ProjectKitchen/RoboFriend/datasheets/uc/pinout-b.png

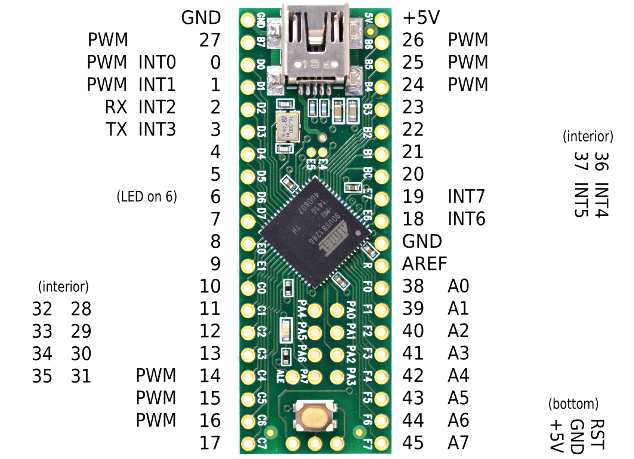
datasheets/uc/pinout-b.png
