ProjectKitchen/RoboFriend/src/TabletGUI/data/happyM.PNG

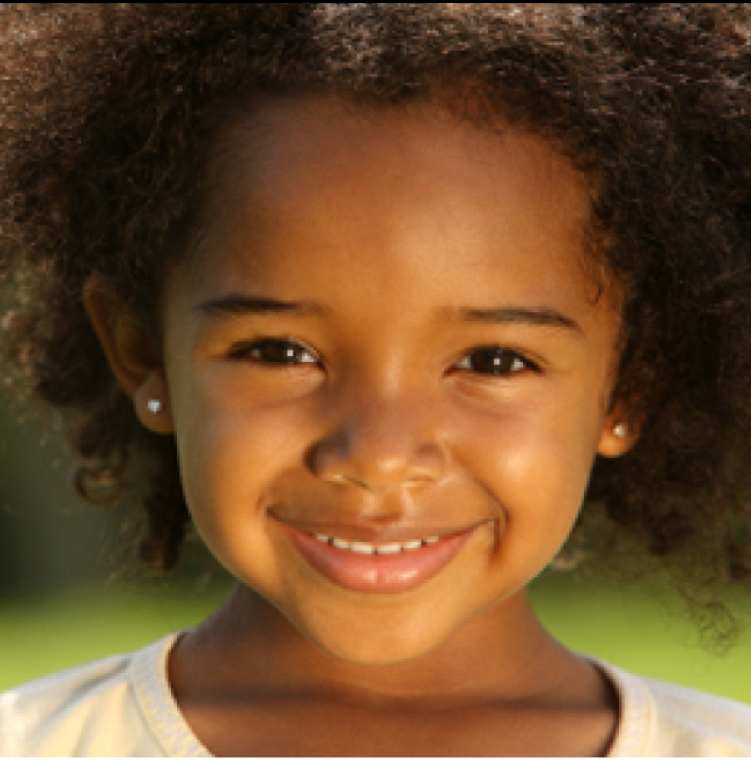
src/TabletGUI/data/happyM.PNG
