ProjectKitchen/RoboFriend/src/Teensy/README.md

# Source for arduino based µC: Teensy 2.0 ++

This folder need to be copied completely (foldername HAS to be same name as *.ino file)

It is advised to use Arduino IDE to open the files, because Arduino IDE automatically identifies the project with all its files. In Arduino IDE you also can easily upload your source code / project onto your µC.

Download ArduinoSerialCommand from https://github.com/scogswell/ArduinoSerialCommand as a zip file. Open Adruino IDE, select 'Sketch' from the file menu, 'Include Library' and add the .zip library to your hard drive. 

Download and information: https://www.arduino.cc/en/main/software
