ProjectKitchen/RoboFriend/datasheets/uc/info.txt

Teensy++ 2.0

Processor: 			AT90USB1286 - 8 bit AVR - 16 MHz
Flash Memory: 		128 kB, 130048 B (?)
RAM Memory:			8 kB, 8192 B
EEPROM:				4 kB, 4096 B
I/O:				46, 5 Volt
Analog in:			8
PWM:				9
UART, I2C, SPI:		1, 1, 1

Source: https://www.pjrc.com/teensy/
