ProjectKitchen/RoboFriend/documentation/Robofriend_Control_Text.odt

Robofriend Steuerung

# Einschalten

1. Kippschalter vorne unten umschalten (nach rechts)
2. Taster vorne unten drücken (danach hört man ein Klicken)
3. Warten bis Roboter „I am Robofriend“ sagt

# Ausschalten

1. Am Keyboard ESC + „exit“ + ENTER eingeben
2. Warten bis Bildschirm schwarz ist
3. Kippschalter vorne unten umschalten (nach links)

Mit „quit“ wird nur das Robofriend-Programm beendet, der Raspberry Pi aber nicht heruntergefahren.

# Bewegen

Drücken der 4 Pfeiltasten auf der beiliegenden Tastatur.

# Sprechen und Geräusche

Drücken von entsprechenden Tasten auf der Tastatur:

- 1 = „Hallo, wie gehts?“
- 2 = „Danke, mir geht es gut.“
- 3 = „Willst du etwas zum knabbern?“
- 4 = „Bitte, gerne.“
- 5 = „Wie heißt du?“
- 6 = „Ich heiße Robofreund.“
- 7 = „Mir ist langweilig“
- 8 = „Heute ist ein schöner Tag.“
- 9 = Zufällige Sätze / Sprüche (z.B. „Hallo“, „Darf ich dir etwas bringen?“, …)
- 0 = Zufällige, lustige/dumme Sätze und Sprüche
- Tippen eines oder mehrerer Wörter auf Tastatur + ENTER = beliebige Wörter oder Sätze
- ESC = Löschen von eingegebenem Text (z.B. bei Tippfehler)
- BACKSPACE = letzten gesprochenen Satz/Wort (über Tastatur eingegeben) wiederholen
- „<“ = mehr Lächeln
- „>“ = weniger Lächeln
- ? = zufälliger Sound
- | = letzter Sound nochmal spielen
