ProjectKitchen/RoboFriend/datasheets/uc/pinout.xlsx

Sheet: Teensy++ 2.0
Ports |  | Port Pin | Used as | # | Standard Function | Alternate Functions |  |  |  |  | Alternate Functions |  |  | Standard Function | # | Used as | Port Pin
 |  |  |  |  |  | 1 | 2 | 3 |  |  | 3 | 2 | 1
A | D | GND | GND |  |  |  |  |  | GND | 5V |  |  |  |  |  | 5V | 5V
 |  | PB7 | MLeDec | 27 | PWM | OC0A | OC1C |  | PB7 | PB6 |  |  | OC1B | PWM | 26 | MLeInc | PB6
B | E | PD0 | SCL | 0 | PWM | INT0 | SCL | 0C.0B | PD0 | PB5 |  |  | OC1A | PWM | 25 | MRiDec | PB5
 |  | PD1 | SDA | 1 | PWM | INT1 | SDA | OC.2B | PD1 | PB4 |  |  | OC2A | PWM | 24 | MRiInc | PB4
C | F | PD2 | RX | 2 | RX | INT2 | RXD1 |  | PD2 | PB3 |  |  | MISO | SPI | 23 | MISO | PB3
 |  | PD3 | TX | 3 | TX | INT3 | TXD1 |  | PD3 | PB2 |  |  | MOSI | SPI | 22 | MOSI | PB2
 |  | PD4 | US1Echo | 4 |  | ICP1 |  |  | PD4 | PB1 |  |  | SCK | SPI | 21 | SCK | PB1
 |  | PD5 | US1Trig | 5 |  | XCK1 |  |  | PD5 | PB0 |  |  | SS | SPI | 20 | SS | PB0
 |  | PD6 | US2Echo | 6 |  | T1 |  |  | PD6 | PE7 |  | AIN.1 | INT7 |  | 19 | OC | PE7
 |  | PD7 | US2Trig | 7 |  | T0 |  |  | PD7 | PE6 |  | AIN.0 | INT6 |  | 18 | OCINT | PE6
 |  | PE0 | US3Echo | 8 |  | - |  |  | PE0 | GND |  |  |  |  |  | GND | GND
 |  | PE1 | US3Trig | 9 |  | - |  |  | PE1 | AREF |  |  |  |  |  | AREF | AREF
 |  | PC0 | MRiFwd | 10 |  | - |  |  | PC0 | PF0 |  |  | ADC0 | Analog | 38 | VBAT | PF0
 |  | PC1 | MRiBck | 11 |  | - |  |  | PC1 | PF1 |  |  | ADC1 | Analog | 39 | ADC1 | PF1
 |  | PC2 | MLeFwd | 12 |  | - |  |  | PC2 | PF2 |  |  | ADC2 | Analog | 40 | ADC2 | PF2
 |  | PC3 | MLeBck | 13 |  | T3 |  |  | PC3 | PF3 |  |  | ADC3 | Analog | 41 | ADC3 | PF3
 |  | PC4 | MRiPwm | 14 | PWM | OC.3C |  |  | PC4 | PF4 |  |  | ADC4 | Analog | 42 | ADC4 | PF4
 |  | PC5 | MLePwm | 15 | PWM | OC.3B |  |  | PC5 | PF5 |  |  | ADC5 | Analog | 43 | ADC5 | PF5
 |  | PC6 | US4Trig | 16 | PWM | OC.3A |  |  | PC6 | PF6 |  |  | ADC6 | Analog | 44 | INA193 | PF6
 |  | PC7 | US4Echo | 17 |  | ICP3 |  |  | PC7 | PF7 |  |  | ADC7 | Analog | 45 |  | PF7
 |  | AINN: Analog Comparator Positive Input, Analog Comparator Negative input
 |  | ICPN: Timer/CounterN Input Capture Trigger, can act as an input capture pin
 |  | INTN: External Interrupt N, External Interrupt source
 |  | MISO: SPI Bus Master Input/Slave Output
 |  | MOSI: SPI Bus Master Output/Slave Input
 |  | OC.NX: Output Compare and PWM Output X for Timer/CounterN
 |  | SCK: SPI Bus Serial Clock
 |  | SCL: TWI Serial Clock
 |  | SDA: TWI Serial Data
 |  | SS: SPI Slave Select input
 |  | RXDN: USARTN Receive Pin
 |  | TN: Timer/CounterN Clock Input, Timer/CounterN counter source
 |  | TXDN: USARTN Transmit Pin
 |  | XCKN: USARTN External Clock Input/Output

Sheet: Teensy++ 2.0_Paper
Ports |  | Port Pin | # | Standard Function | Alternate Functions |  |  |  |  | Alternate Functions |  |  | Standard Function | # | Port Pin
 |  |  |  |  | 1 | 2 | 3 |  |  | 3 | 2 | 1
A | D | GND |  |  |  |  |  | GND | 5V |  |  |  |  |  | 5V
 |  | PB7 | 27 | PWM | OC0A | OC1C |  | PB7 | PB6 |  |  | OC1B | PWM | 26 | PB6
B | E | PD0 | 0 | PWM | INT0 | SCL | 0C.0B | PD0 | PB5 |  |  | OC1A | PWM | 25 | PB5
 |  | PD1 | 1 | PWM | INT1 | SDA | OC.2B | PD1 | PB4 |  |  | OC2A | PWM | 24 | PB4
C | F | PD2 | 2 | RX | INT2 | RXD1 |  | PD2 | PB3 |  |  | MISO | SPI | 23 | PB3
 |  | PD3 | 3 | TX | INT3 | TXD1 |  | PD3 | PB2 |  |  | MOSI | SPI | 22 | PB2
 |  | PD4 | 4 |  | ICP1 |  |  | PD4 | PB1 |  |  | SCK | SPI | 21 | PB1
 |  | PD5 | 5 |  | XCK1 |  |  | PD5 | PB0 |  |  | SS | SPI | 20 | PB0
 |  | PD6 | 6 |  | T1 |  |  | PD6 | PE7 |  | AIN.1 | INT7 |  | 19 | PE7
 |  | PD7 | 7 |  | T0 |  |  | PD7 | PE6 |  | AIN.0 | INT6 |  | 18 | PE6
 |  | PE0 | 8 |  | - |  |  | PE0 | GND |  |  |  |  |  | GND
 |  | PE1 | 9 |  | - |  |  | PE1 | AREF |  |  |  |  |  | AREF
 |  | PC0 | 10 |  | - |  |  | PC0 | PF0 |  |  | ADC0 | Analog | 38 | PF0
 |  | PC1 | 11 |  | - |  |  | PC1 | PF1 |  |  | ADC1 | Analog | 39 | PF1
 |  | PC2 | 12 |  | - |  |  | PC2 | PF2 |  |  | ADC2 | Analog | 40 | PF2
 |  | PC3 | 13 |  | T3 |  |  | PC3 | PF3 |  |  | ADC3 | Analog | 41 | PF3
 |  | PC4 | 14 | PWM | OC.3C |  |  | PC4 | PF4 |  |  | ADC4 | Analog | 42 | PF4
 |  | PC5 | 15 | PWM | OC.3B |  |  | PC5 | PF5 |  |  | ADC5 | Analog | 43 | PF5
 |  | PC6 | 16 | PWM | OC.3A |  |  | PC6 | PF6 |  |  | ADC6 | Analog | 44 | PF6
 |  | PC7 | 17 |  | ICP3 |  |  | PC7 | PF7 |  |  | ADC7 | Analog | 45 | PF7
 |  | AINN: Analog Comparator Positive Input, Analog Comparator Negative input
 |  | ICPN: Timer/CounterN Input Capture Trigger, can act as an input capture pin
 |  | INTN: External Interrupt N, External Interrupt source
 |  | MISO: SPI Bus Master Input/Slave Output
 |  | MOSI: SPI Bus Master Output/Slave Input
 |  | OC.NX: Output Compare and PWM Output X for Timer/CounterN
 |  | SCK: SPI Bus Serial Clock
 |  | SCL: TWI Serial Clock
 |  | SDA: TWI Serial Data
 |  | SS: SPI Slave Select input
 |  | RXDN: USARTN Receive Pin
 |  | TN: Timer/CounterN Clock Input, Timer/CounterN counter source
 |  | TXDN: USARTN Transmit Pin
 |  | XCKN: USARTN External Clock Input/Output
