ProjectKitchen/RoboFriend/documentation/Robofriend Mappe/5_Power Supply/PCB overview.pdf

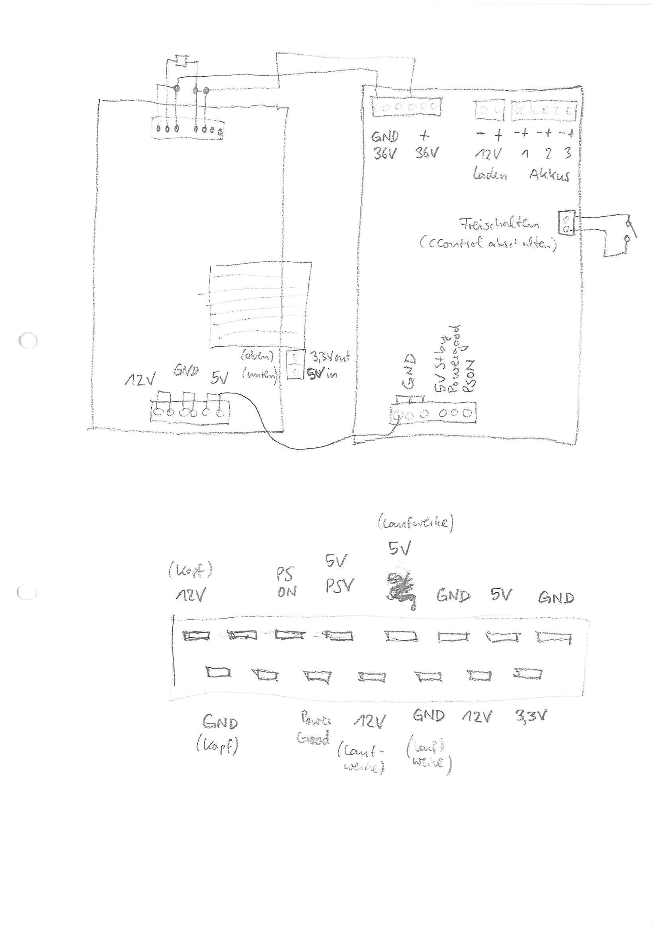
[picture p3: page 1]
