ProjectKitchen/RoboFriend/documentation/Robofriend_Control_Image.pdf

# Robofriend Steuerung

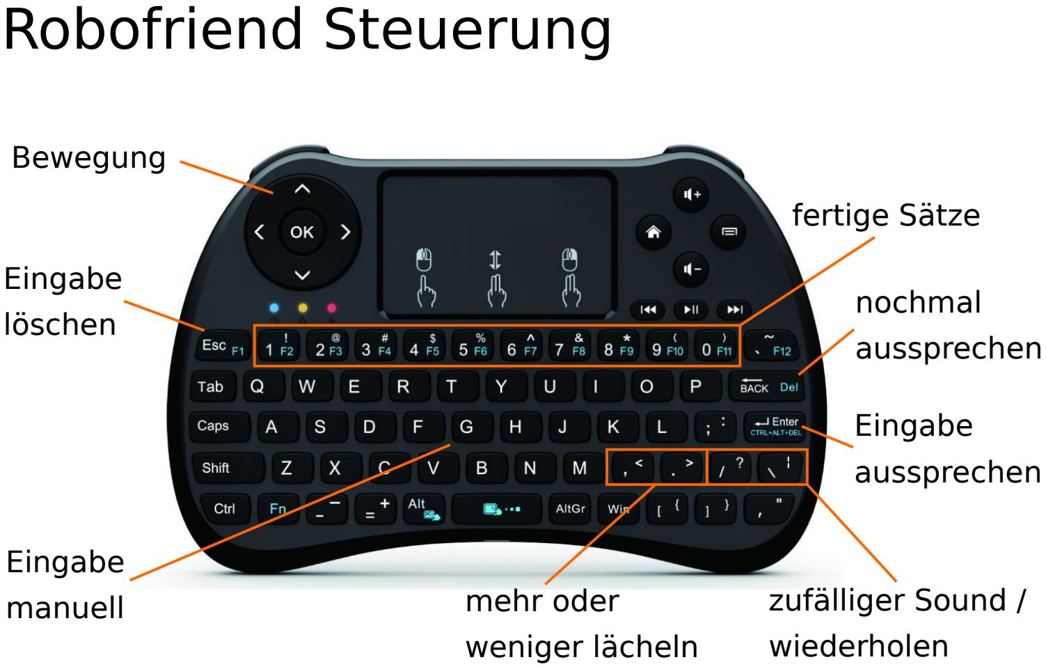
[picture p4: page 1]

fertige Sätze

Eingabe
löschen

Bewegung

Eingabe
aussprechen

mehr oder
weniger lächeln

Eingabe
manuell | zufälliger Sound /
| wiederholen

nochmal
aussprechen
