ProjectKitchen/RoboFriend/documentation/Robofriend Mappe/1_Front/CAD.pdf

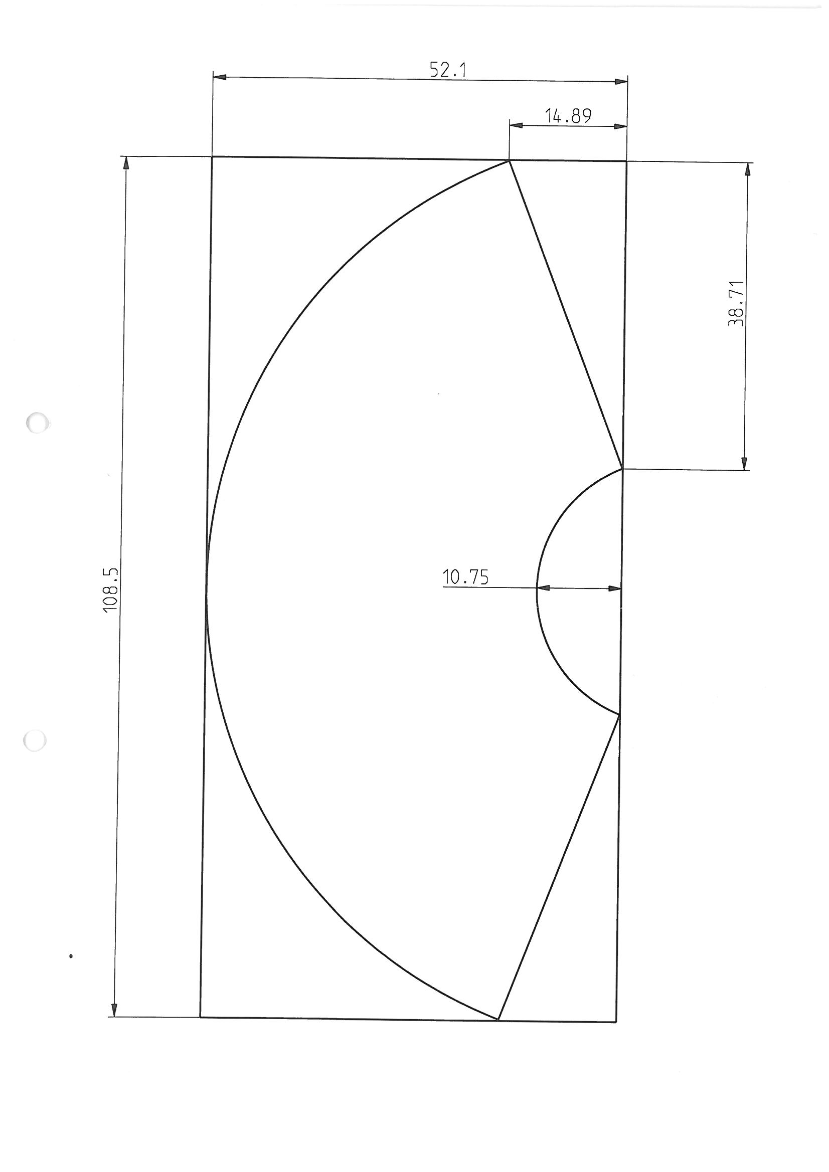
[picture p44: page 1]
