ProjectKitchen/RoboFriend/documentation/Robofriend Mappe/1_Front/Conrad RF leser antenne.pdf

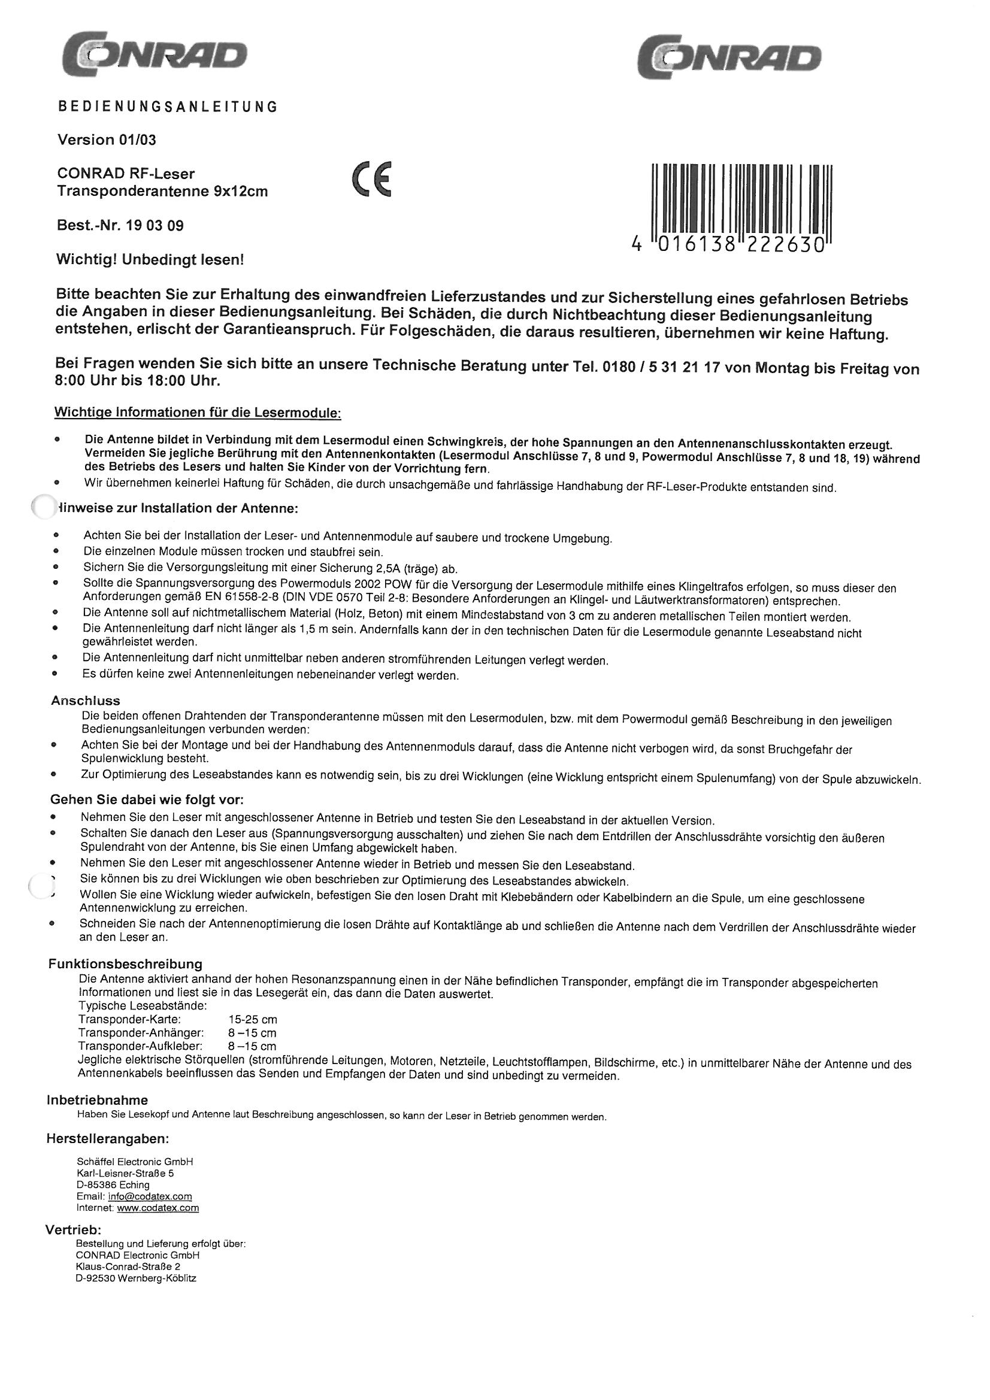
[picture p45: page 1]
