ProjectKitchen/RoboFriend/documentation/Robofriend Mappe/1_Front/Ladeelektronik Schaltung.pdf

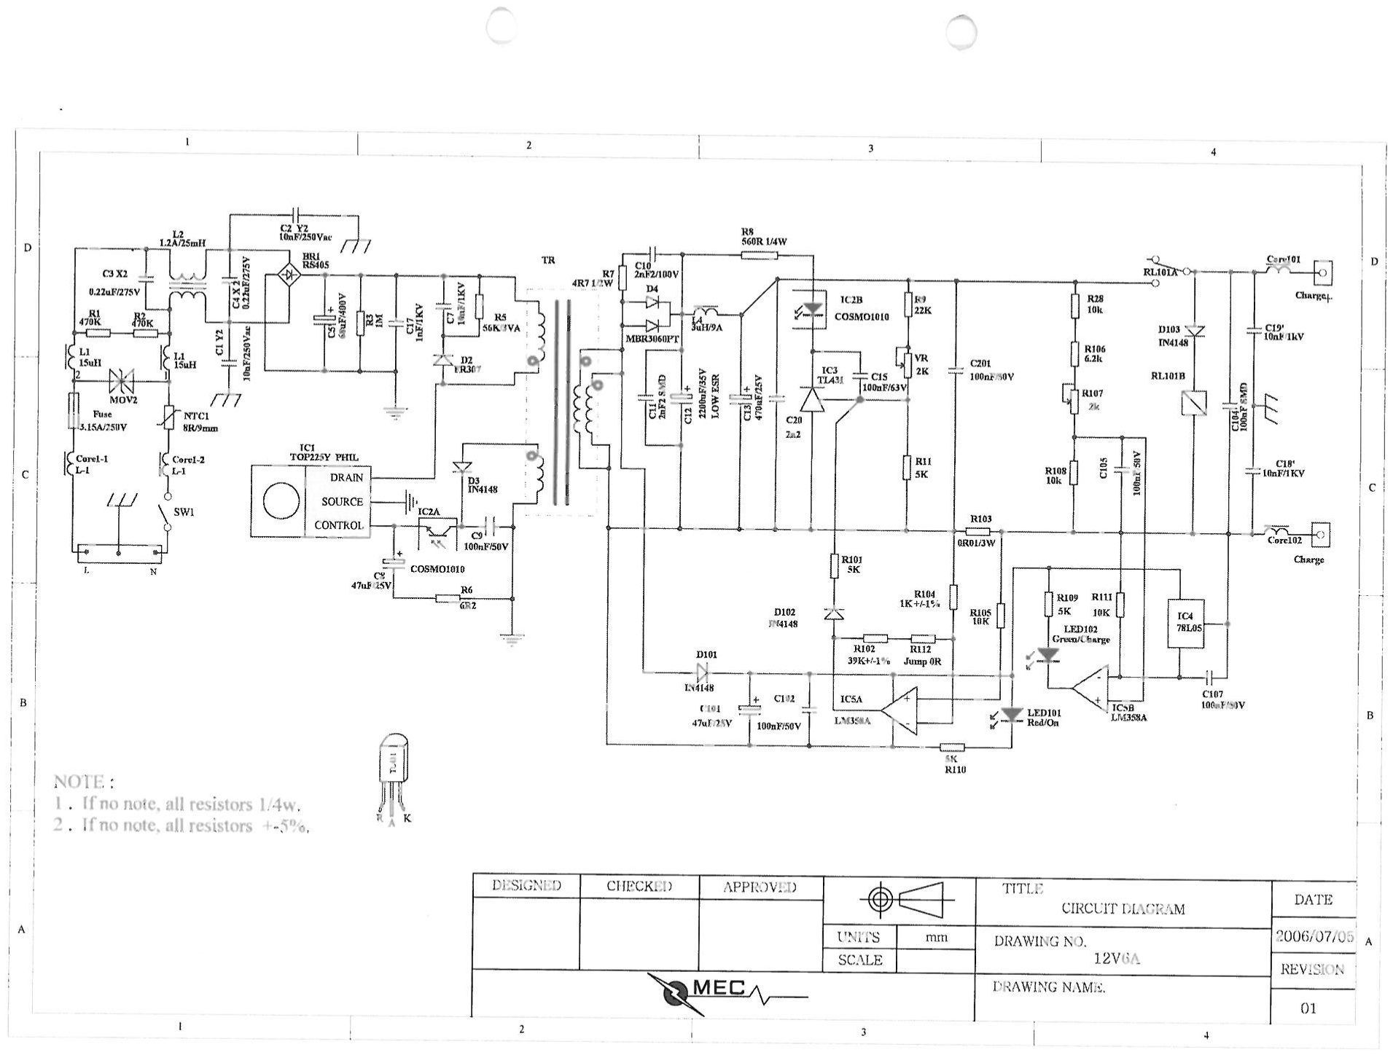
[picture p46: page 1]
