ProjectKitchen/RoboFriend/documentation/Robofriend Mappe/1_Front/Logo und Liste.pdf

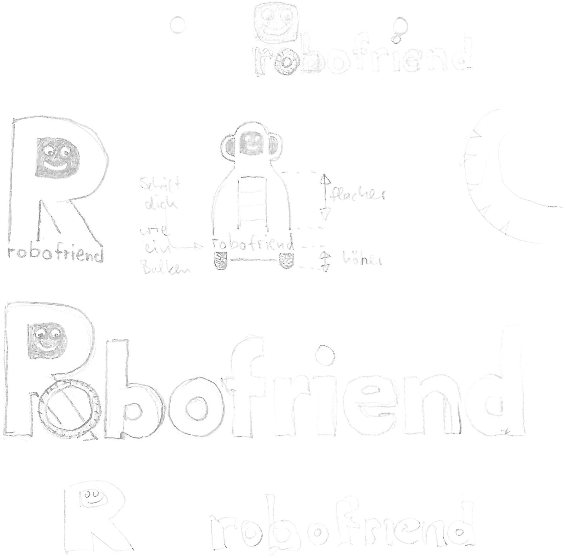
[picture p47: page 1]
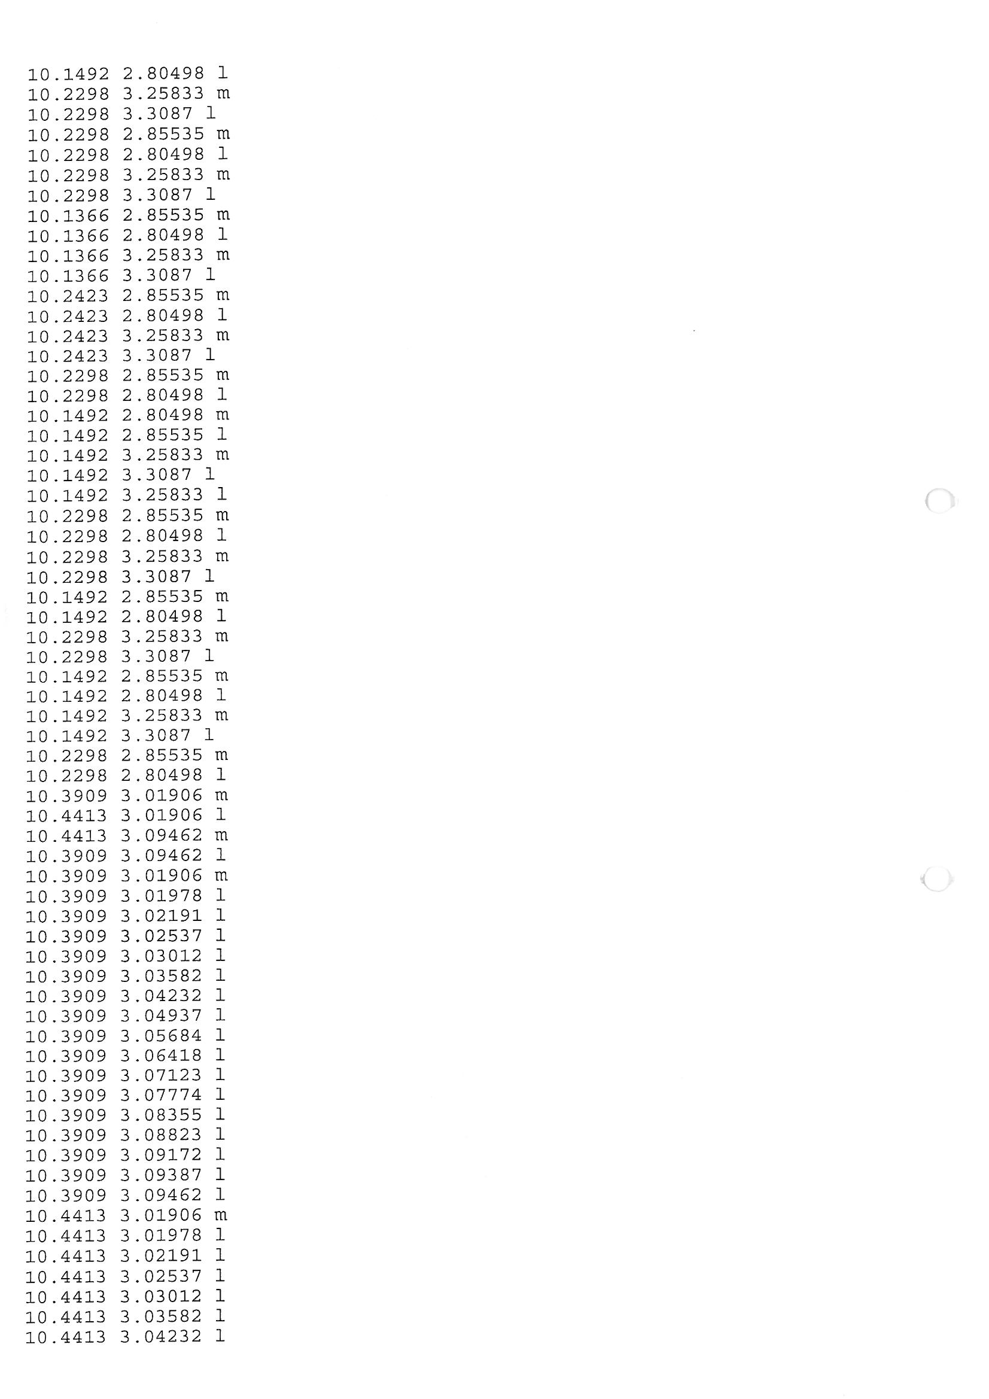
[picture p48: page 2]
