ProjectKitchen/RoboFriend/documentation/Robofriend Mappe/1_Front/Notizen des Ladetests.pdf

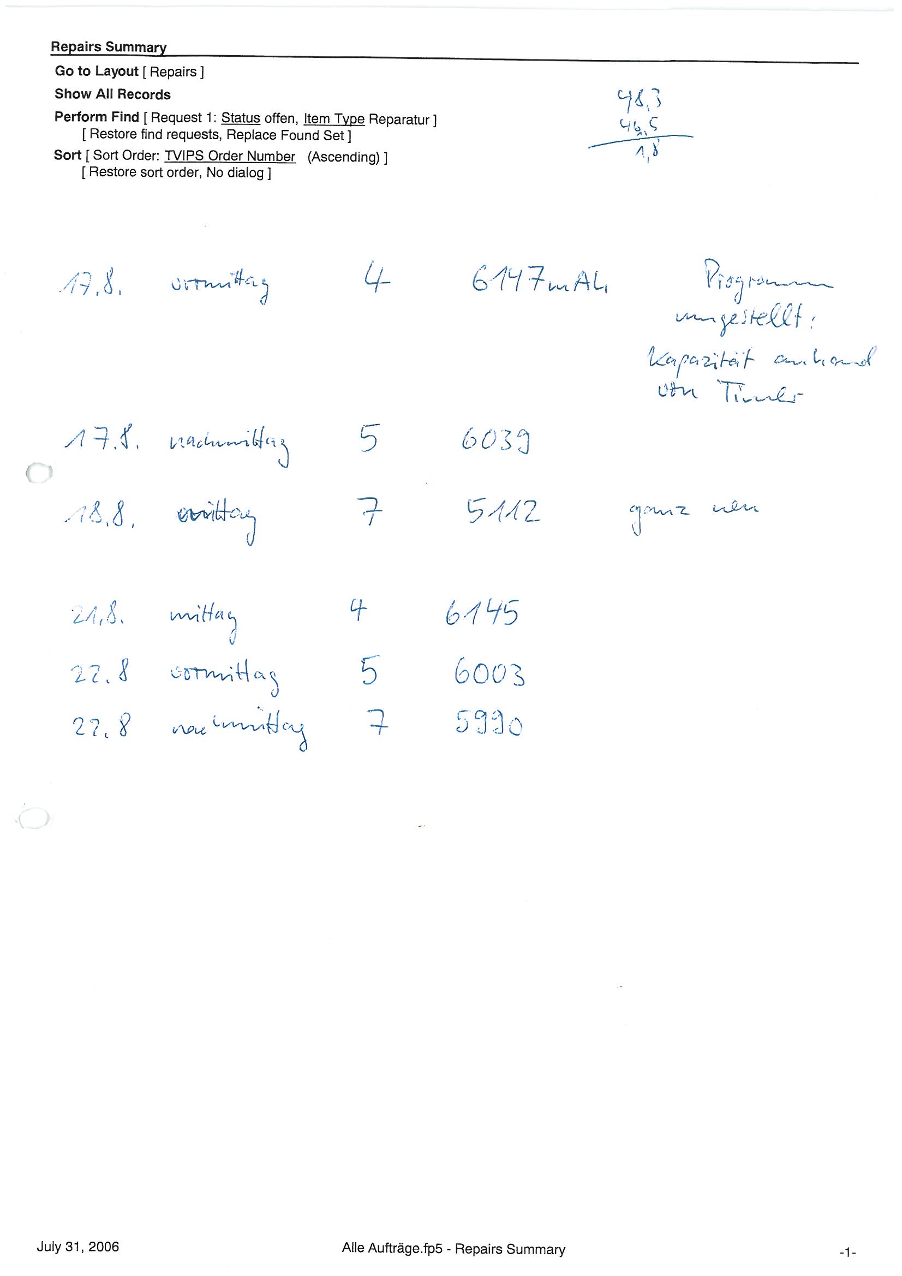
[picture p49: page 1]
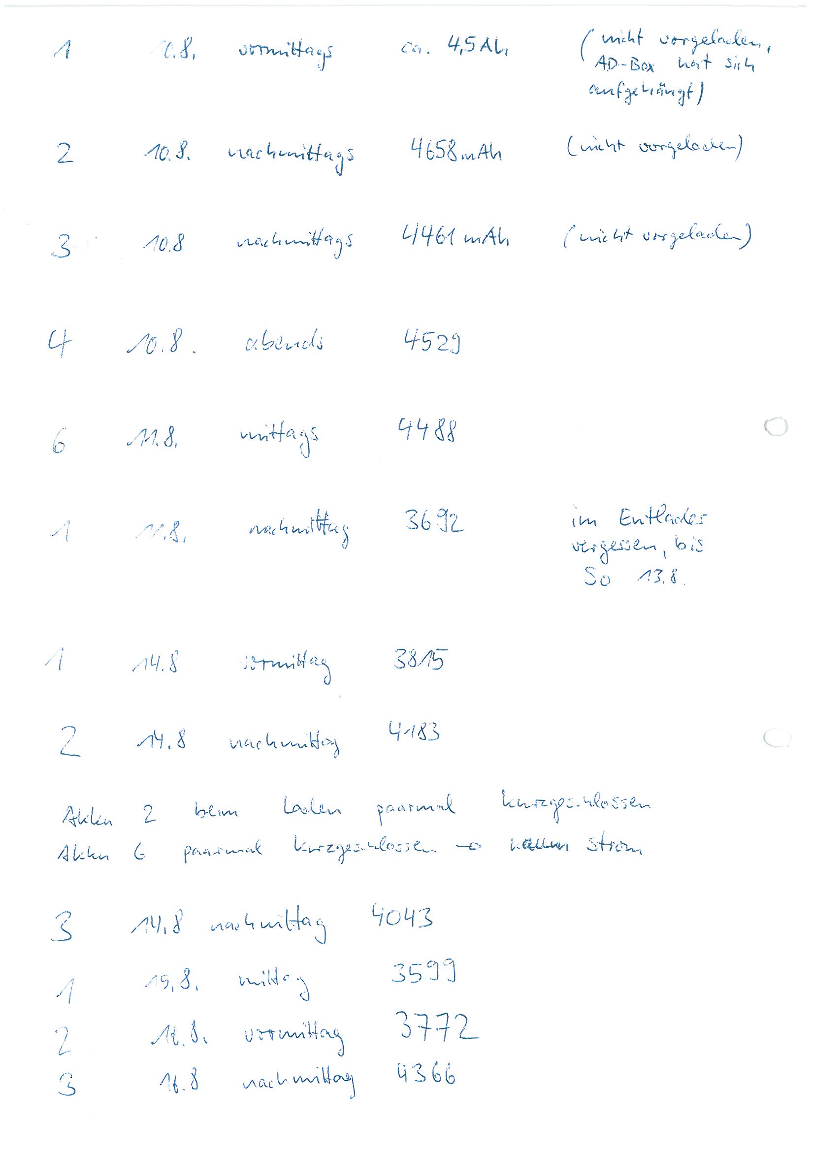
[picture p50: page 2]
