ProjectKitchen/RoboFriend/documentation/Robofriend Mappe/1_Front/Notizen Motorstrg.pdf

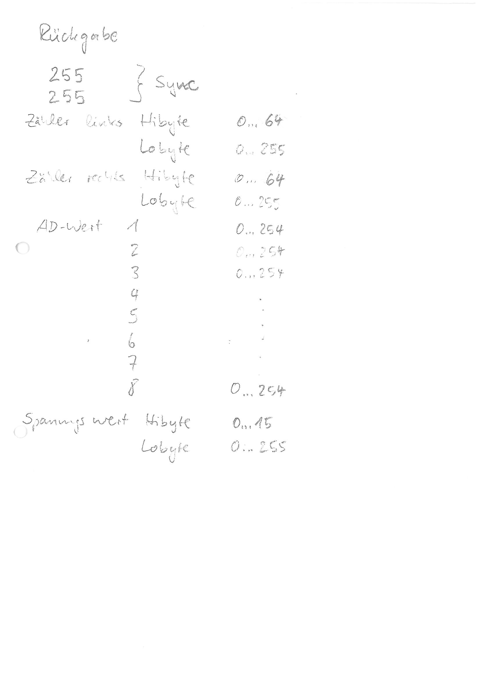
[picture p51: page 1]
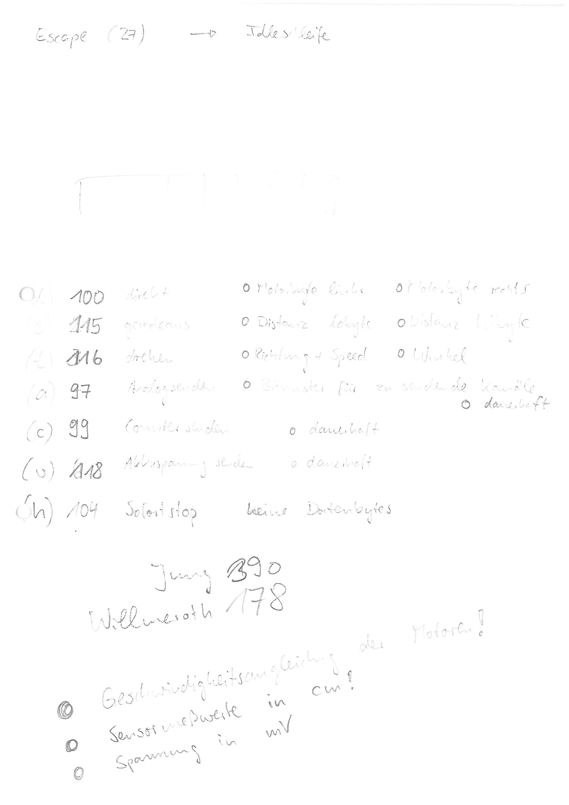
[picture p52: page 2]
