ProjectKitchen/RoboFriend/documentation/Robofriend Mappe/1_Front/PCB layout.pdf

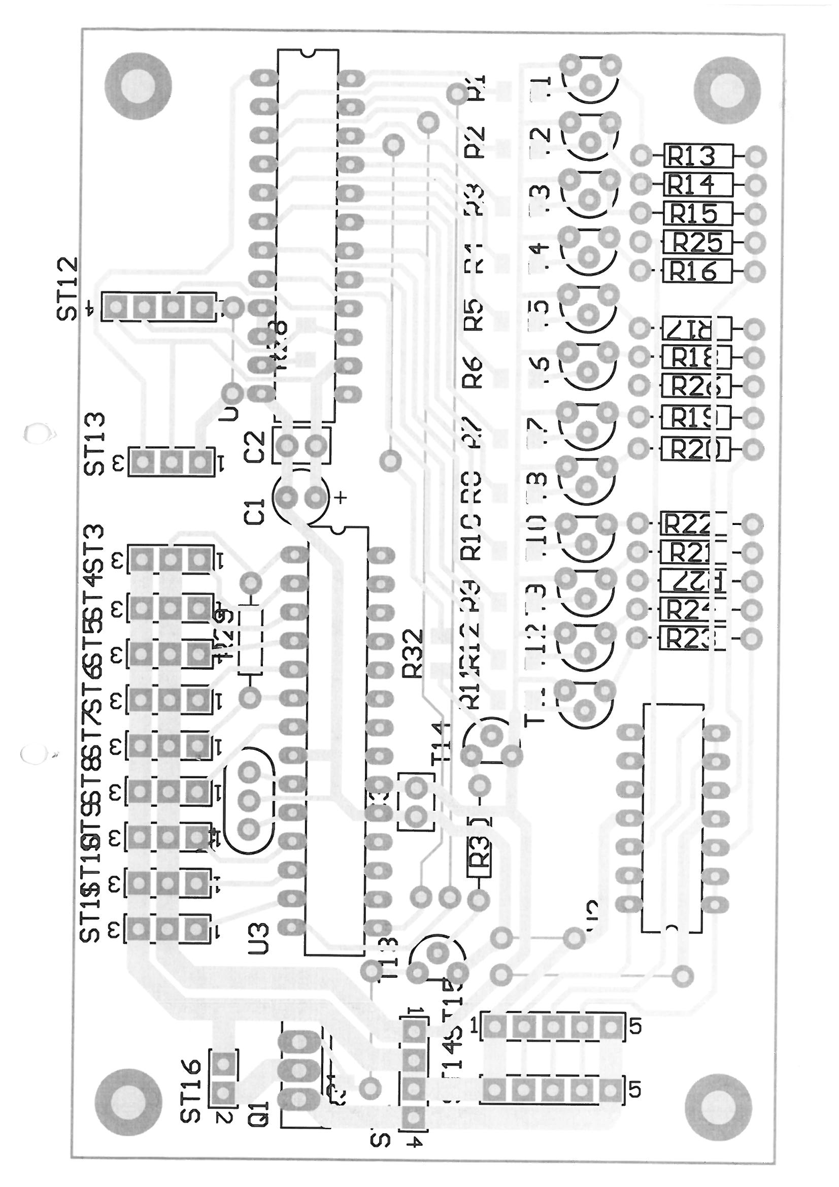
[picture p53: page 1]
