ProjectKitchen/RoboFriend/documentation/Robofriend Mappe/1_Front/RF Adapter sch.pdf

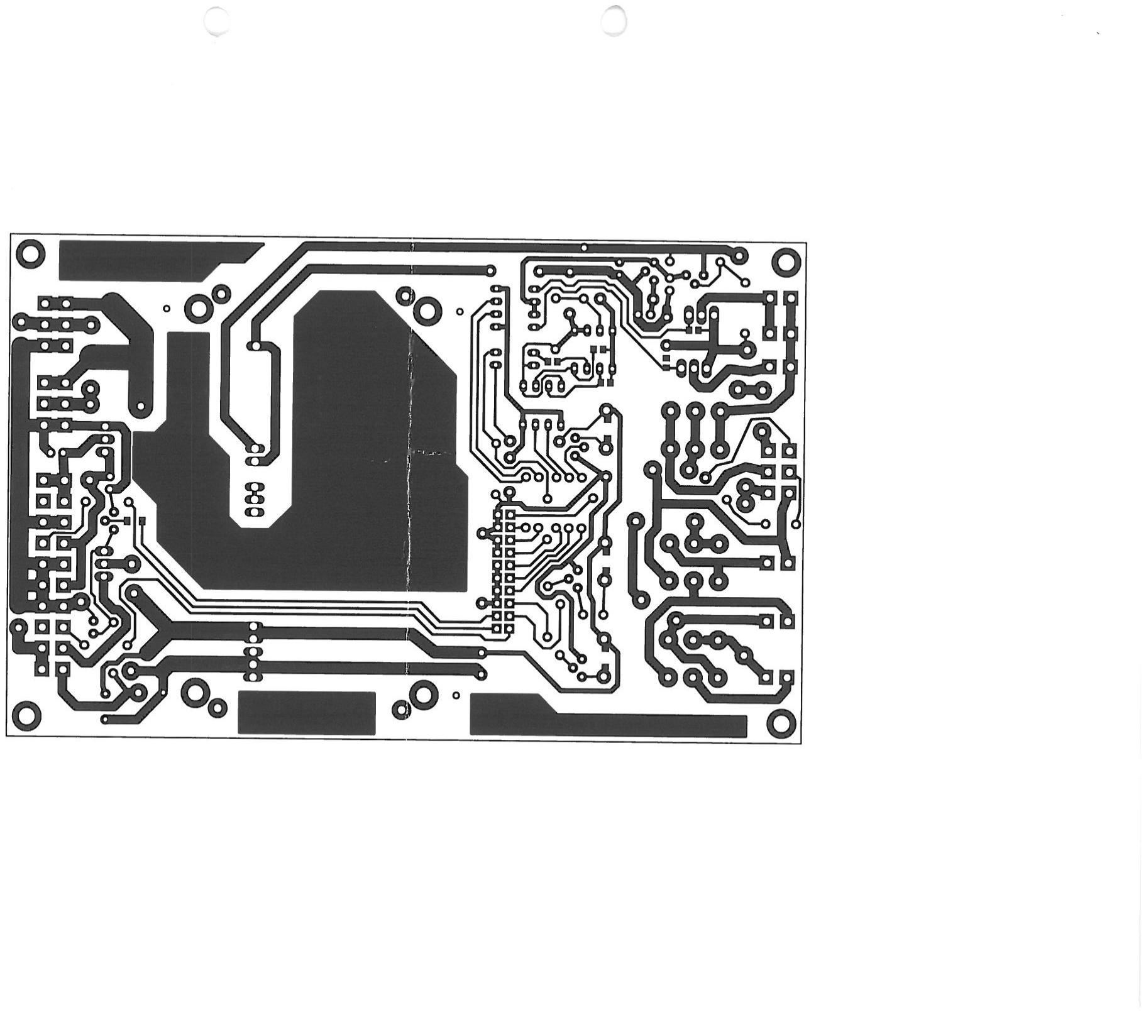
[picture p54: page 1]
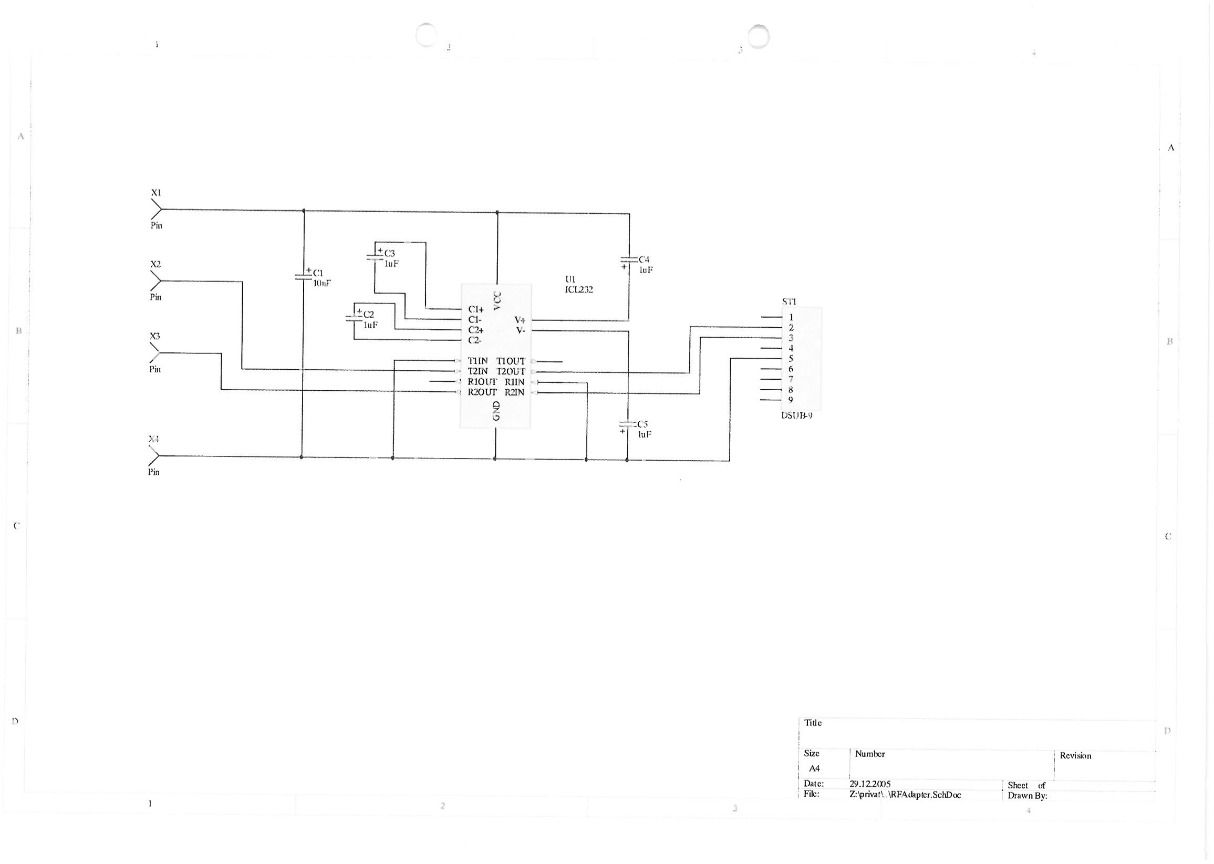
[picture p55: page 2]
