ProjectKitchen/RoboFriend/documentation/Robofriend Mappe/1_Front/SFH610A optokoppler ds.pdf

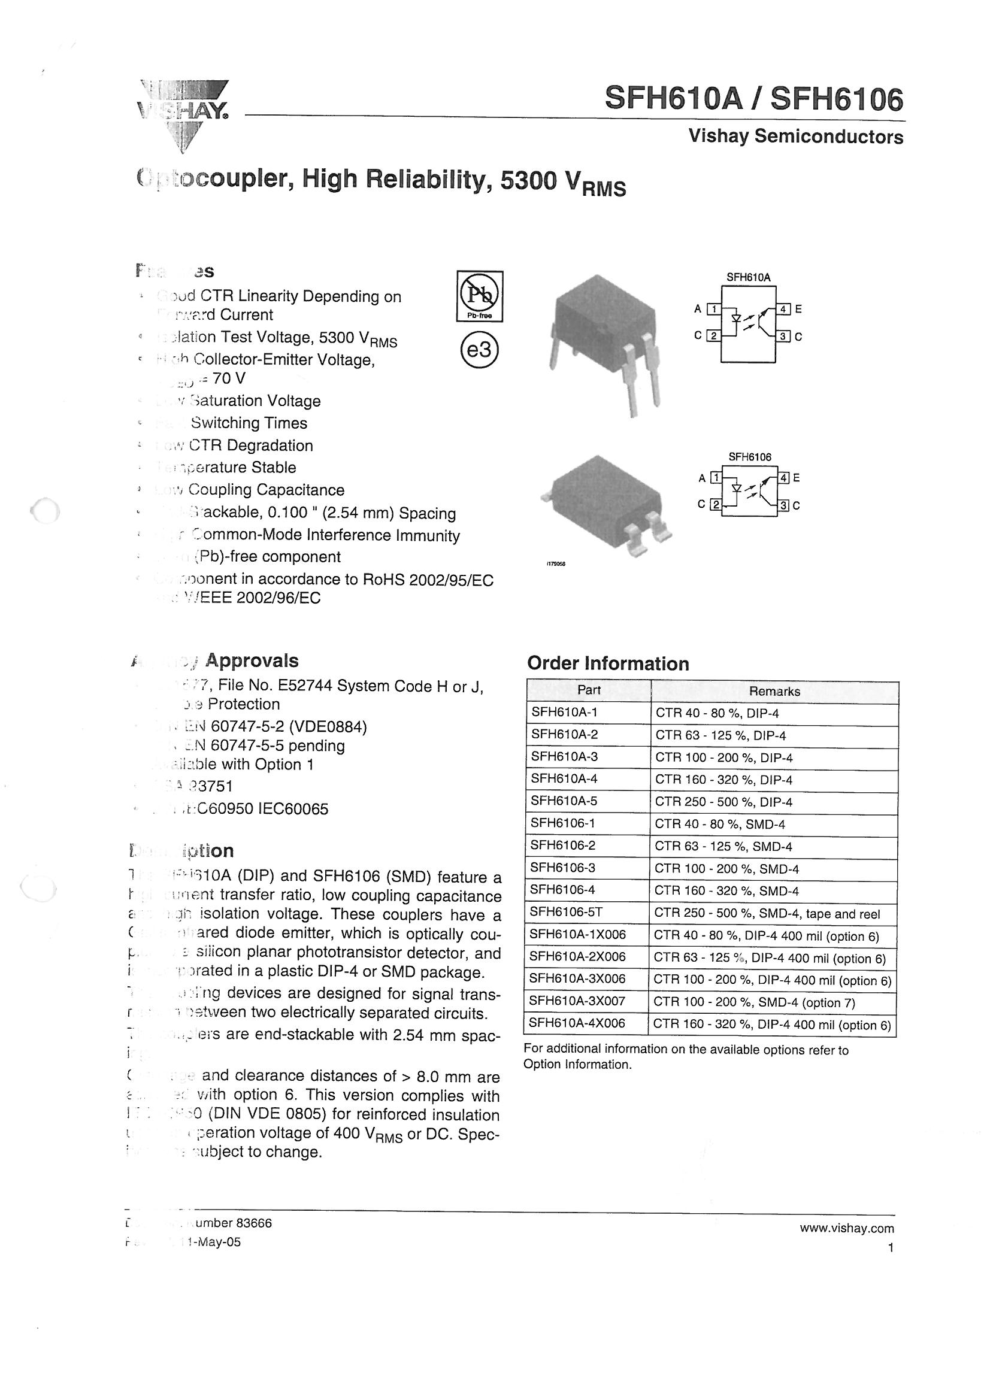
[picture p56: page 1]
