ProjectKitchen/RoboFriend/documentation/Robofriend Mappe/1_Front/USB cont2 sch + notes.pdf

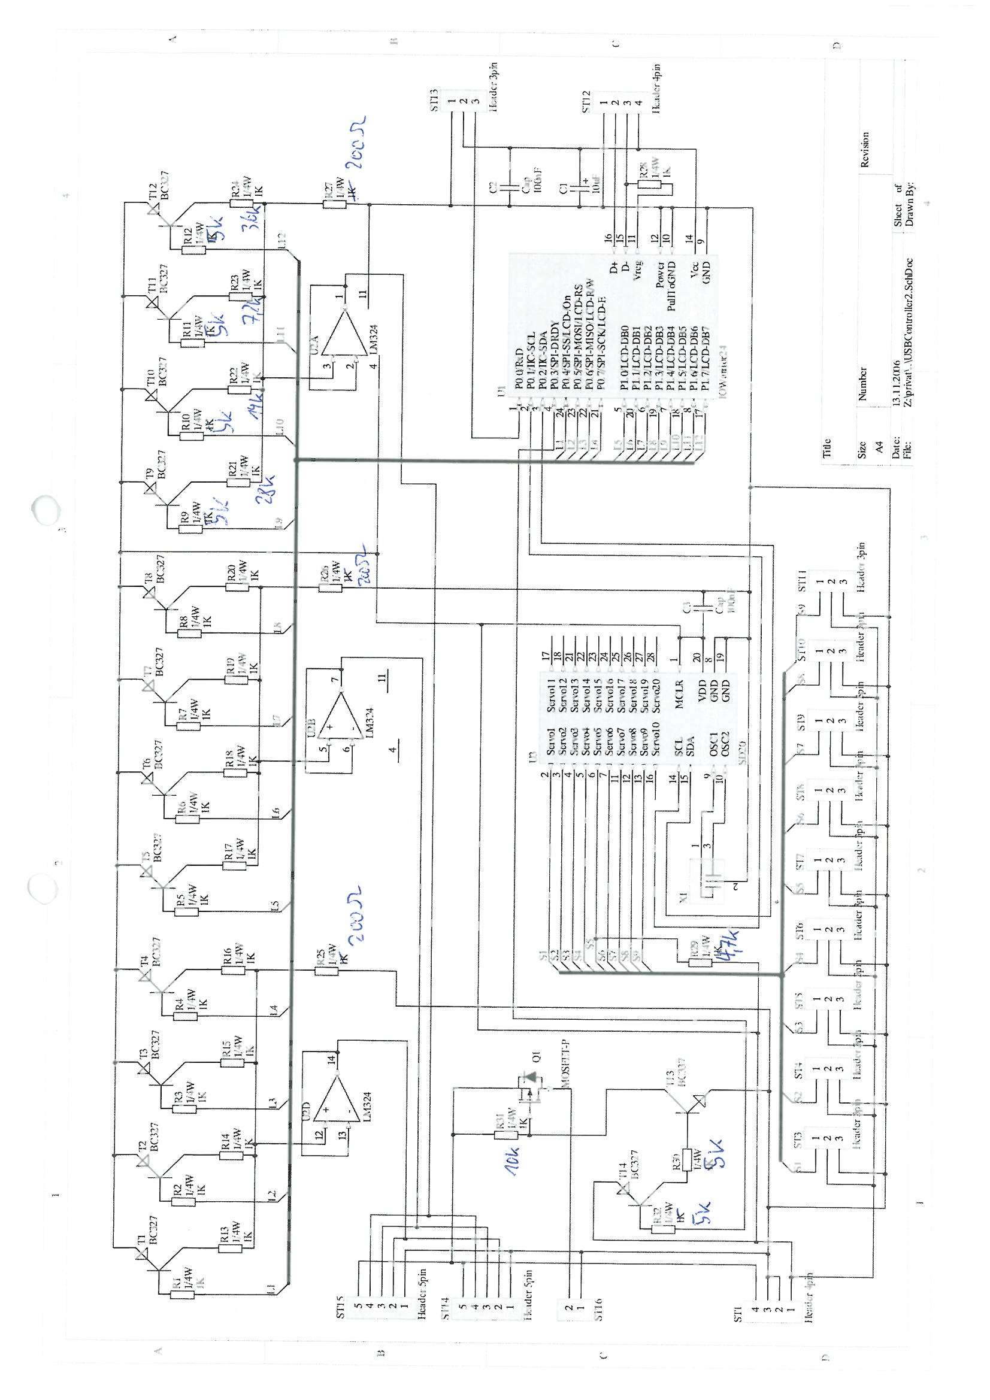
[picture p57: page 1]
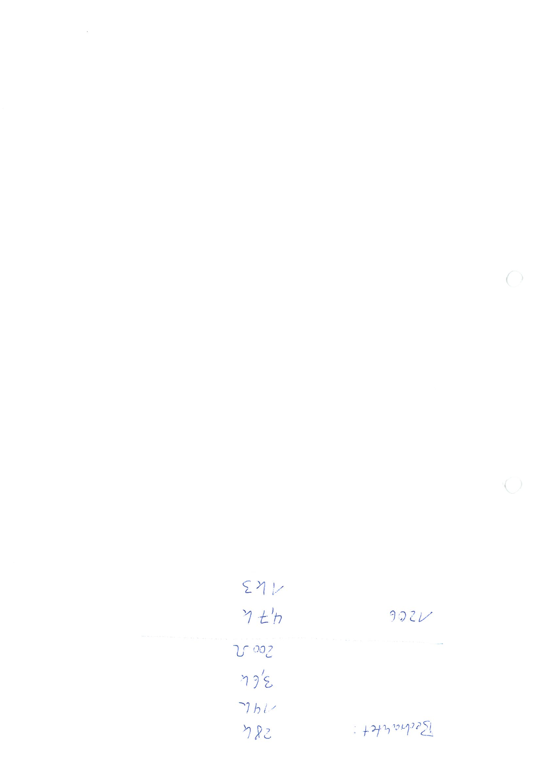
[picture p58: page 2]
