ProjectKitchen/RoboFriend/documentation/Robofriend Mappe/2_Kopf/webcam pinbelegung.pdf

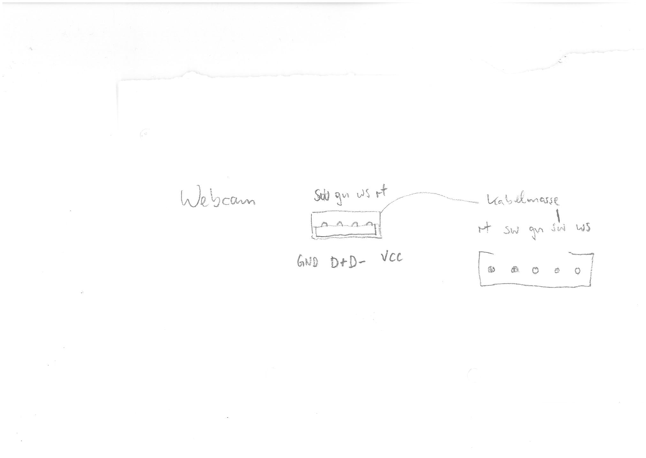
[picture p59: page 1]
