ProjectKitchen/RoboFriend/documentation/Robofriend Mappe/3_Sensors/AV board.pdf

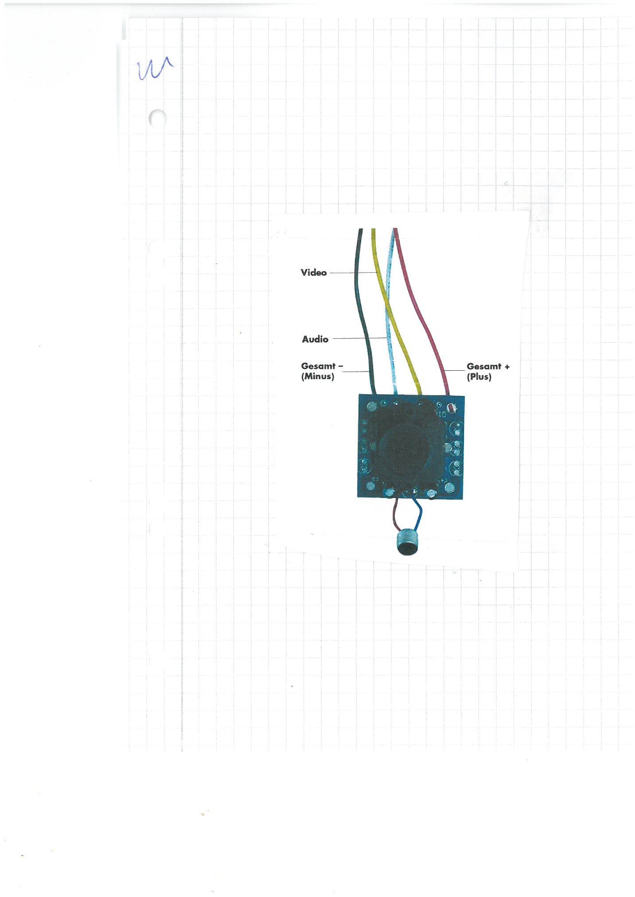
[picture p60: page 1]
