ProjectKitchen/RoboFriend/documentation/Robofriend Mappe/3_Sensors/CAT5112 prog poti ds.pdf

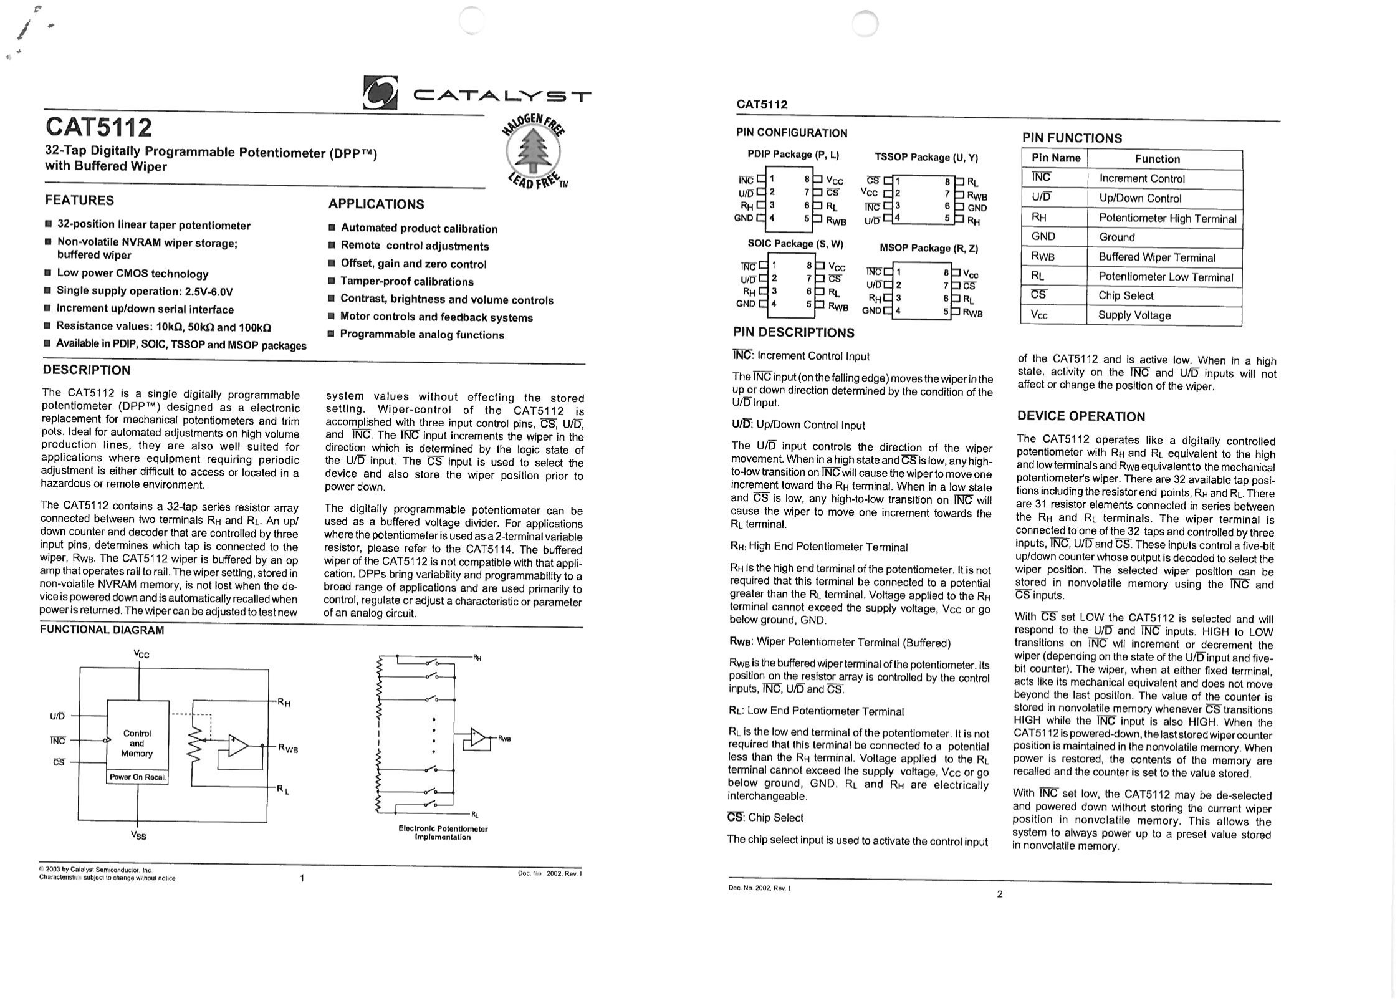
[picture p61: page 1]
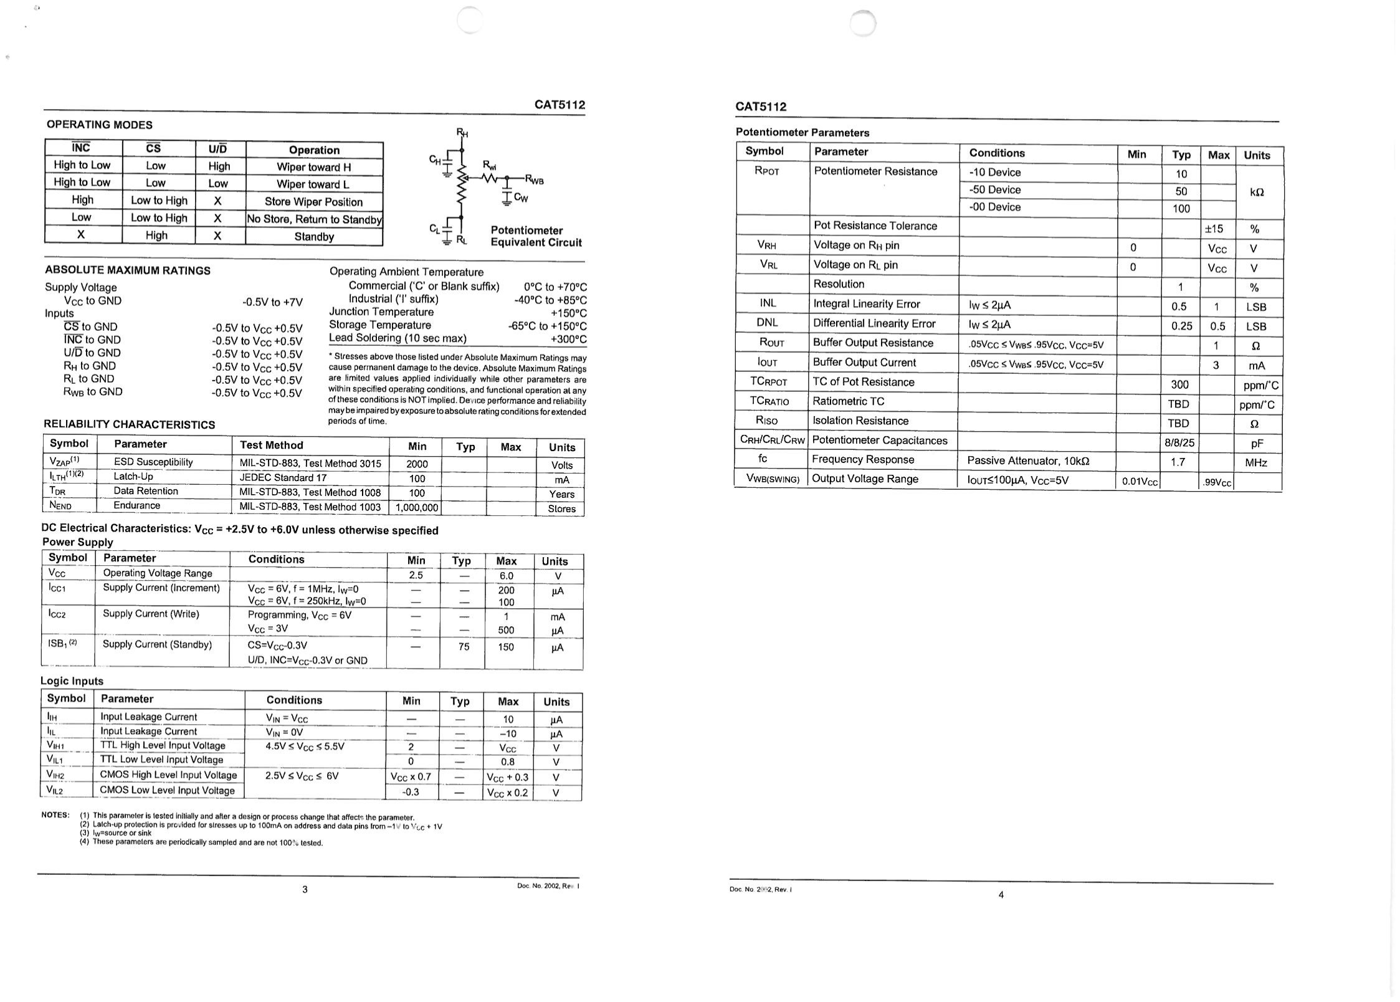
[picture p62: page 2]
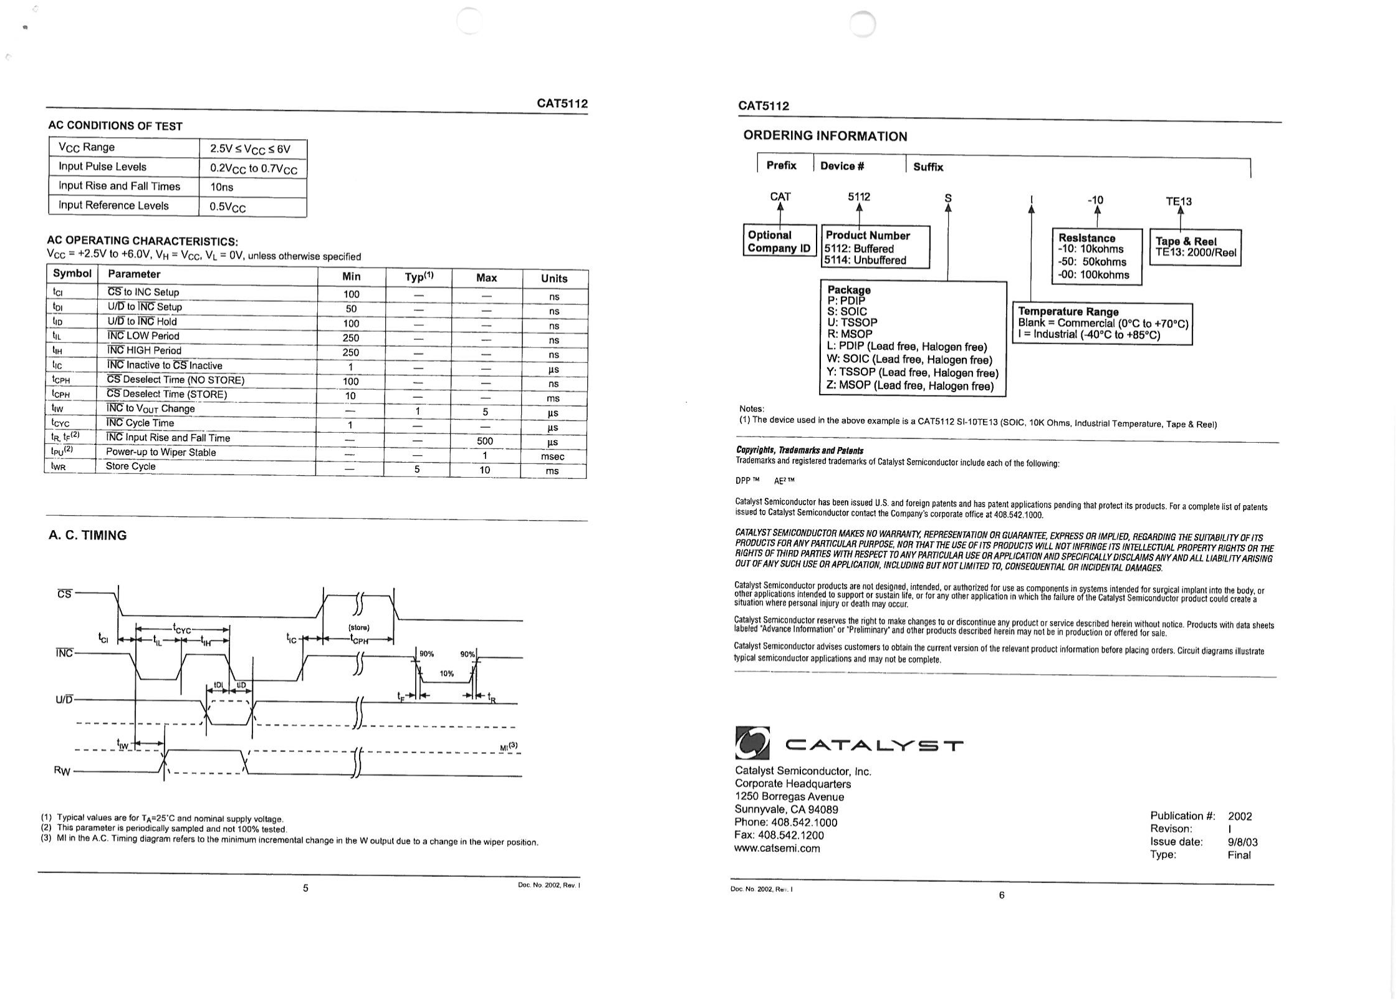
[picture p63: page 3]
