ProjectKitchen/RoboFriend/documentation/Robofriend Mappe/3_Sensors/ICL232 RS-232 TxRx ds.pdf

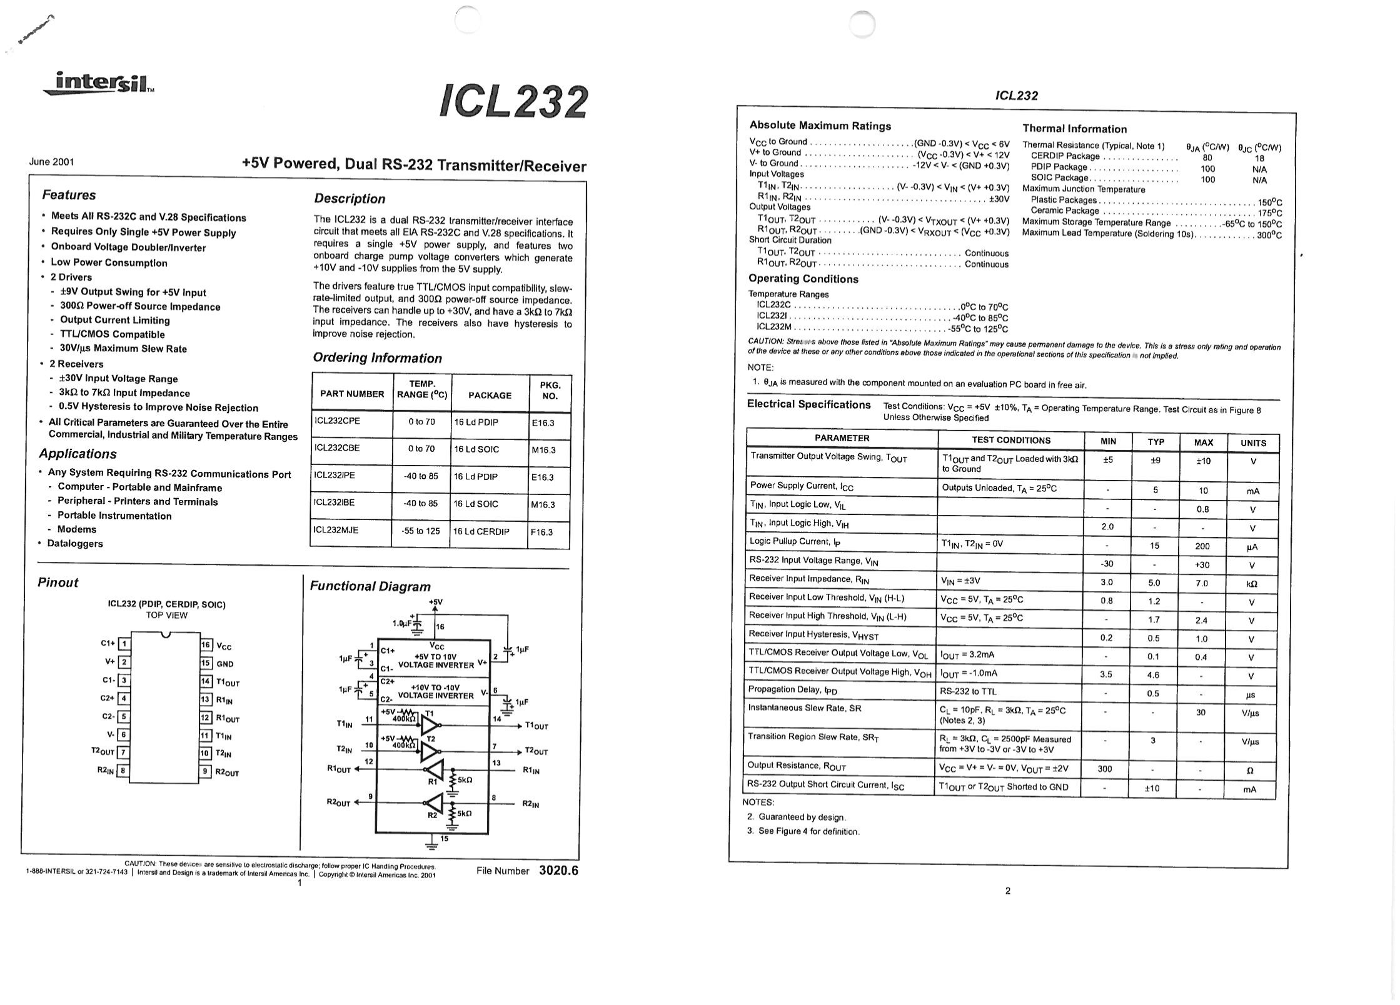
[picture p64: page 1]
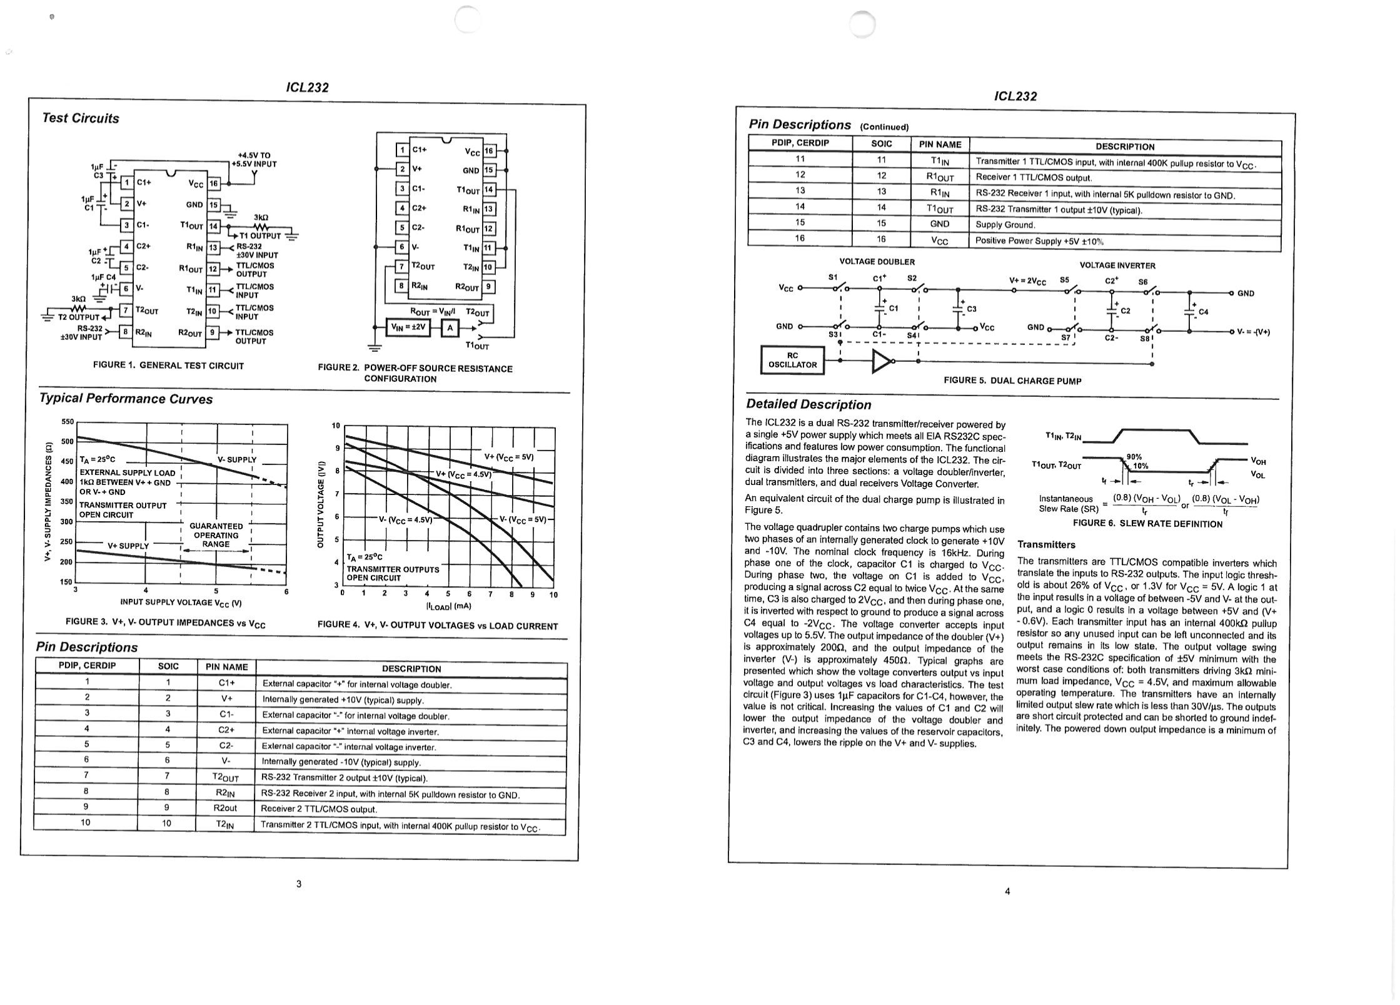
[picture p65: page 2]
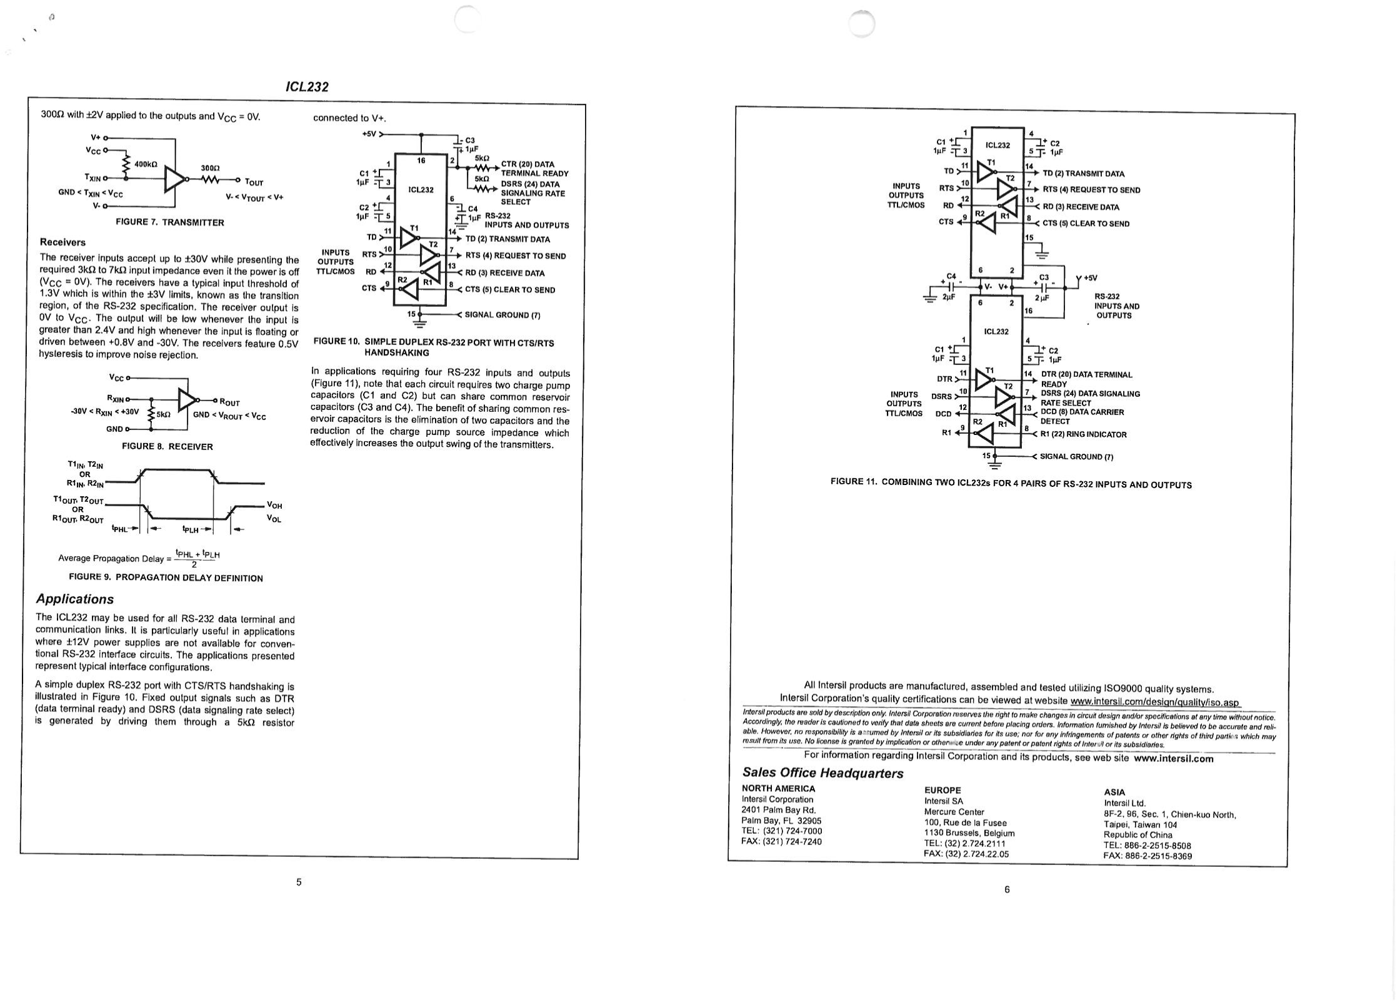
[picture p66: page 3]
