ProjectKitchen/RoboFriend/documentation/Robofriend Mappe/3_Sensors/pic18f442 uC code 4xTimer.pdf

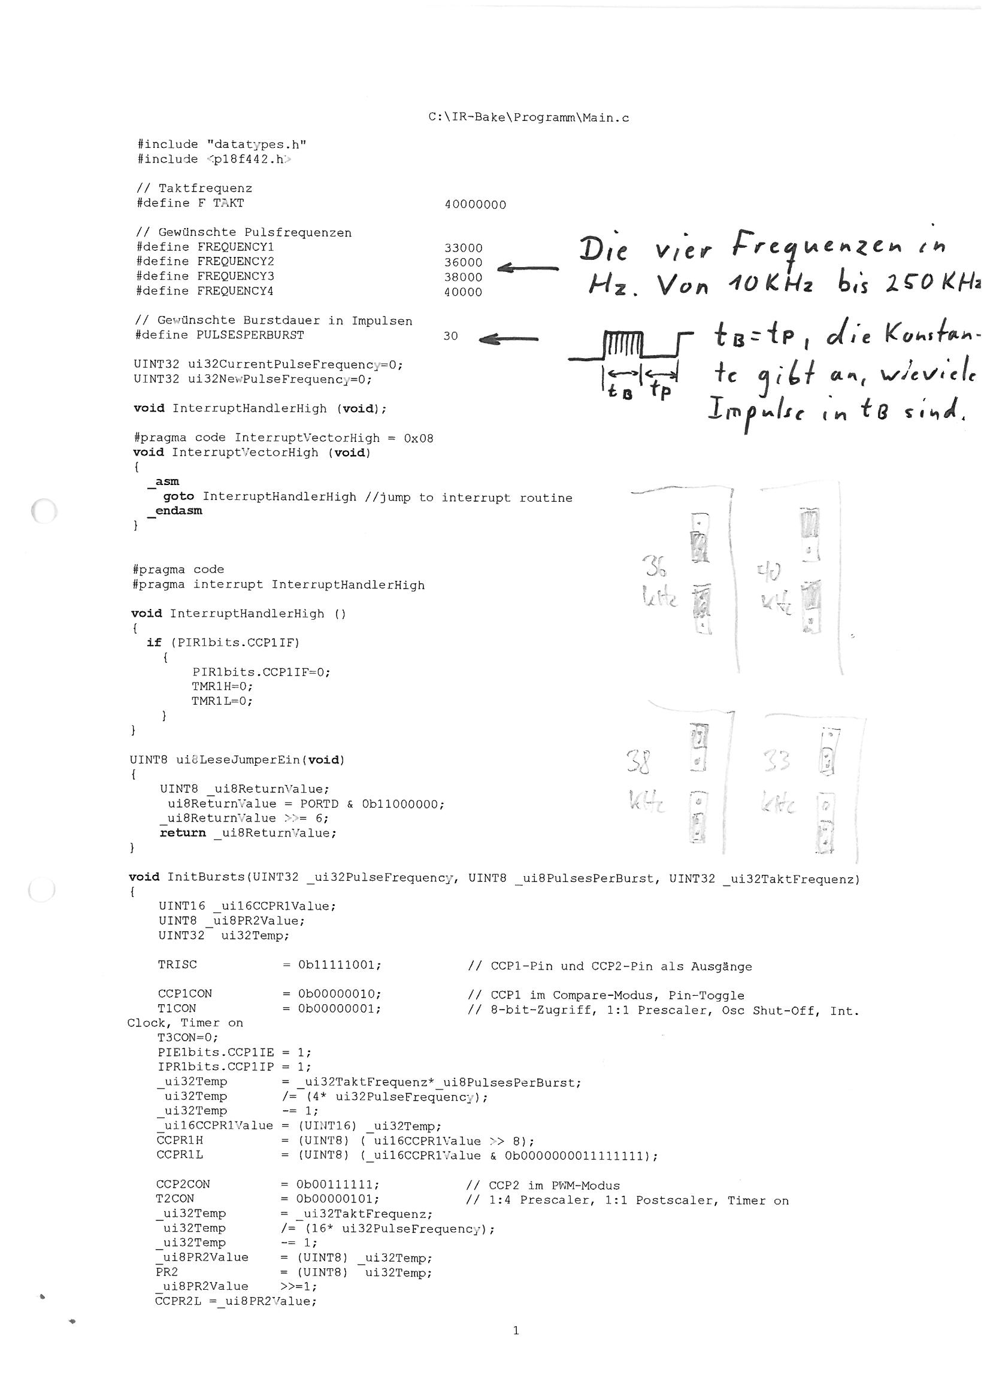
[picture p67: page 1]
