ProjectKitchen/RoboFriend/documentation/Robofriend Mappe/3_Sensors/pic18f4x2 sch.pdf

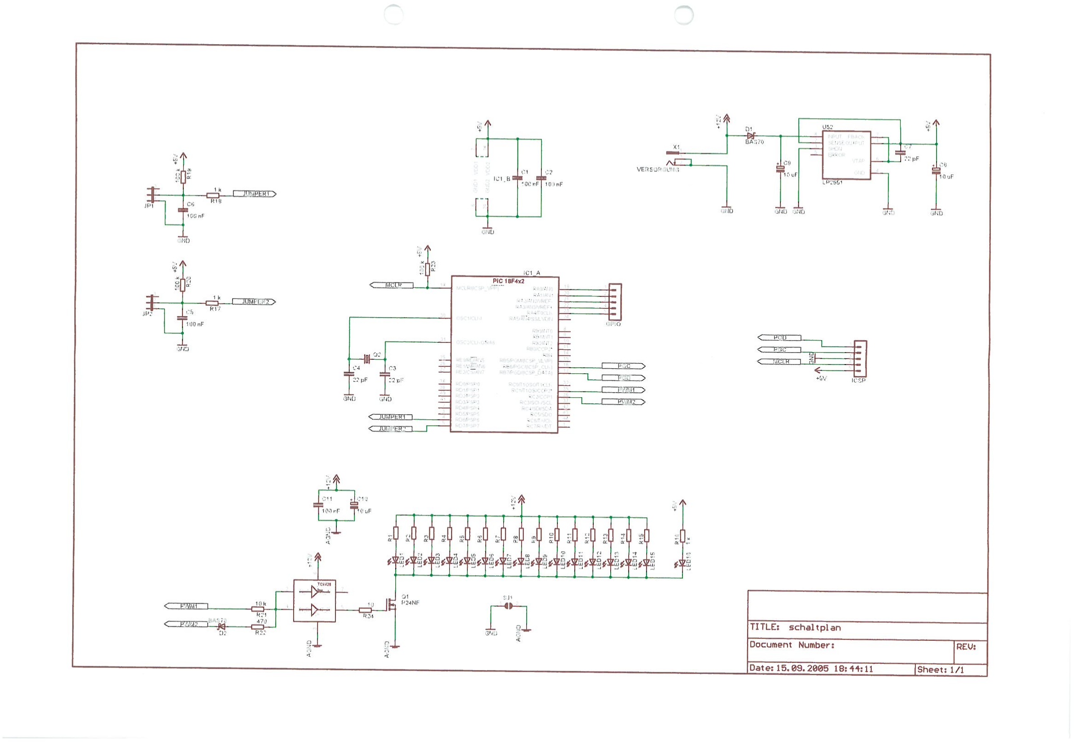
[picture p68: page 1]
