ProjectKitchen/RoboFriend/documentation/Robofriend Mappe/4_EPIA PC Komponenten/25 auf 35 zoll hd-adapter.pdf

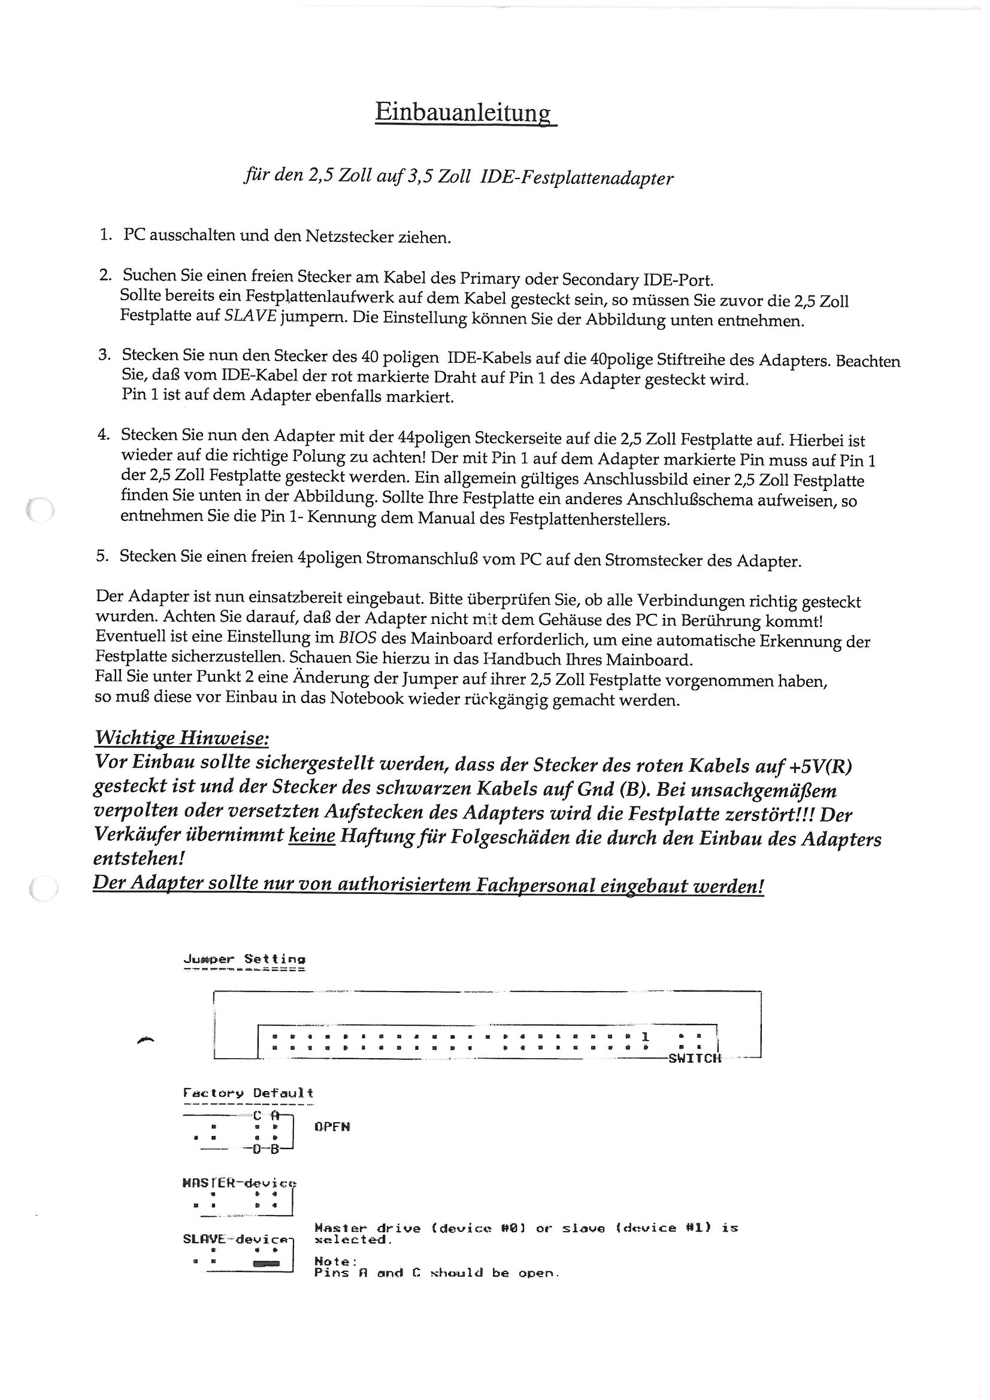
[picture p69: page 1]
