ProjectKitchen/RoboFriend/documentation/Robofriend Mappe/5_Power Supply/AD abhängigkeit.pdf

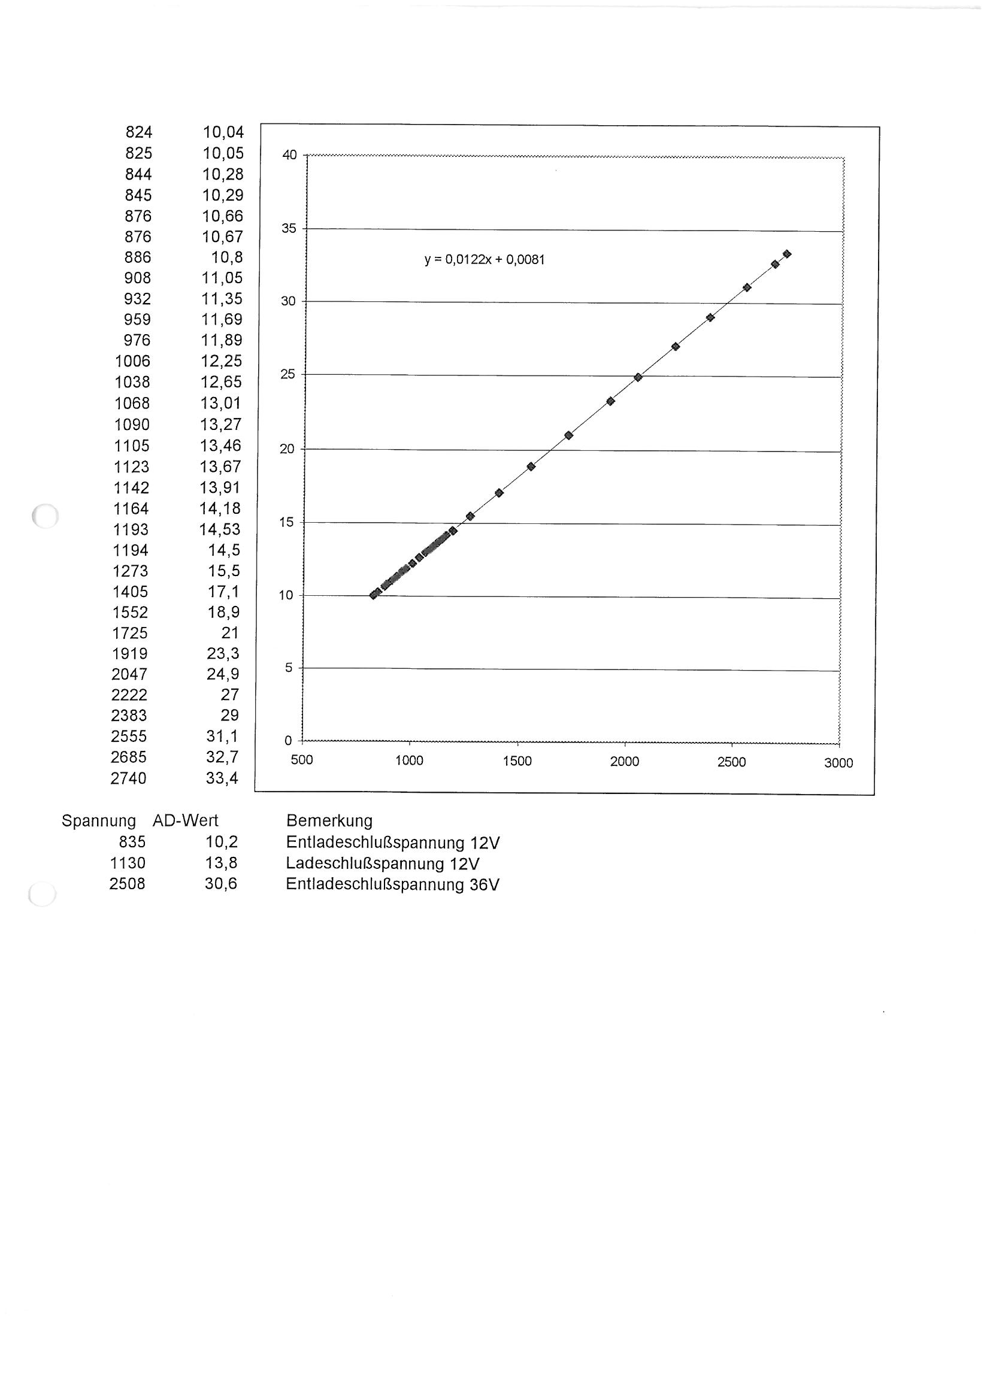
[picture p70: page 1]
