ProjectKitchen/RoboFriend/documentation/Robofriend Mappe/5_Power Supply/AD notes.pdf

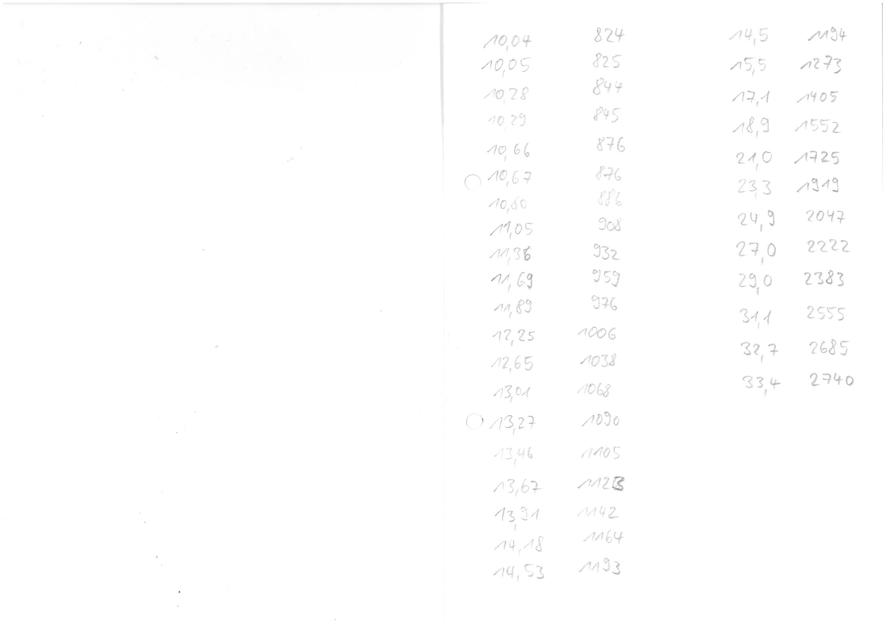
[picture p71: page 1]
