ProjectKitchen/RoboFriend/documentation/Robofriend Mappe/5_Power Supply/DC-DC converter ds.pdf

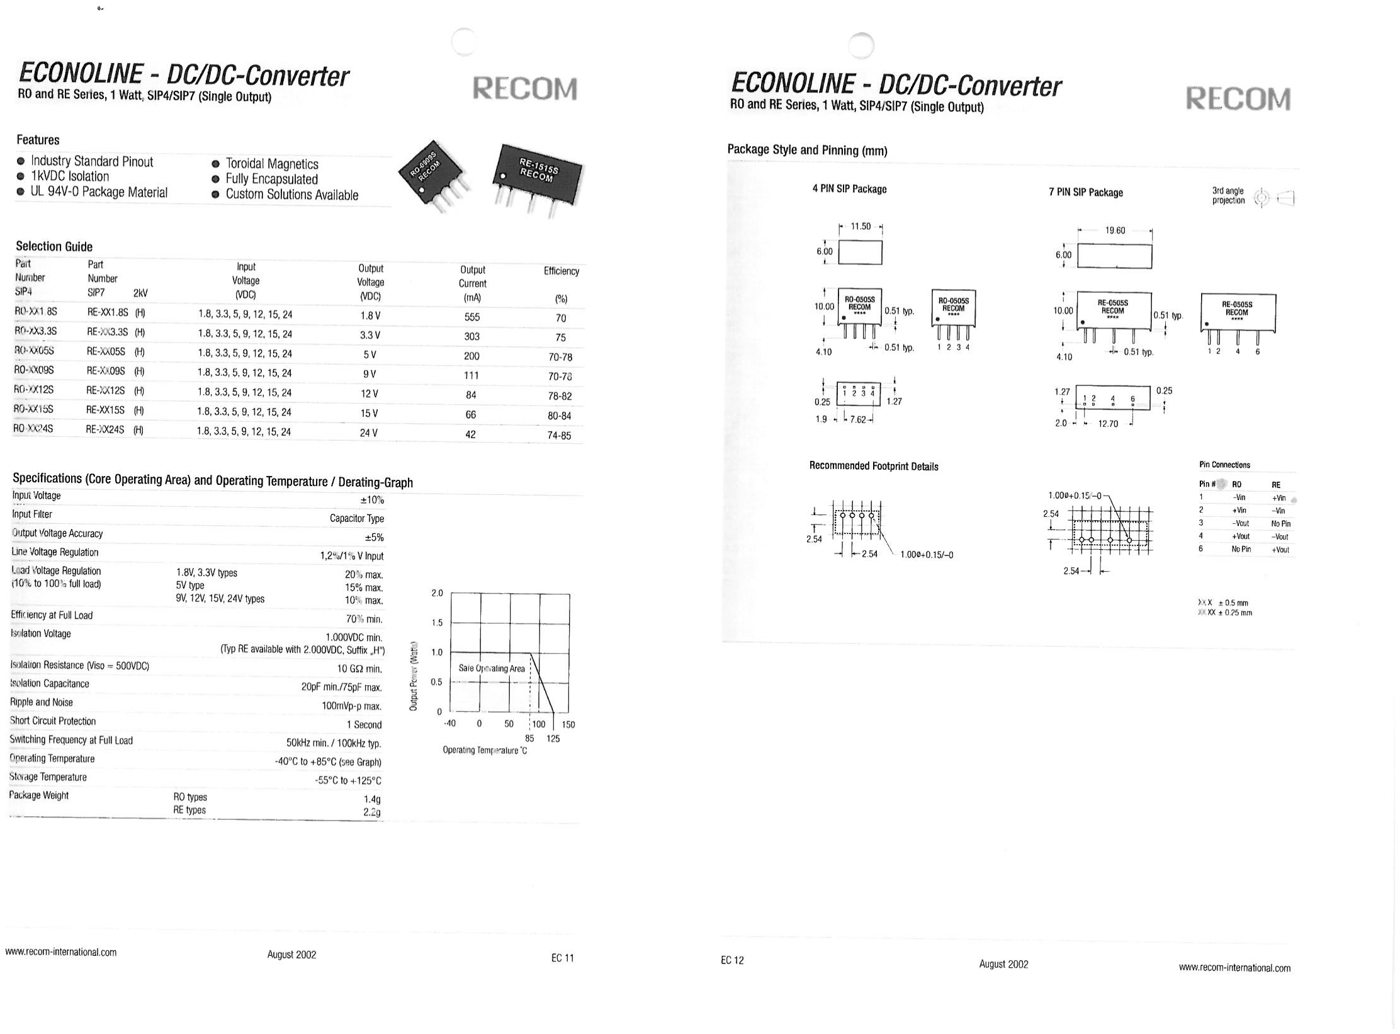
[picture p72: page 1]
