ProjectKitchen/RoboFriend/documentation/Robofriend Mappe/5_Power Supply/IRF540N mosFET ds.pdf

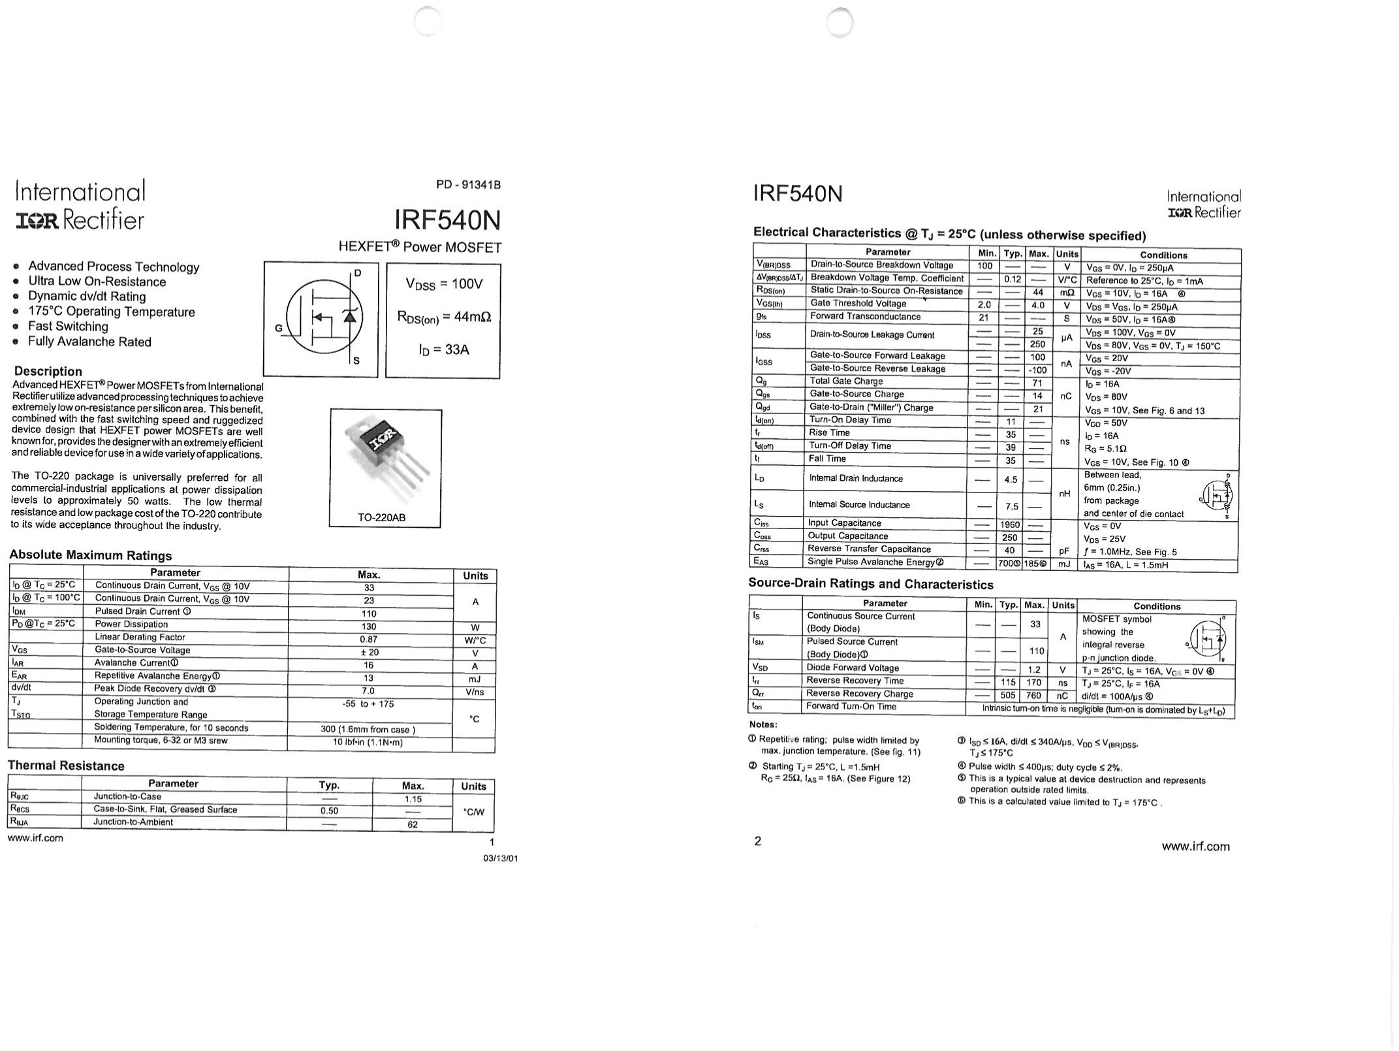
[picture p73: page 1]
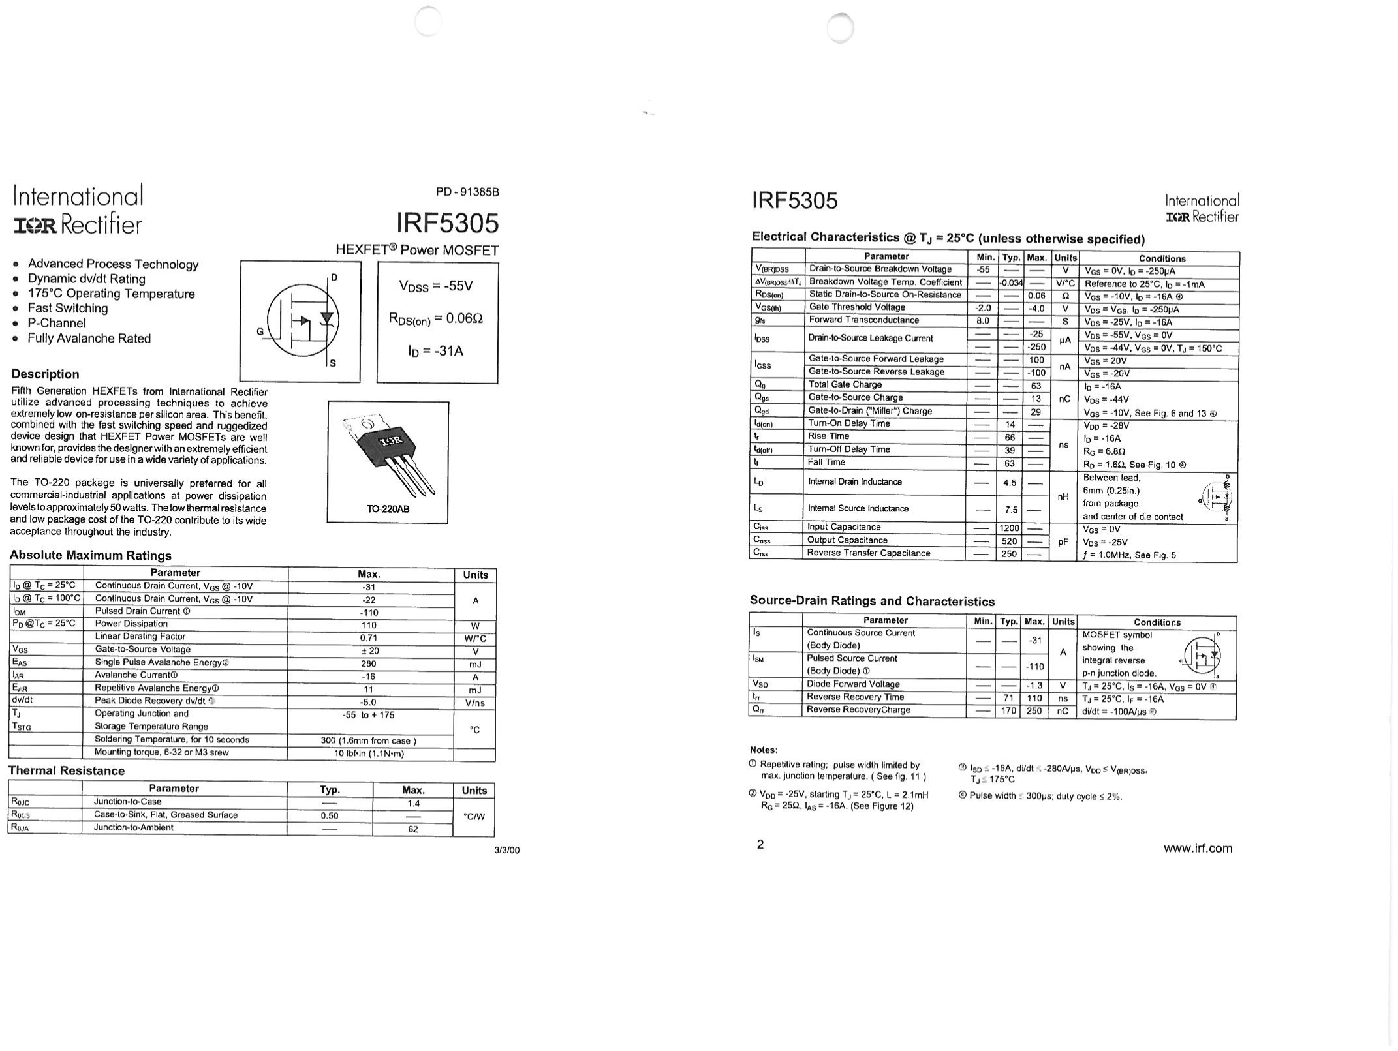
[picture p74: page 2]
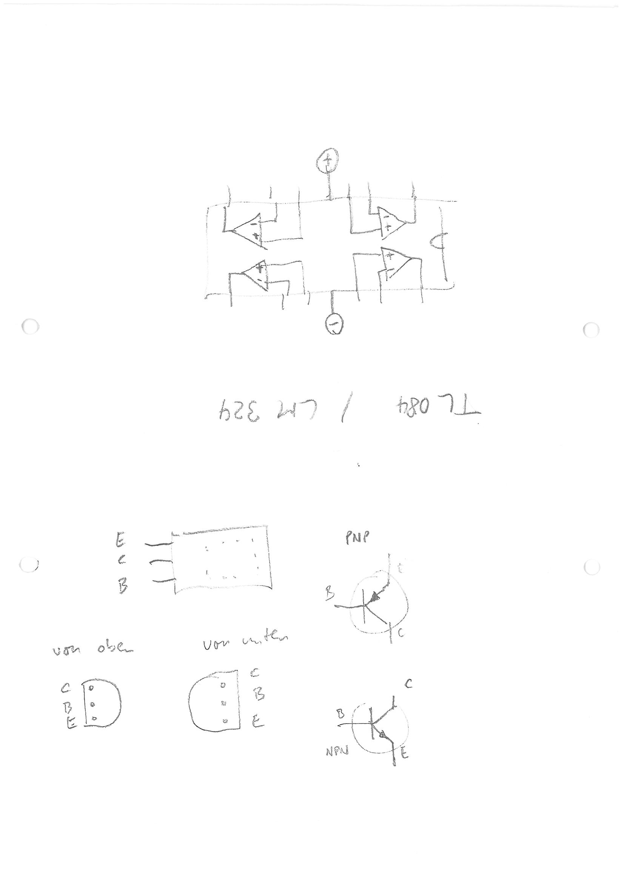
[picture p75: page 3]
