ProjectKitchen/RoboFriend/documentation/Robofriend Mappe/5_Power Supply/L4941 1A regler.pdf

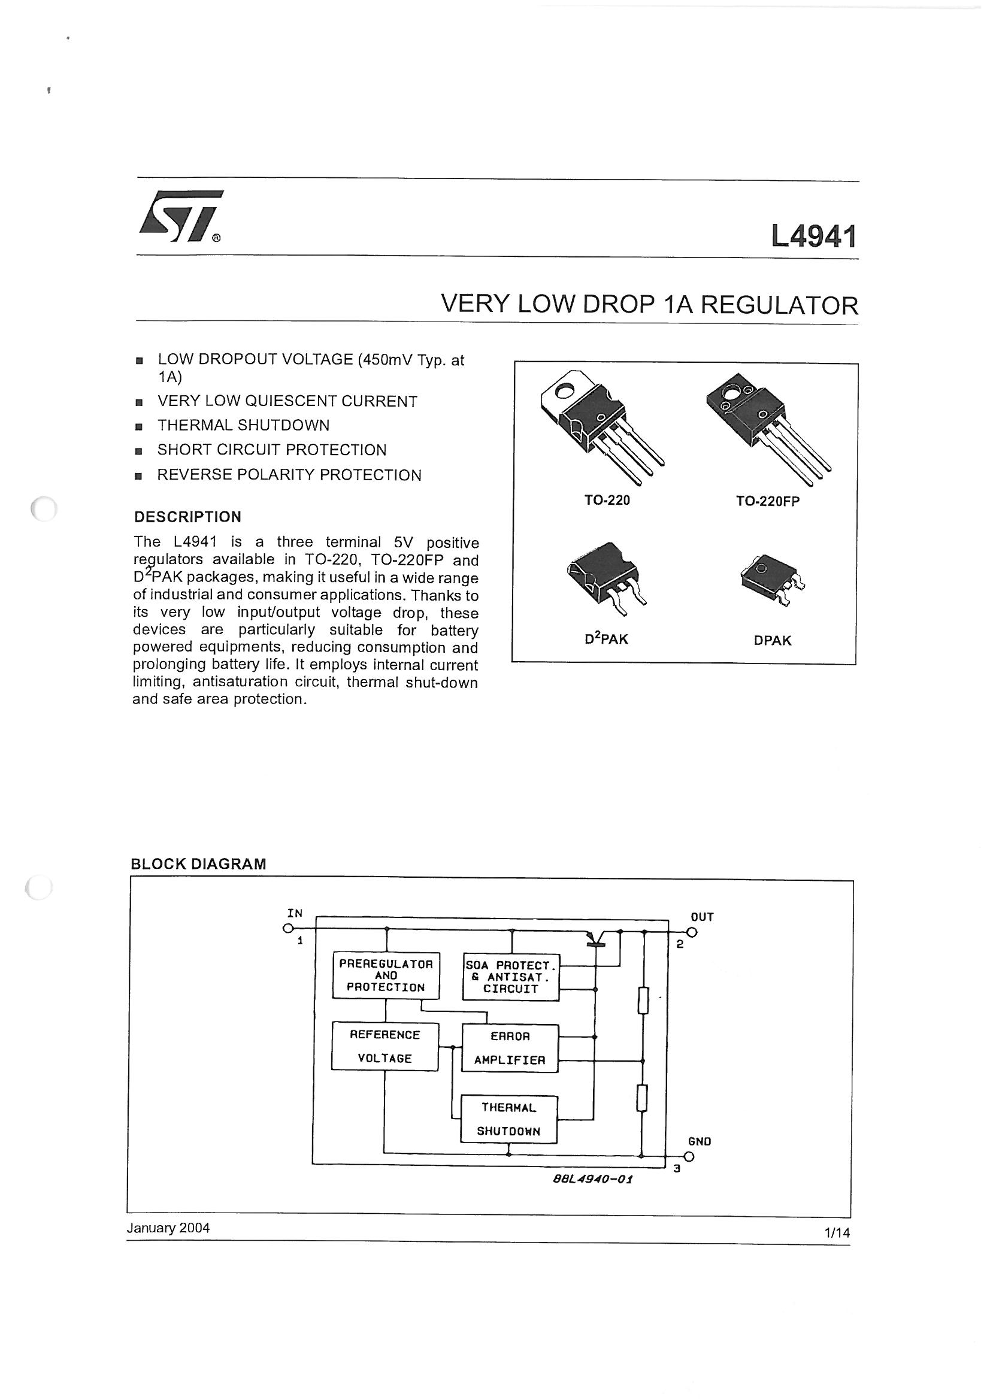
[picture p76: page 1]
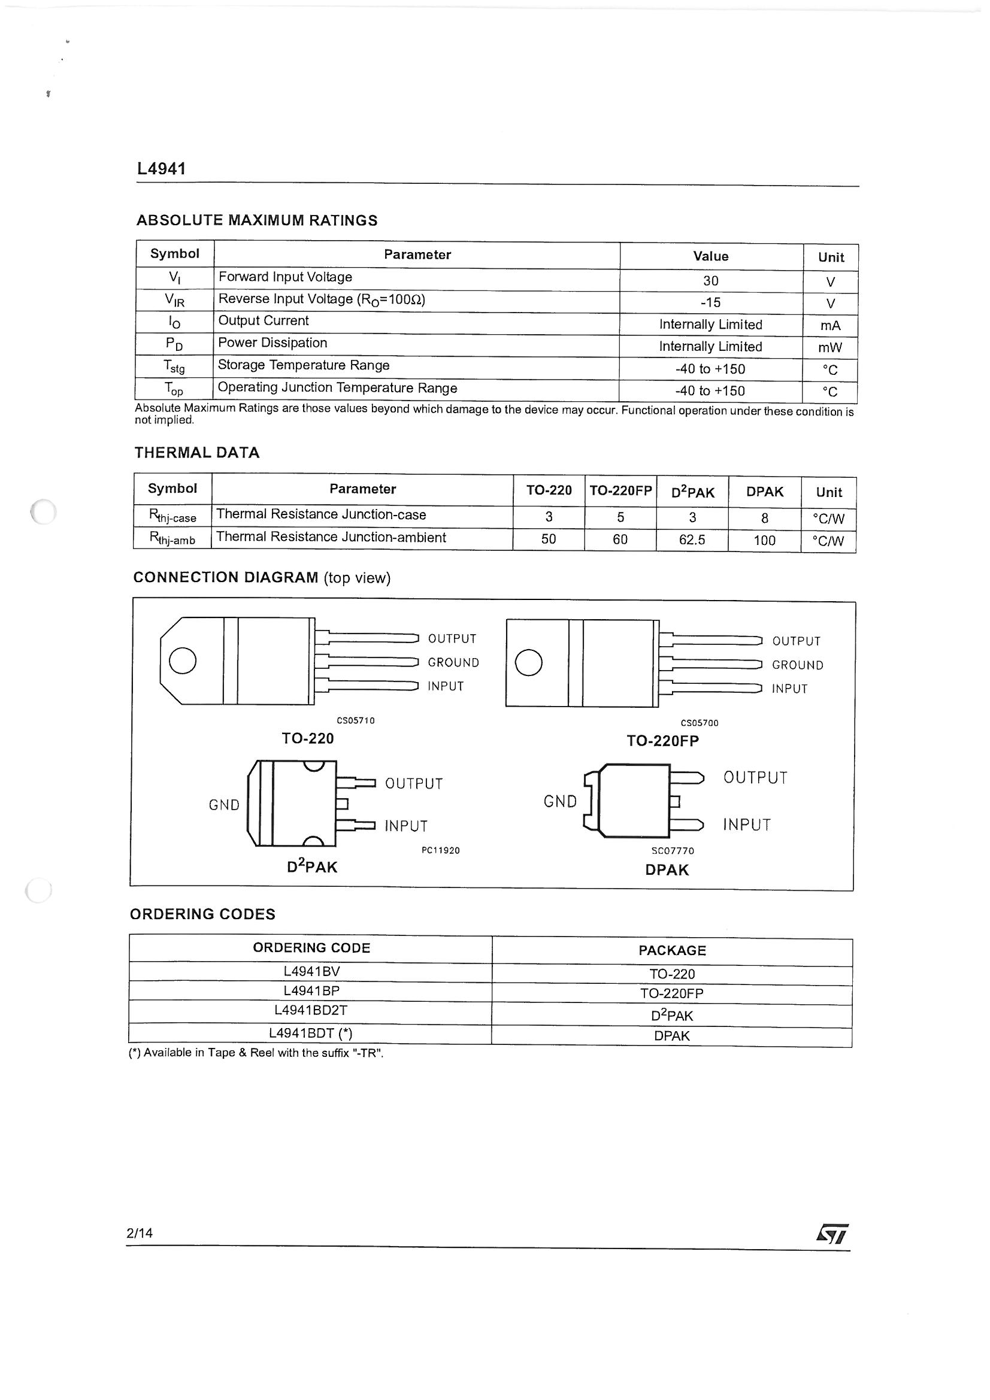
[picture p77: page 2]
