ProjectKitchen/RoboFriend/documentation/Robofriend Mappe/5_Power Supply/Lade_umschaltung sh.pdf

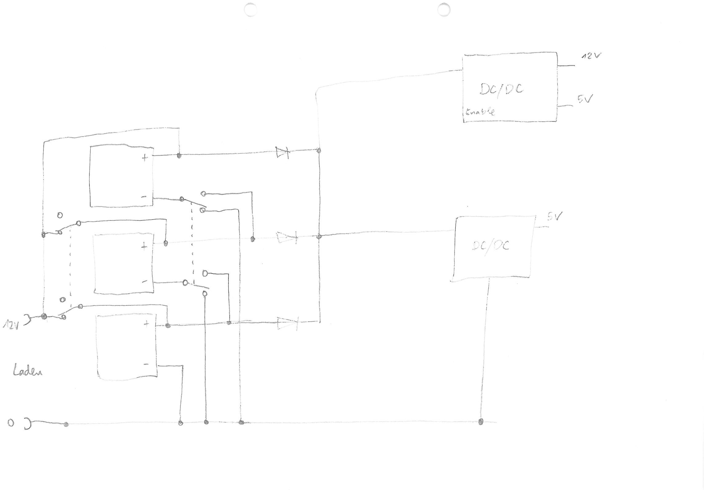
[picture p78: page 1]
