ProjectKitchen/RoboFriend/documentation/Robofriend Mappe/5_Power Supply/ladeelek ccontr sch.pdf

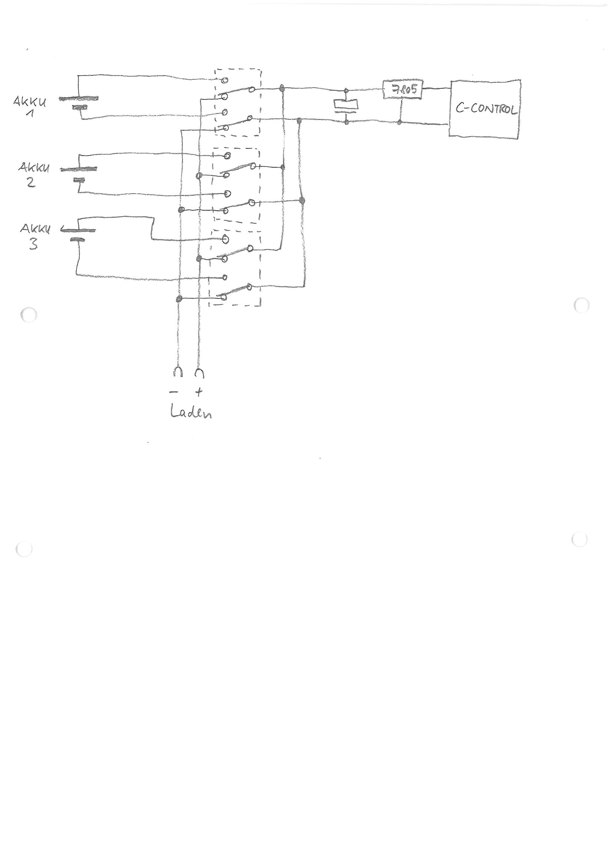
[picture p79: page 1]
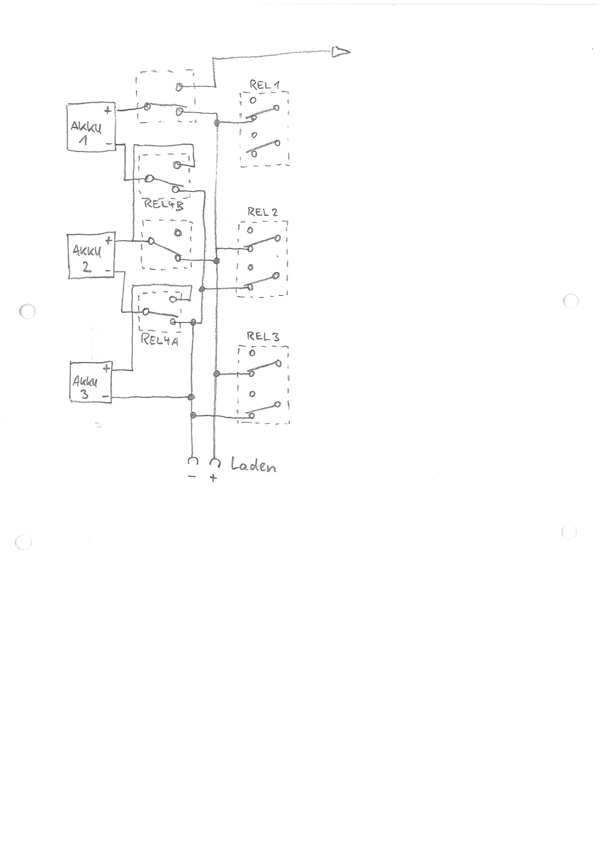
[picture p80: page 2]
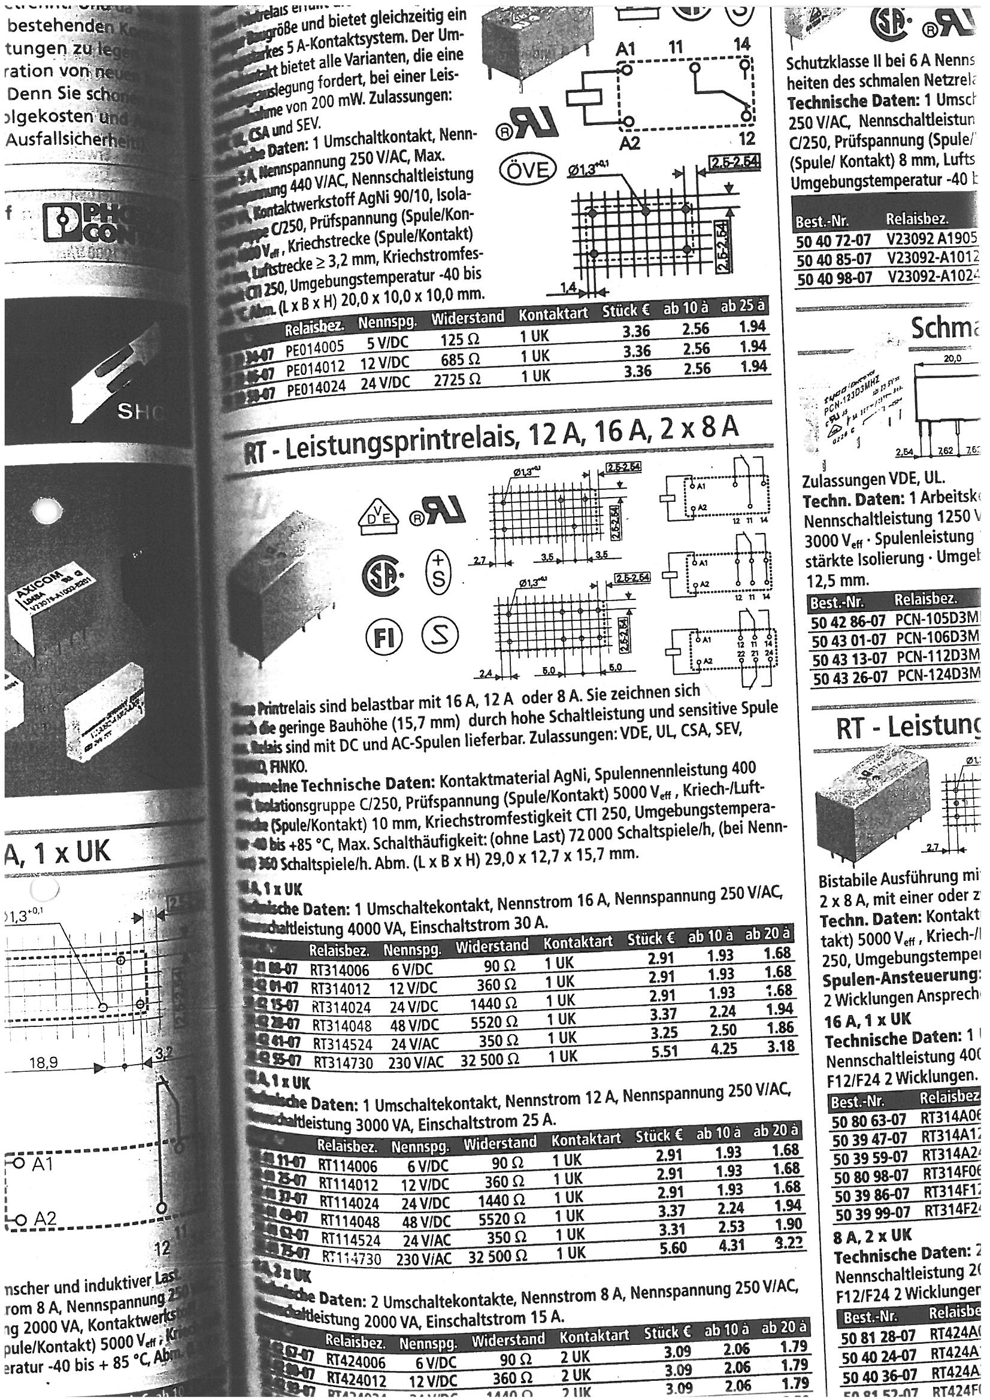
[picture p81: page 3]
