ProjectKitchen/RoboFriend/documentation/Robofriend Mappe/5_Power Supply/ladeelektronik sch.pdf

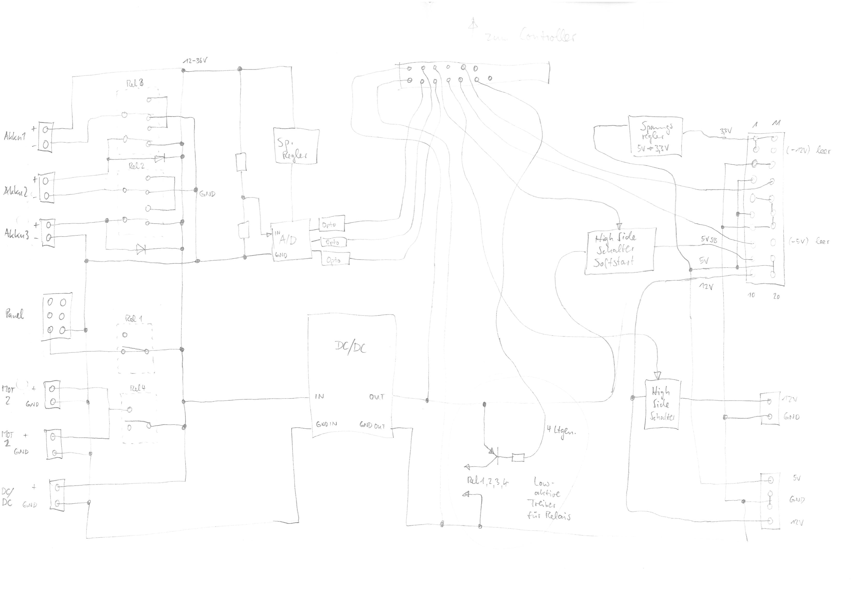
[picture p82: page 1]
