ProjectKitchen/RoboFriend/documentation/Robofriend Mappe/5_Power Supply/LD1085 3A regler.pdf

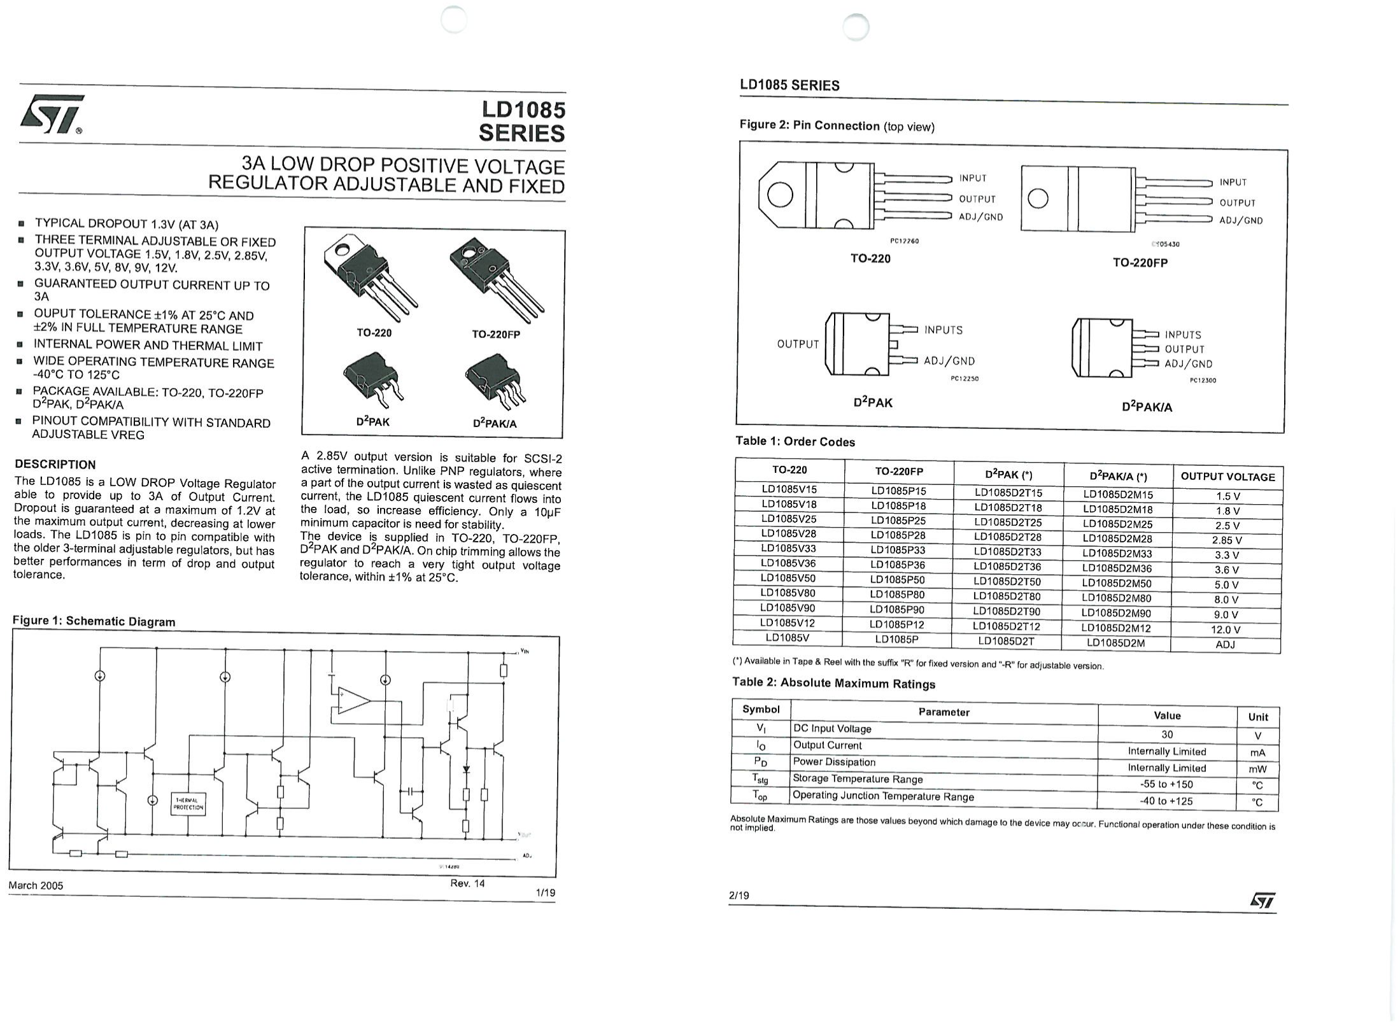
[picture p83: page 1]
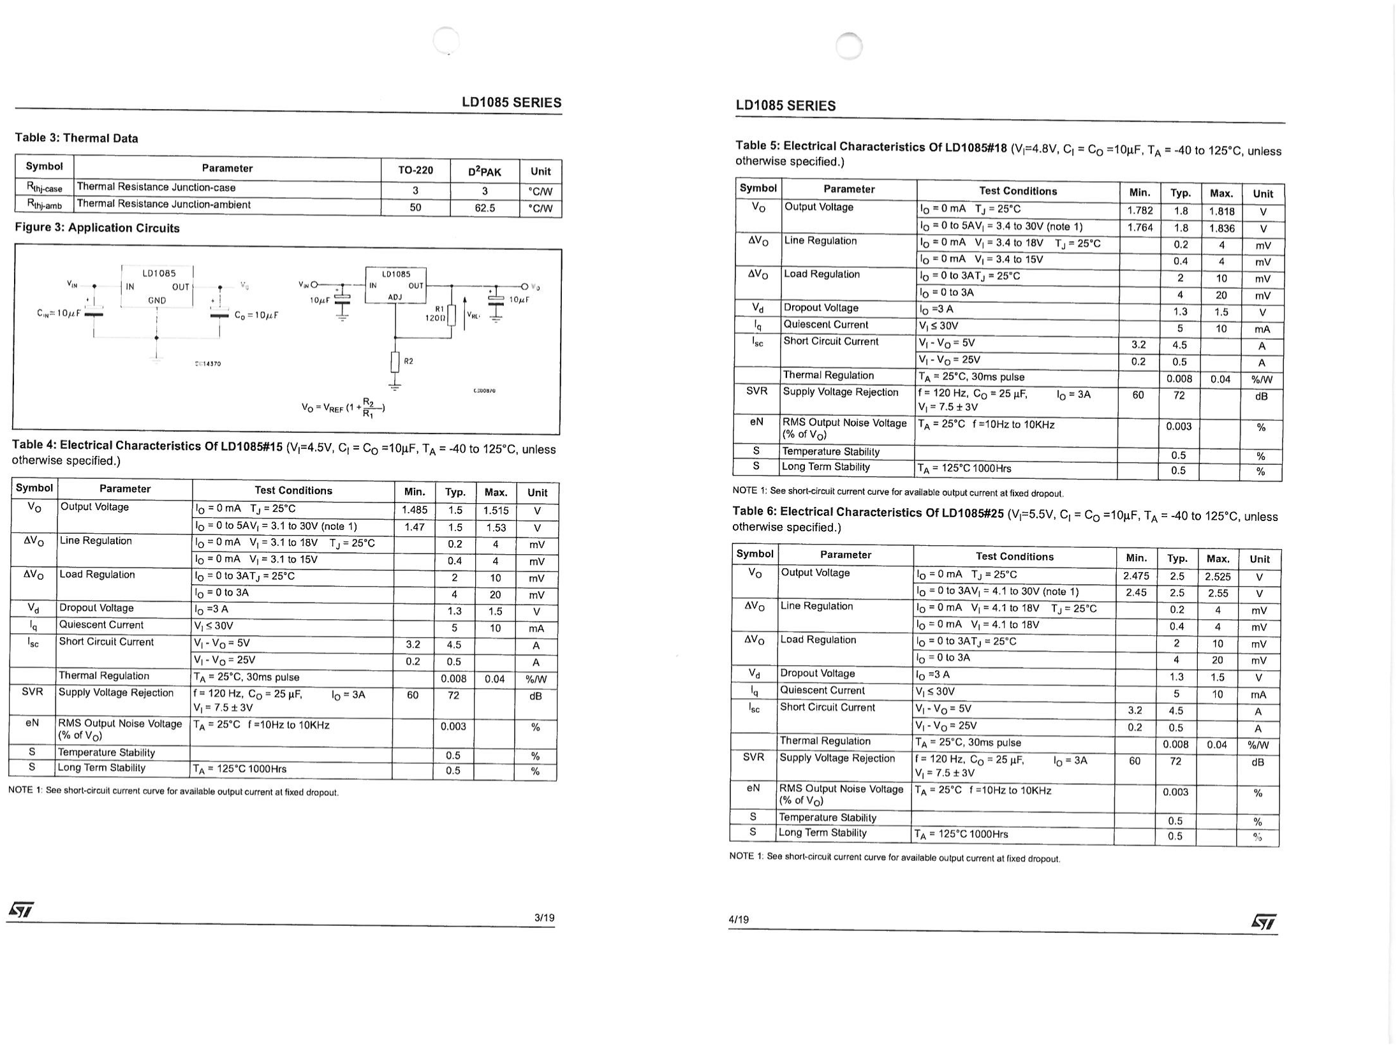
[picture p84: page 2]
