ProjectKitchen/RoboFriend/documentation/Robofriend Mappe/5_Power Supply/LM78LXX 5V regler.pdf

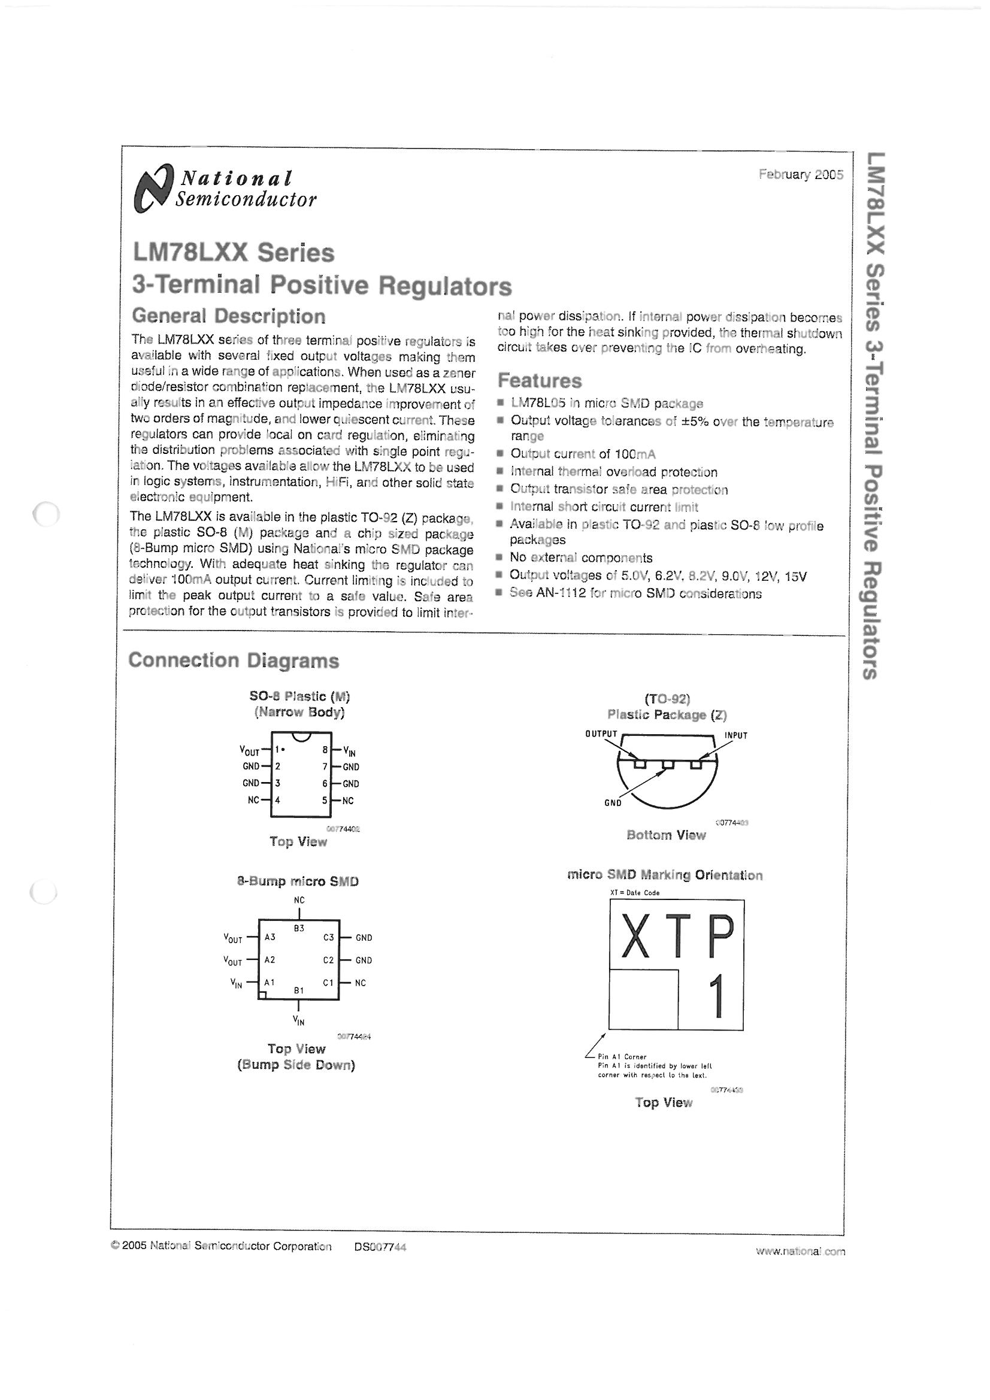
[picture p85: page 1]
