ProjectKitchen/RoboFriend/documentation/Robofriend Mappe/5_Power Supply/LT1584 3,3V linear regler ds.pdf

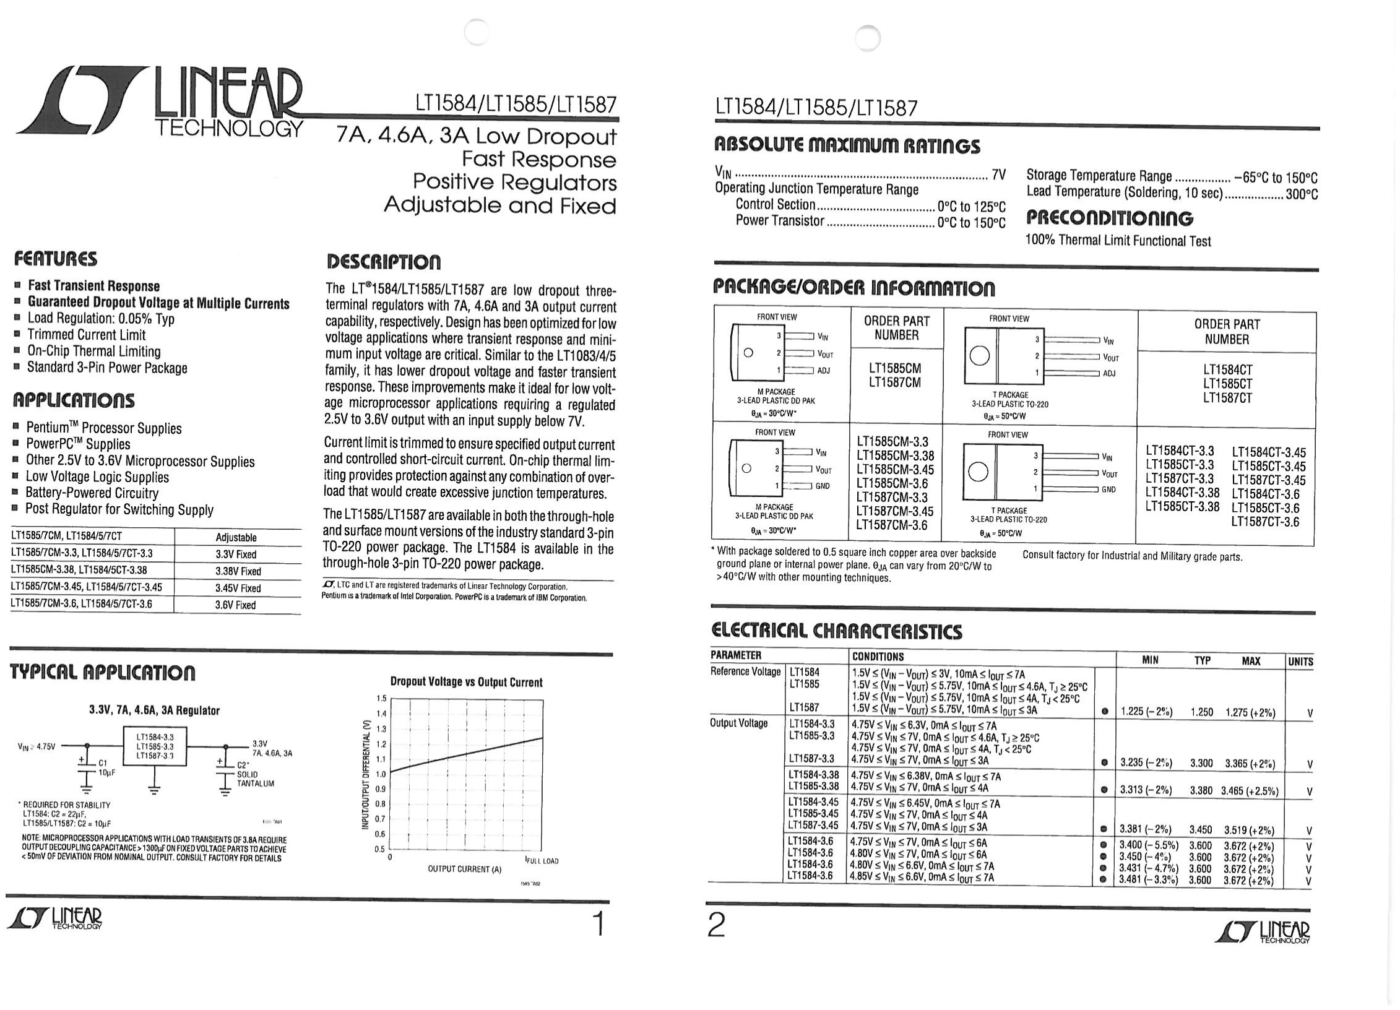
[picture p86: page 1]
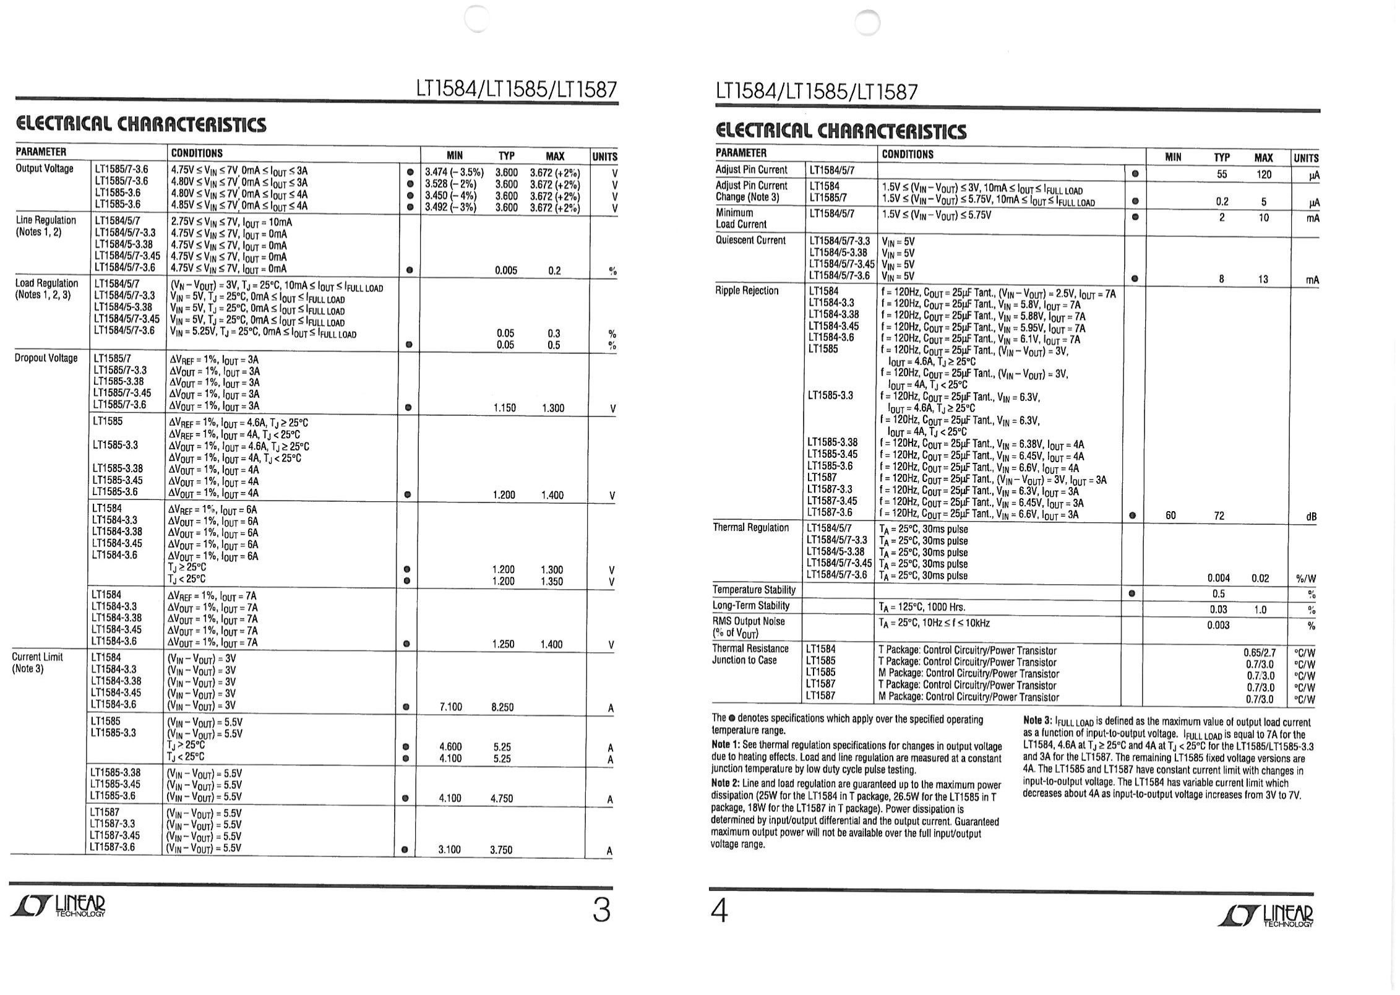
[picture p87: page 2]
