ProjectKitchen/RoboFriend/documentation/Robofriend Mappe/5_Power Supply/power supply sch.pdf

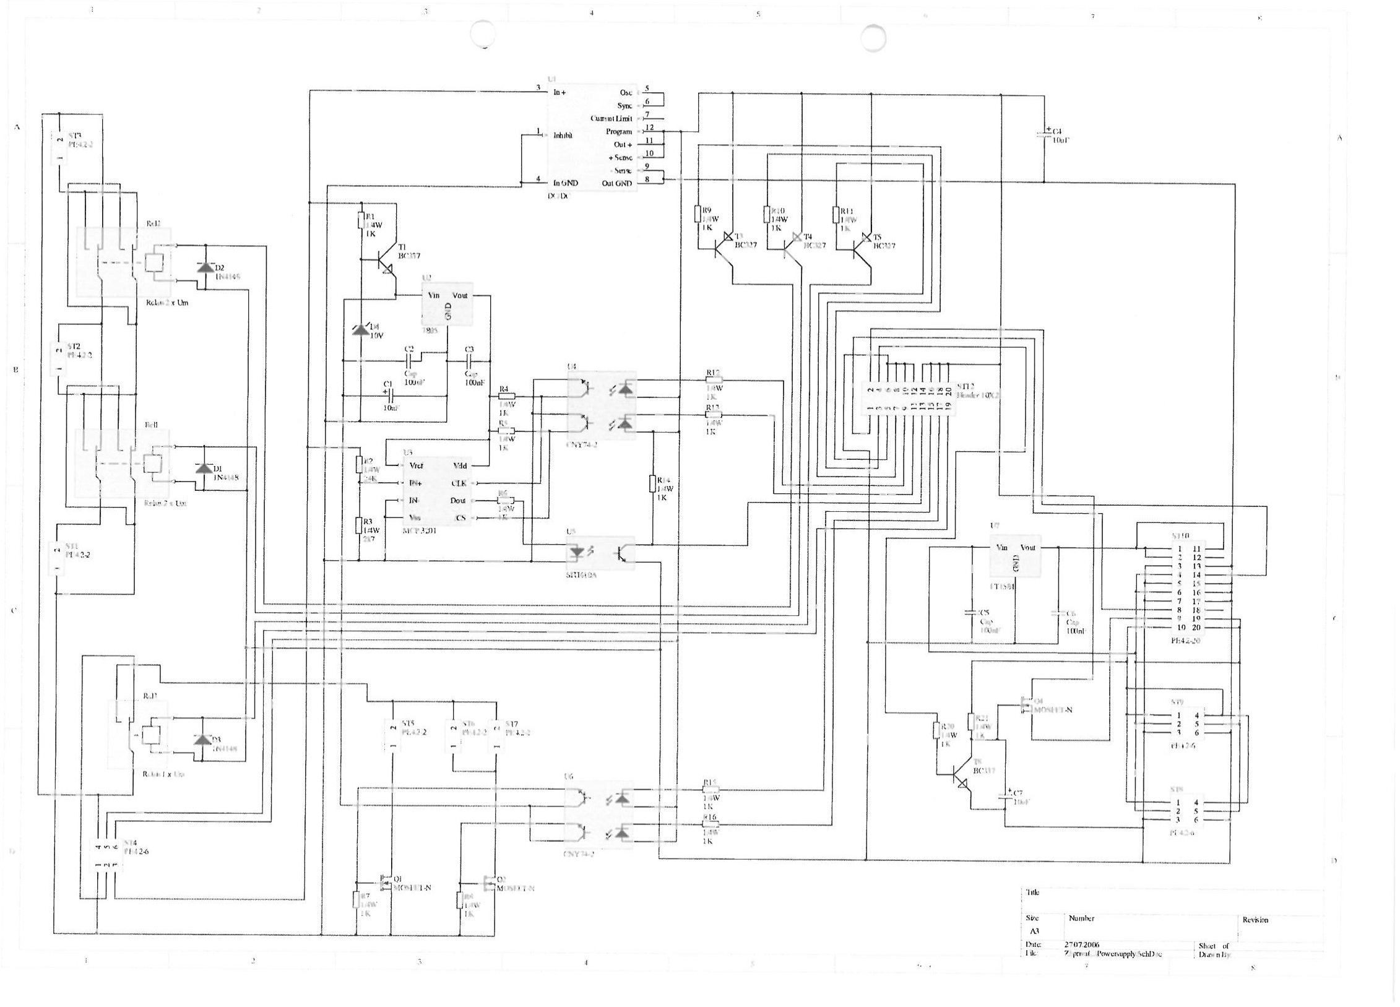
[picture p88: page 1]
