ProjectKitchen/RoboFriend/documentation/Robofriend Mappe/5_Power Supply/RS232 TxRx sch.pdf

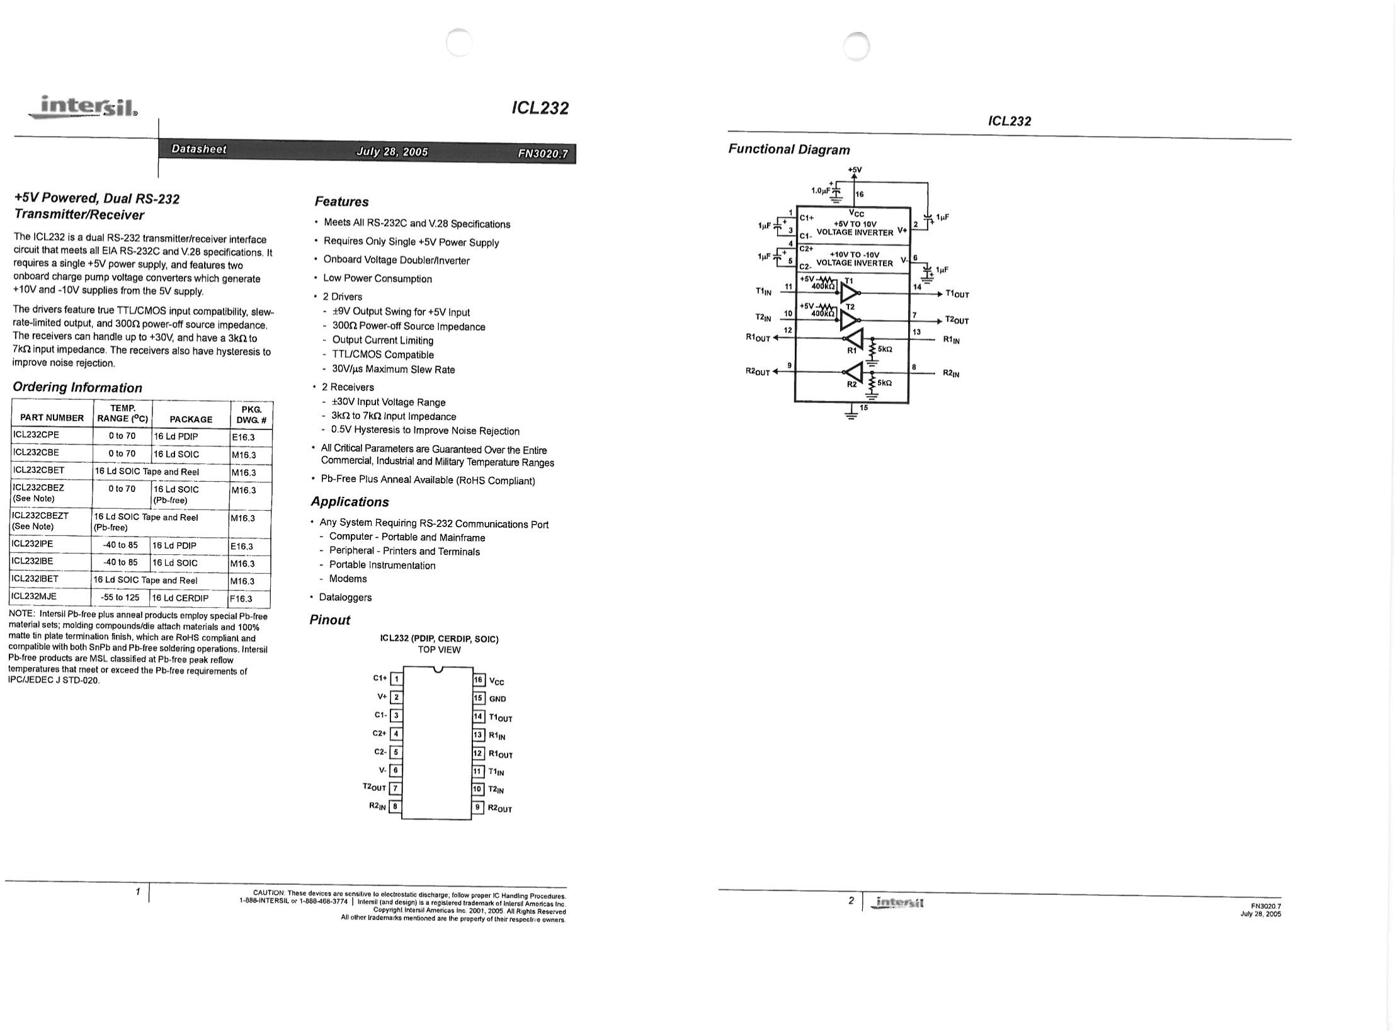
[picture p89: page 1]
