ProjectKitchen/RoboFriend/documentation/Robofriend Mappe/5_Power Supply/SMD resistor ds.pdf

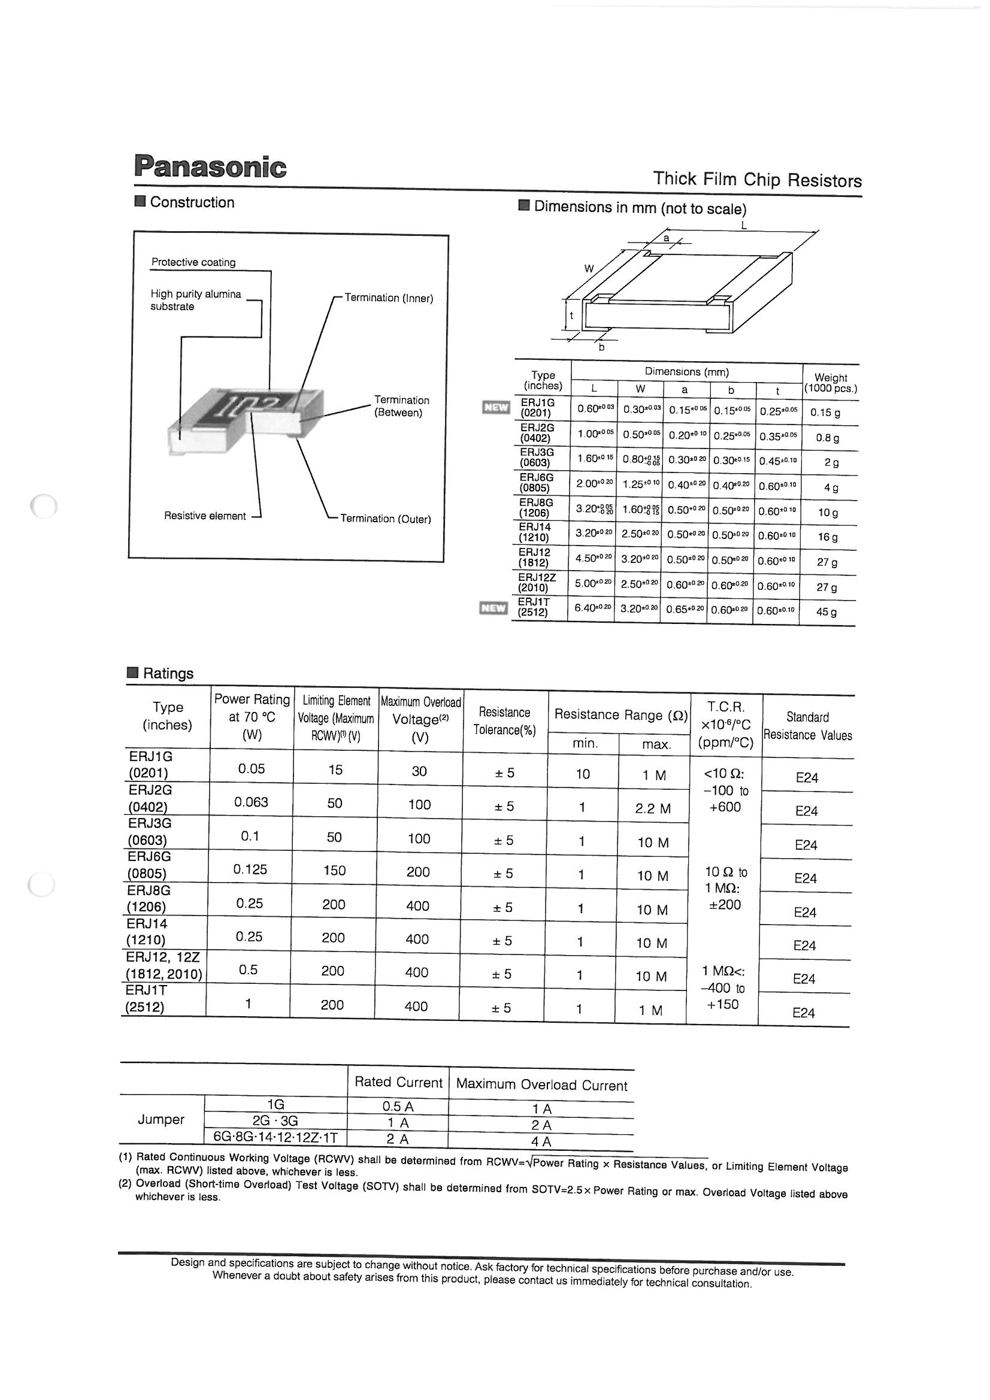
[picture p90: page 1]
