ProjectKitchen/RoboFriend/documentation/Robofriend Mappe/6_Motor Controller/CNY74-2H multich optocoupl ds.pdf

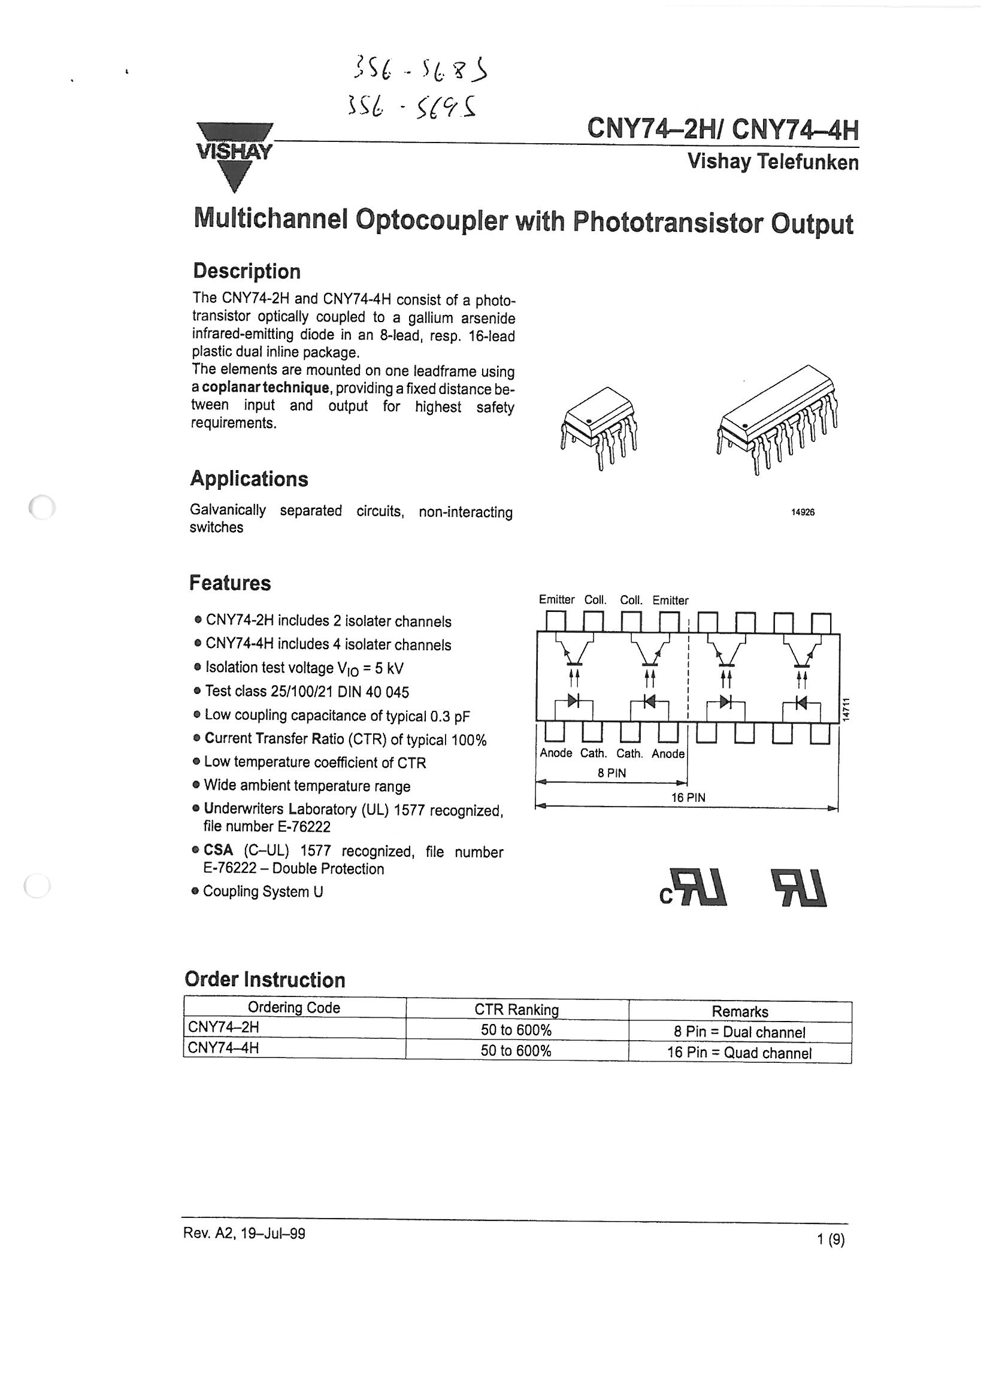
[picture p91: page 1]
