ProjectKitchen/RoboFriend/documentation/Robofriend Mappe/6_Motor Controller/H-bridge sch2.pdf

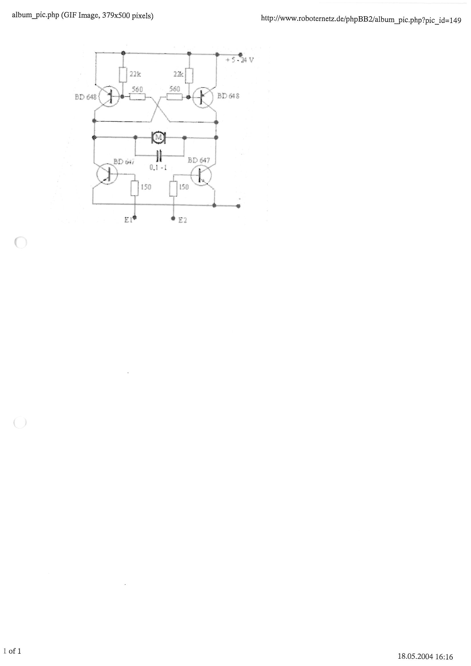
[picture p92: page 1]
