ProjectKitchen/RoboFriend/documentation/Robofriend Mappe/6_Motor Controller/motortreiber sch.pdf

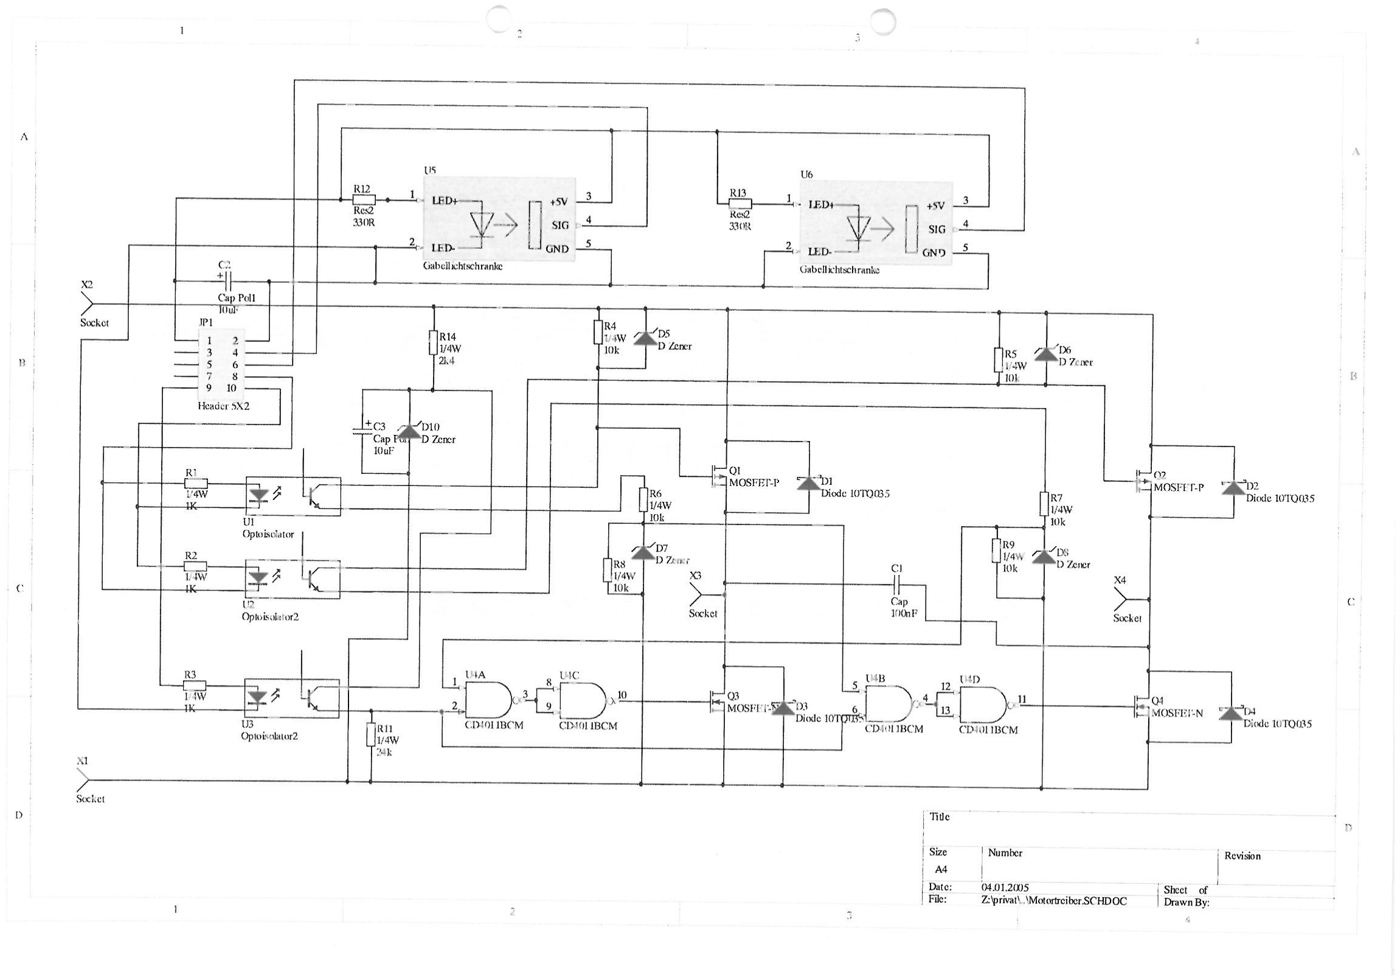
[picture p93: page 1]
