ProjectKitchen/RoboFriend/documentation/Robofriend Mappe/6_Motor Controller/motortreiber2 sch.pdf

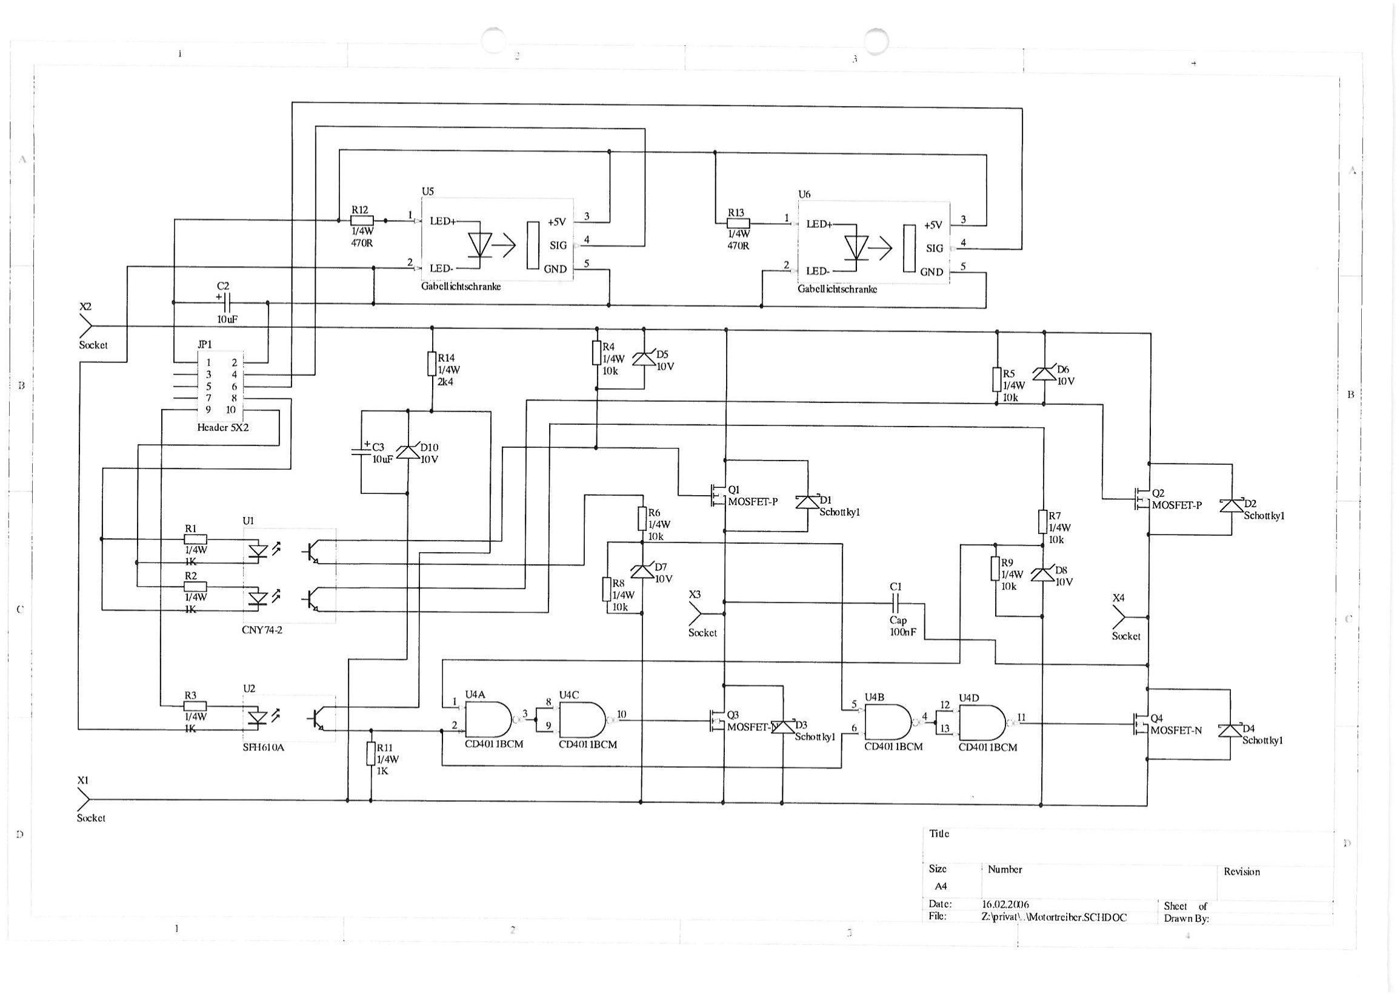
[picture p94: page 1]
