ProjectKitchen/RoboFriend/documentation/Robofriend Mappe/6_Motor Controller/RFP12N skizze.pdf

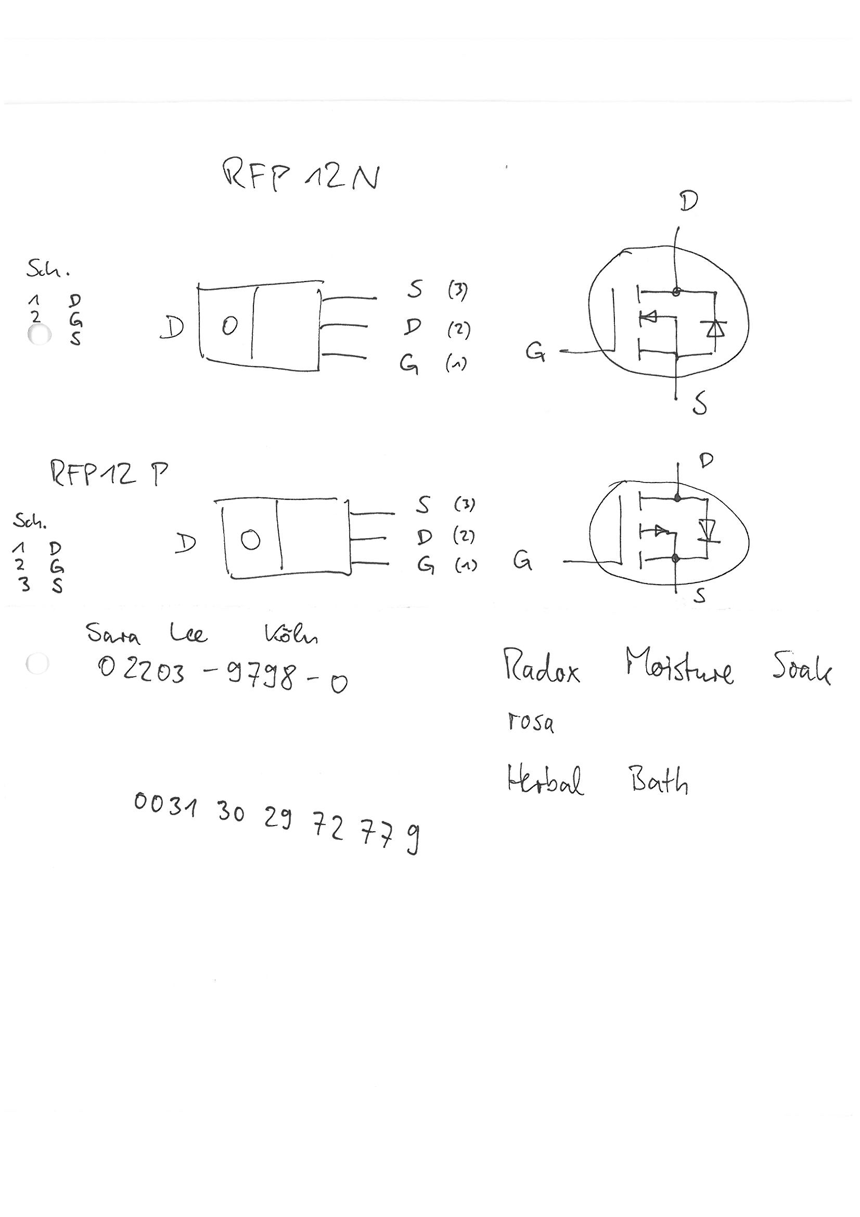
[picture p95: page 1]
