ProjectKitchen/RoboFriend/documentation/Robofriend Mappe/6_Motor Controller/RFP12P08 MosFET ds.pdf

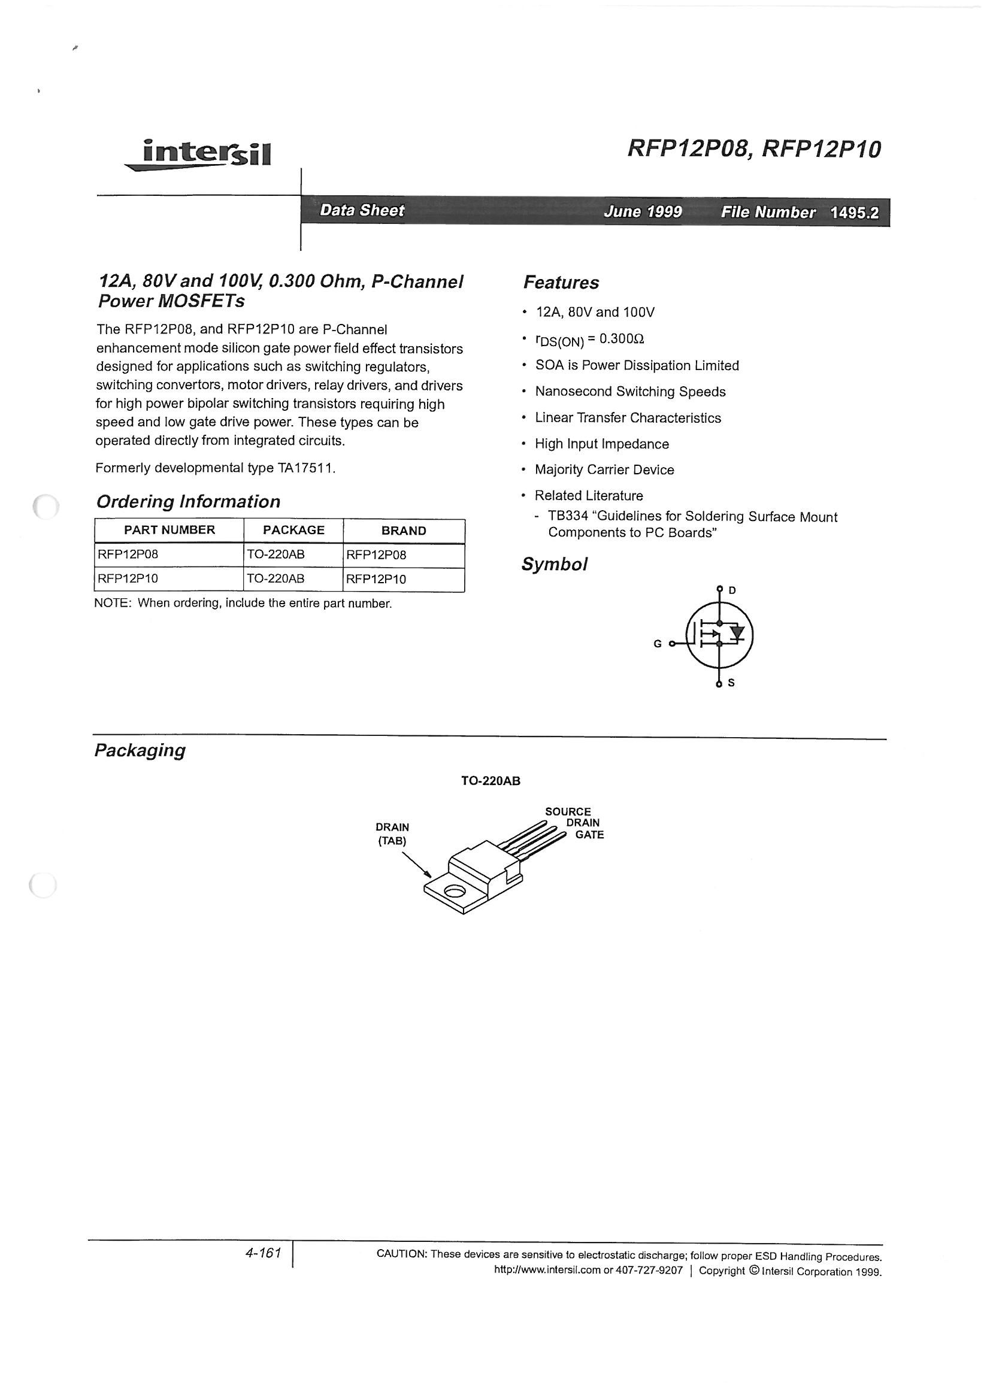
[picture p96: page 1]
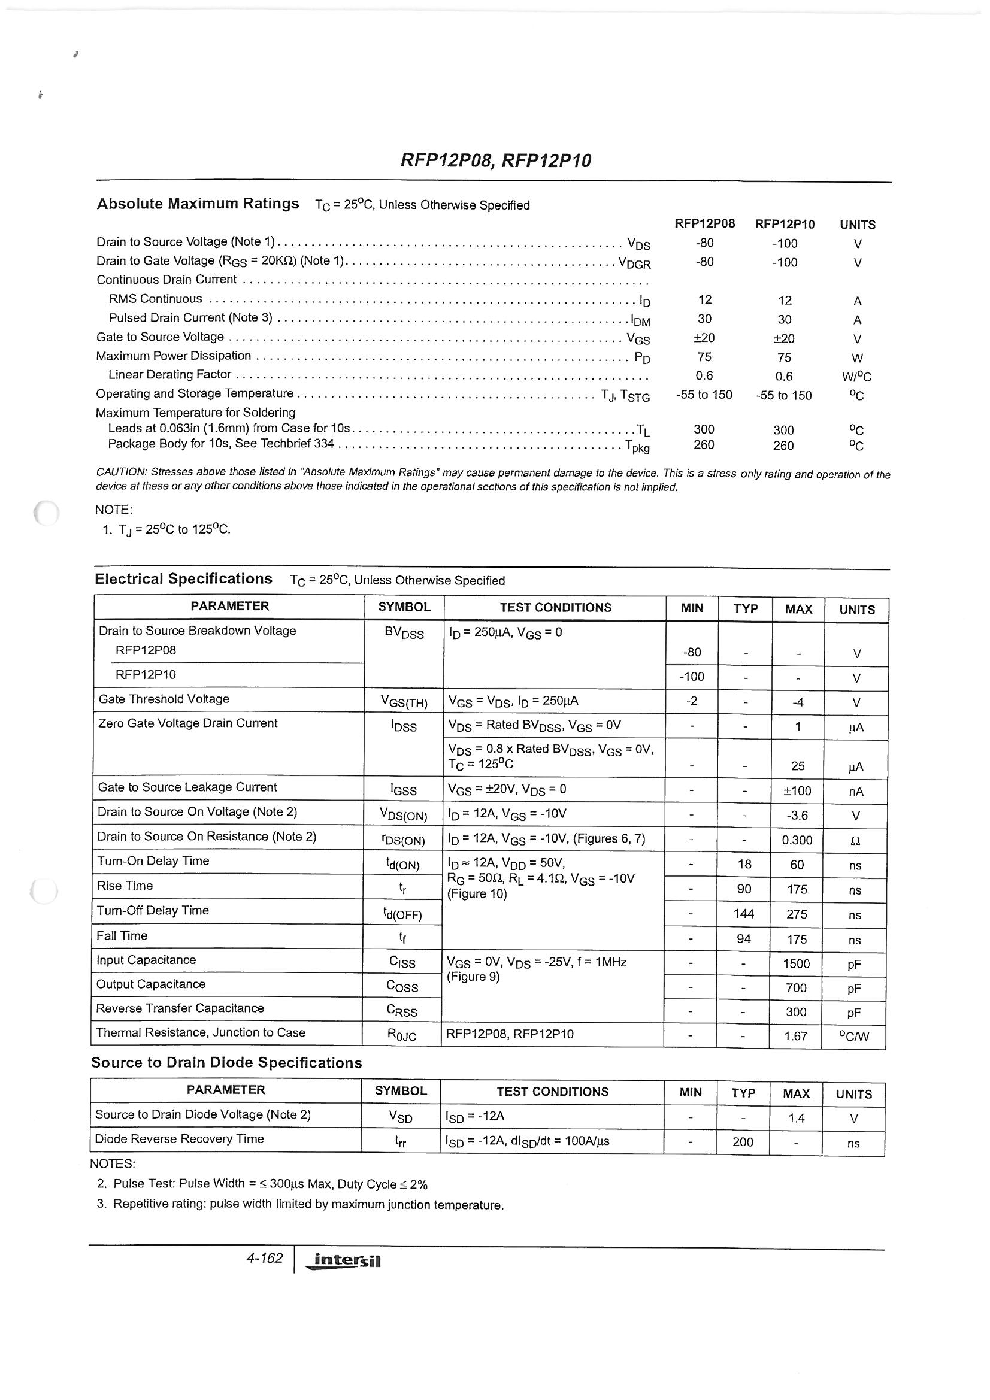
[picture p97: page 2]
