ProjectKitchen/RoboFriend/documentation/Robofriend Mappe/6_Motor Controller/SFH601 optocoupl ds.pdf

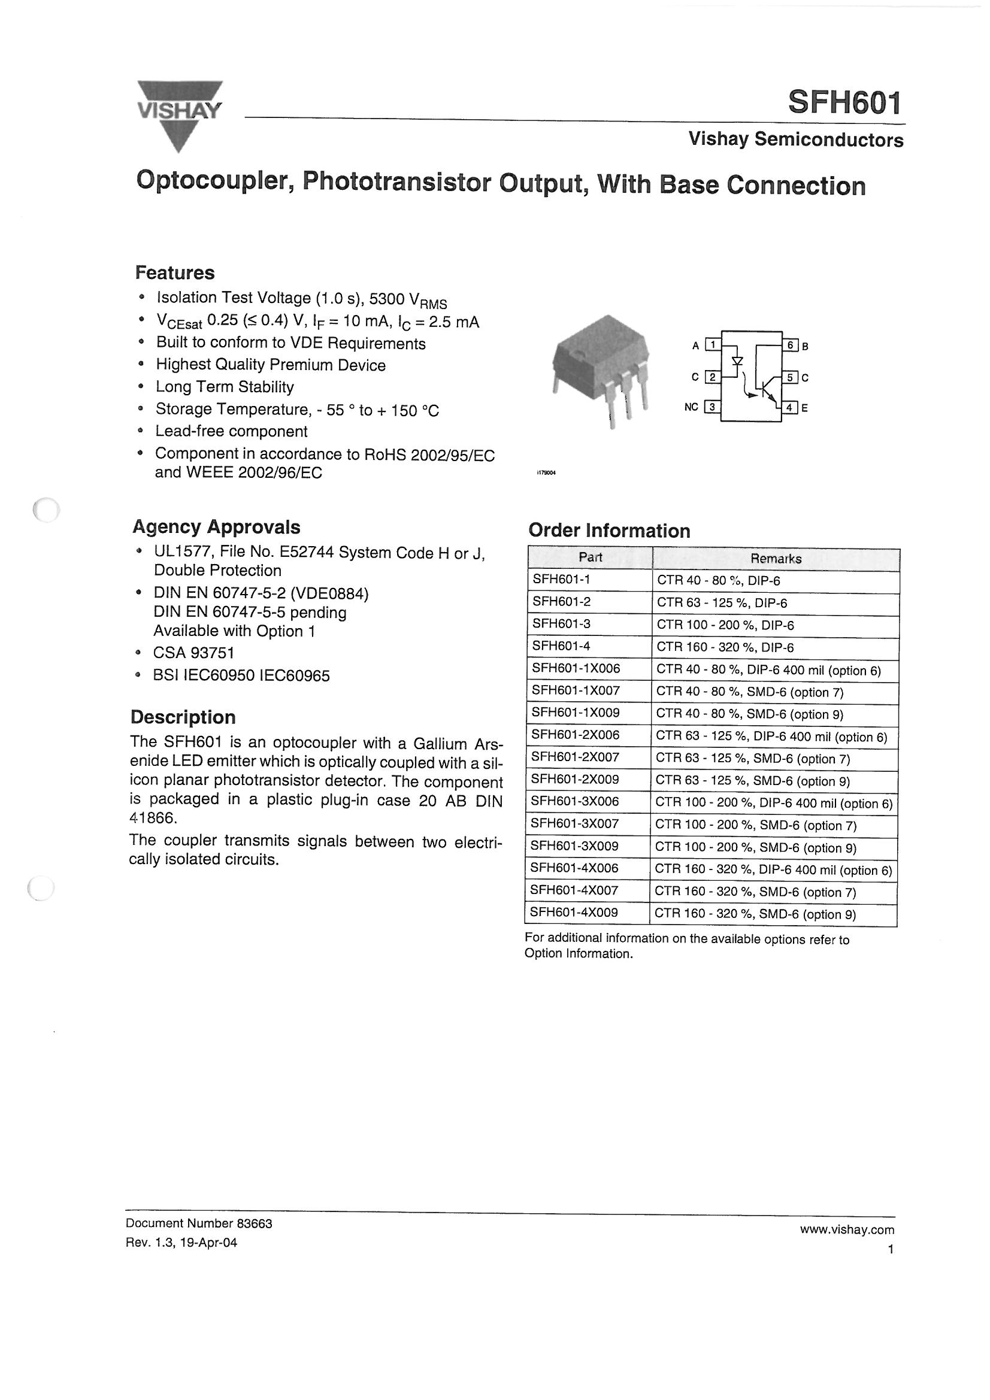
[picture p98: page 1]
