ProjectKitchen/RoboFriend/documentation/Robofriend Mappe/6_Motor Controller/SFH610A optocoupl ds.pdf

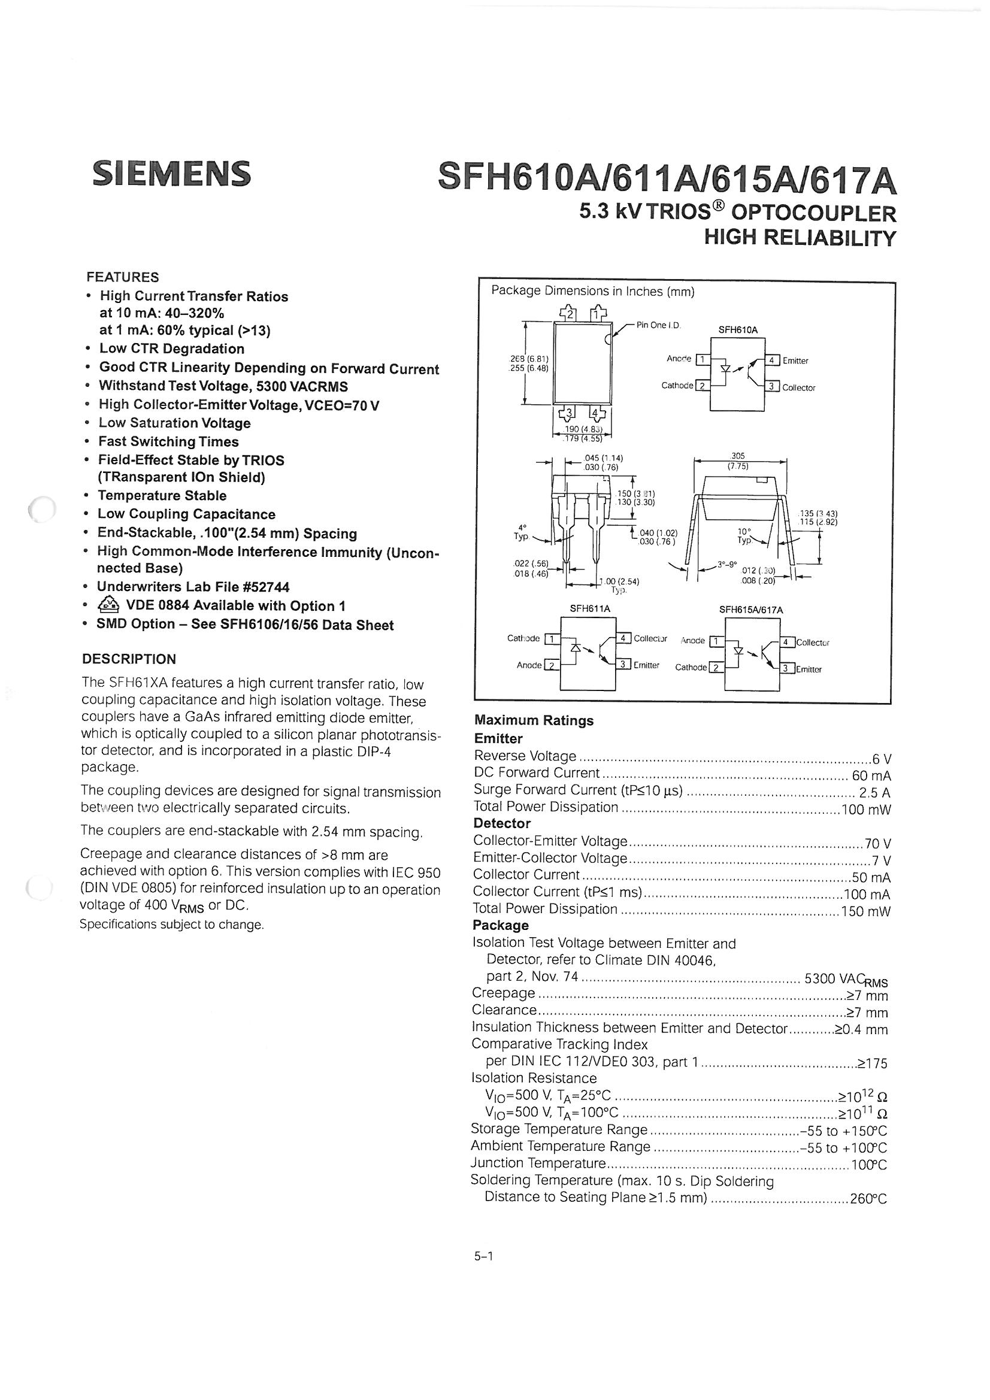
[picture p99: page 1]
