ProjectKitchen/RoboFriend/src/TabletGUI/data/angryM.PNG

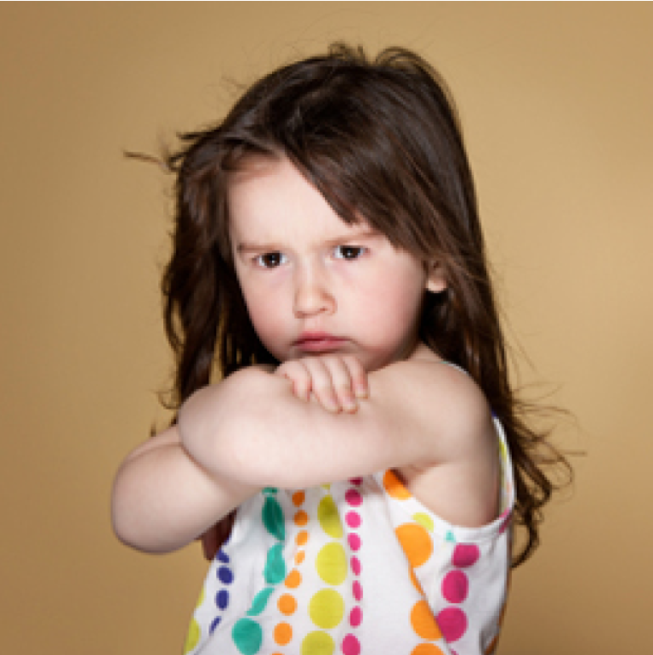
src/TabletGUI/data/angryM.PNG
