ProjectKitchen/RoboFriend/src/TabletGUI/data/eye_down.png

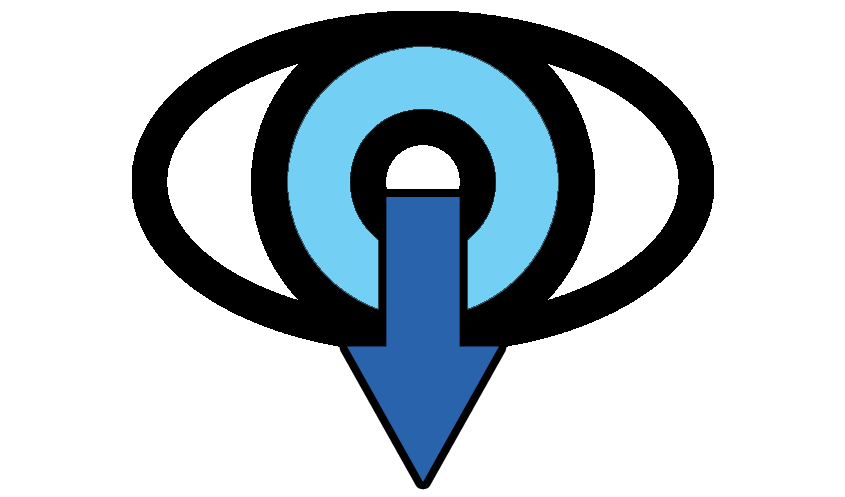
src/TabletGUI/data/eye_down.png
