ProjectKitchen/RoboFriend/src/TabletGUI/data/eye_left.png

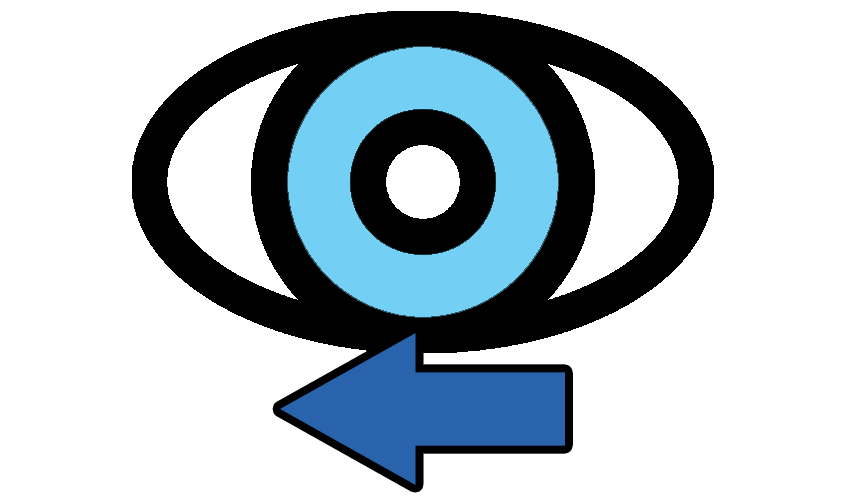
src/TabletGUI/data/eye_left.png
