ProjectKitchen/RoboFriend/src/TabletGUI/data/gear.png

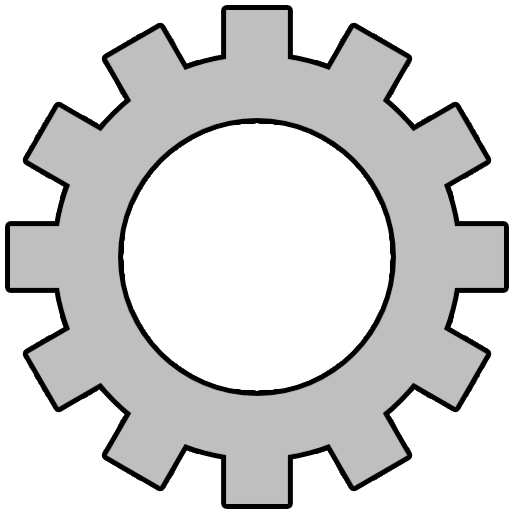
src/TabletGUI/data/gear.png
