ProjectKitchen/RoboFriend/src/TabletGUI/data/sadM.PNG

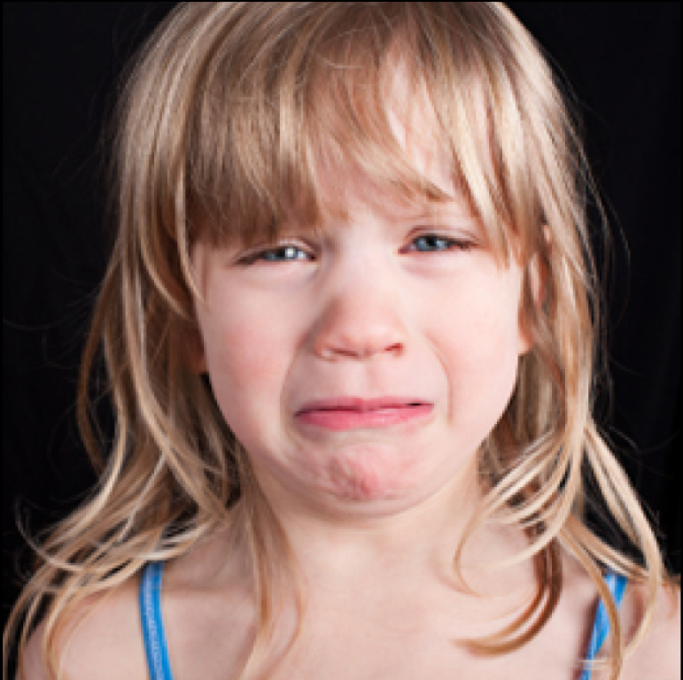
src/TabletGUI/data/sadM.PNG
