ProjectKitchen/RoboFriend/src/TabletGUI/data/spiel2.png

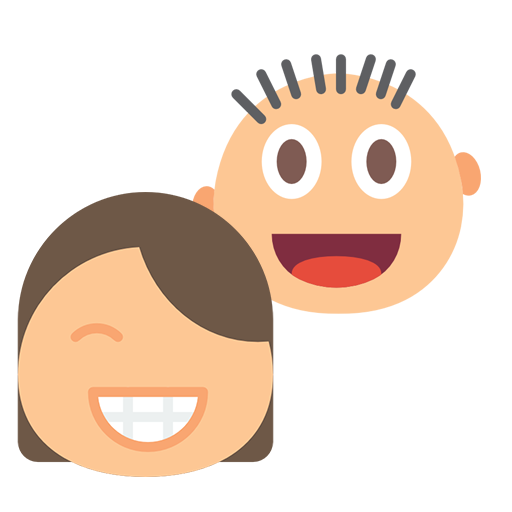
src/TabletGUI/data/spiel2.png
