ProjectKitchen/RoboFriend/pcb/bom/bom-v2.xls

Lfd.Nr. | Ref.Nr. | Bauteilname | Nennwert | Spannungs-festigkeit [V] | Kommentar | Bauform | Stück | Lieferant | Best.Nr. | Mindestbestellmenge | Bestell-menge | Preis [€]
1 | C[1..C4], C6, C[8..10] | Keramikko | 100n | 10V | +5V | 0603 | 8 | Farnell | 2522597 (https://at.farnell.com/kemet/c0603c104k4rac7081/kondensator-mlcc-x7r-0-1uf-16v/dp/2522597) | 10 | 30 | 1.9170
2 | C11 | Keramikko | 470n | 10V | +5V | 0805 | 1 | Farnell | 3352043 (http://at.farnell.com/yageo-phycomp/cc0805kkx7r6bb474/kondensator-mlcc-x7r-470nf-10v/dp/3352043) | 5 | 5 | 0.6750
3 | C12, C13, C22, C23 | Keramikko | 100n | 16V |  | 0805 | 4 | Farnell | 2905578 (http://at.farnell.com/kemet/c0805x104k4ractu/kondensator-mlcc-0-1uf-16v-0805/dp/2905578) | 10 | 20 | 5.2200
4 | C14, C16 | Keramikko | 4,7µ | 16V | +12V | 0805 | 2 | Farnell | 2346926 (http://at.farnell.com/tdk/c2012x5r1c475k125ac/kondensator-mlcc-x5r-4-7uf-16v/dp/2346926) | 5 | 10 | 3.8900
5 | C19, C21 | Keramikko | 1n | 10V | - | 0805 | 2 | Farnell | 2812132 (http://at.farnell.com/wurth-elektronik/885012007008/kondensator-mlcc-c0g-1000pf-10v/dp/2812132) | 10 | 10 | 0.7800
6 | C20 | Keramikko | 10n | 10V | - | 0805 | 1 | Farnell | 2534050 (http://at.farnell.com/wurth-elektronik/885012207011/kondensator-mlcc-x7r-0-01uf-10v/dp/2534050) | 10 | 10 | 0.4580
7 | C5 | Elko | 100µ | 16V | +12V | - | 1 | Farnell | 2326111 (http://at.farnell.com/panasonic-electronic-components/eee1ca101wap/alu-elko-100uf-16v-smd/dp/2326111) | 1 | 5 | 1.5400
8 | C7 | Elko | 33µ | 16V | +12V | - | 1 | Farnell | 2326117 (http://at.farnell.com/panasonic-electronic-components/eee1ca330wr/alu-elko-33uf-16v-smd/dp/2326117) | 1 | 5 | 1.1650
9 | C15 | Elko | 33µ | 6,3V | +3V3 | - | 1 | Farnell | 2326090 (http://at.farnell.com/panasonic-electronic-components/eee0ja330wr/alu-elko-33uf-6-3v-smd/dp/2326090) | 5 | 5 | 0.9500
10 | C17 | Elko | 47µ | 16V | +12V | - | 1 | Farnell | 1850100 (http://at.farnell.com/panasonic-electronic-components/eeefk1c470p/alu-elko-47uf-16v-smd/dp/1850100) | 1 | 5 | 1.3600
11 | C18 | Elko | 470µ | 16V | +12V | - | 1 | Farnell | 9695710 (http://at.farnell.com/panasonic-electronic-components/eeefk1c471p/alu-elko-470uf-16v-smd/dp/9695710) | 1 | 5 | 3.5300
12 | D1 | Zenerdiode | - | - | 6V2 | SOD-123 | 1 | Farnell | 2851286 (http://at.farnell.com/nexperia/pdz6-2bgwx/zener-diode-aec-q101-6-2v-sod/dp/2851286) | 5 | 5 | 0.1685
13 | D2 | Si-Diode | - | - | Kleinsignaldiode | SOD-323 | 1 | Farnell | 1838814 (http://at.farnell.com/on-semiconductor/mmdl914t1g/schaltdiode-ssd-100v-0-2a-sod323/dp/1838814) | 5 | 5 | 0.5050
14 | D3 | Si-Diode | - | - | Gleichrichterdiode | SOD-123 | 1 | Farnell | 1525525 (http://at.farnell.com/rohm/rr264m-400tr/diode-std-erholzeit-0-7a-400v/dp/1525525) | 5 | 5 | 1.5270
15 | D4, D7 | LED | - | - | - | 0805 | 2 | Farnell | 1226392 (http://at.farnell.com/osram-opto-semiconductors/lsr976/led-smd-rot/dp/1226392) | 5 | 10 | 1.0912
16 | D5, D6 | Schotkky | - | - | - | SOD-323 | 2 | Farnell | 1843687 (http://at.farnell.com/diodes-inc/bat54ws-7-f/schottky-diode-30v-0-2w-sod-323/dp/1843687?st=bat54) | 5 | 10 | 1.4960
17 | D8 | Schotkky | - | - | - | SOD-123 | 1 | Farnell | 2284963 (http://at.farnell.com/panasonic-electronic-components/db2x41500l/schottky-diode-40v-mini2-f4-b/dp/2284963) | 5 | 5 | 1.6325
18 | D[9, 18] | Si-Diode | - | - | Kleinsignaldiode | SOD-523 | 10 | Farnell | 2528921 (http://at.farnell.com/rohm/1ss400smfht2r/schaltdiode-90v-sod-523/dp/2528921) | 5 | 40 | 3.4800
19 | D19 | Si-Diode | - | - | Gleichrichterdiode | SOD-323 | 1 | Farnell | 2463430 (http://at.farnell.com/on-semiconductor/mmdl301t1g/hf-schottky-diode-1-5pf-30v-sod/dp/2463430) | 5 | 5 | 0.7100
20 | J13, J14, J24, J25, JP1, JP4 | Pinheader | - | - | 01x02 | - | 6 | - | - | - | - | -
21 | J[28..32], JP2, JP3, JP5 | Pinheader | - | - | 01x03 | - | 8 | - | - | - | - | -
22 | J1, J[5..9], J15, J16, J20 | Pinheader | - | - | 01x04 | - | 9 | - | - | - | - | -
23 | J[21..23] | Pinheader | - | - | 02x05 |  | 3 | - | - | - | - | -
24 | J[10..12], J18, J26, J27 | Connector | - | - | Molex 2-polig | - | 6 | - | - | - | - | -
25 | J2, J3, J19 | Connector | - | - | Molex 6-polig | - | 3 | - | - | - | - | -
26 | J17 | Connector | - | - | USB Connector | - | 1 | Farnell | 1642033 (https://at.farnell.com/wurth-elektronik/61400416021/usb-2-0-buchse-typ-a-tht/dp/1642033) | 1 | 3 | 2.1701
27 | K1 | Relais | - | - | 12VDC | - | 1 | Farnell | 2885607 (http://at.farnell.com/schrack-te-connectivity/rt334012wg/leistungsrelais-spst-no-16a-250vac/dp/2885607) | 1 | 3 | 6.3624
28 | Q1 | MOSFET | - | - | NMOS | SOT-23 | 1 | Farnell | 2724423 (http://at.farnell.com/on-semiconductor/ntr5103nt1g/mosfet-n-kanal-60v-0-26a-sot-23/dp/2724423) | 5 | 5 | 0.5300
29 | Q2 | Transistor | - | - | NPN | SOT-23 | 1 | Farnell | 2727982 (http://at.farnell.com/on-semiconductor/mmbt3416lt3g/transistor-npn-40v-0-1a-sot-23/dp/2727982) | 5 | 5 | 0.0980
30 | Q3 | MOSFET | - | - | PMOS | TO-263-2 | 1 | Farnell | 1298511 (http://at.farnell.com/infineon/irf4905strlpbf/mosfet-p-kanal-55v-d2-pak/dp/1298511) | 5 | 5 | 7.5500
31 | R1 | Widerstand | 4,7k | - | - | 0805 | 1 | Farnell | 2074469 (http://at.farnell.com/multicomp/mcsr08x4701ftl/keramikwiderstand-4k7-1-0-125w/dp/2074469) | 10 | 10 | 0.2340
32 | R2 | Widerstand | 47k | - | - | 0805 | 1 | Farnell | 2447664 (http://at.farnell.com/multicomp/mcwr08x4702ftl/dickschichtwiderstand-47k-1-0/dp/2447664) | 10 | 10 | 0.0840
33 | R3 | Widerstand | 20k | - | - | 0805 | 1 | Farnell | 2074395 (http://at.farnell.com/multicomp/mcsr08x2002ftl/keramikwiderstand-20k-1-0-125w/dp/2074395) | 10 | 10 | 0.1570
34 | R4, R16 | Widerstand | 10k | - | - | 0805 | 2 | Farnell | 2826050 (http://at.farnell.com/multicomp/mchvr05jtew1002/dicksch-widerstand-10k-5-0-125w/dp/2826050) | 10 | 10 | 0.2730
35 | R5 | Widerstand | 1M | - | - | 0805 | 1 | Farnell | 2447596 (http://at.farnell.com/multicomp/mcwr08x1004ftl/dickschichtwiderstand-1m-1-0-125w/dp/2447596) | 10 | 10 | 0.0840
36 | R6, R15, R17, R18 | Widerstand | 1k | - | - | 0805 | 4 | Farnell | 2074338 (http://at.farnell.com/multicomp/mcsr08x102-jtl/keramikwiderstand-1k-5-0-125w/dp/2074338) | 10 | 20 | 0.2440
37 | R7 | Widerstand | 12k | - | - | 0805 | 1 | Farnell | 2447563 (http://at.farnell.com/multicomp/mcwr08x1202ftl/dickschichtwiderstand-12k-1-0/dp/2447563) | 10 | 10 | 0.0840
38 | R8 | Widerstand | 18k | - | Ersatz: 3x 7,5k, 0805, (2074512) | 0805 | 1 | Farnell | 2447584 (http://at.farnell.com/multicomp/mcwr08x1802ftl/dickschichtwiderst-18kohm-1-0/dp/2447584) | 10 | 10 | 0.0840
39 | R9 | Widerstand | 3k | - |  | 0805 | 1 | Farnell | 2073731 (http://at.farnell.com/multicomp/mcmr08x3001ftl/keramikwiderstand-3k-1-0-125w/dp/2073731) | 10 | 10 | 0.1160
40 | R10, R[12..14] | Widerstand | 4,7k | - | - | 0603 | 4 | Farnell | 2694880 (https://at.farnell.com/multicomp/mcwr06x472-jtl/dickschichtwiderstand-4k7-5-0/dp/2694880) | 10 | 20 | 0.0898
41 | R11 | Widerstand | 39k | - | Ersatz: 10x 0R, 0805, (2309112) | 0805 | 1 | Farnell | 2073761 (http://at.farnell.com/multicomp/mcmr08x3902ftl/keramikwiderstand-39k-1-0-125w/dp/2073761) | 10 | 10 | 0.0650
42 | R19 | Shunt | 0,01R | - | - | 2512 | 1 | Farnell | 1470053 (http://at.farnell.com/vishay/wsl2512r0100fek/widerstand-2512-0-01r-1/dp/1470053) | 1 | 3 | 4.2000
43 | R20, R21 | Widerstand | 100R | - | - | 0805 | 2 | Farnell | 9333703 (http://at.farnell.com/multicomp/mc01w08055100r/dickschichtwiderstand-100r-5-0/dp/9333703) | 10 | 10 | 0.0950
44 | R22, R[24..27] | Widerstand | 100k | - | - | 0603 | 5 | Farnell | 2447226 (https://at.farnell.com/multicomp/mcwr06x1003ftl/dickschichtwiderstand-100k-1-0/dp/2447226) | 10 | 20 | 0.0968
45 | R23 | Widerstand | 910 | - | Ersatz: 3x 750R, 0603 (2447432) | 0603 | 1 | Farnell | 2447448 (https://at.farnell.com/multicomp/mcwr06x9100ftl/dickschichtwiderstand-910-ohm/dp/2447448) | 10 | 10 | 0.0484
46 | R28 | Widerstand | 10k | - | Ersatz: 10x 0R, 0603 (2309111) | 0603 | 1 | Farnell | 2447230 (https://at.farnell.com/multicomp/mcwr06x1002ftl/dickschichtwiderstand-10k-1-0/dp/2447230) | 10 | 10 | 0.0484
47 | RV1, RV2 | Trimmer | 100k | - | - | 3296W | 2 | Farnell | 9353194 (http://at.farnell.com/bourns/3296w-1-104lf/trimmpotentiometer-25-gang-100k/dp/9353194) | 1 | 6 | 13.3800
48 | U1, U4 | Level Shifter | - | - | Unidirektional | SOT-363 | 2 | Farnell | 2164896 (http://at.farnell.com/nexperia/74lvc1t45gw/ic-umsetzender-txrx-2fach-sot363/dp/2164896?st=74LVC1T45) | 5 | 10 | 3.1900
49 | U3, U10 | OPV | - | - | Komparator, TL331 | SOT-23-5 | 2 | Farnell | 1755443 (http://at.farnell.com/texas-instruments/tl331kdbvt/diff-komparator-single-sot23-5/dp/1755443?st=tl331) | 1 | 6 | 2.4396
50 | U5 | Level Shifter | - | - | Bidirektional | SOIC-8 | 1 | Farnell | 2101306 (http://at.farnell.com/nxp/pca9517d-118/ic-i2c-bus-repeater-5-5v-8soic/dp/2101306?st=pca9517) | 1 | 3 | 3.2400
51 | U6 | OPV | - | - | Impedanzwandler, MCP6001 | SOT-23-5 | 1 | Farnell | 8540829 (http://at.farnell.com/microchip/mcp6001rt-i-ot/op-amp-cmos-1mhz-1-8v-smd-6001/dp/8540829?st=mcp6001) | 1 | 3 | 0.6300
52 | U7 | LDO | - | - | 3V3 Regulator, LM3940 | SOT-223 | 1 | Farnell | 1469104 (http://at.farnell.com/texas-instruments/lm3940imp-3-3-nopb/spannungsregler-linear-3-3v-smd/dp/1469104) | 1 | 3 | 3.9600
53 | U8 | Precision Shunt | - | - | LM4040 | SOT-23 | 1 | Farnell | 1468830 (http://at.farnell.com/texas-instruments/lm4040aim3-4-1-nopb/spannungsref-shunt-4-096v-sot/dp/1468830?st=lm4040) | 1 | 3 | 4.0128
54 | U9 | OPV | - | - | Komparator, INA193 | SOT-23-5 | 1 | Farnell | 1903412 (http://at.farnell.com/texas-instruments/ina193aqdbvrq1/strom-monitor-3-5sot23/dp/1903412?st=ina193) | 1 | 3 | 4.9896
 |  |  |  |  |  |  |  |  |  |  |  | 90.6510
