ProjectKitchen/RoboFriend/documentation/Robofriend Mappe/5_Power Supply/LT1584 fixA posreg ds.pdf

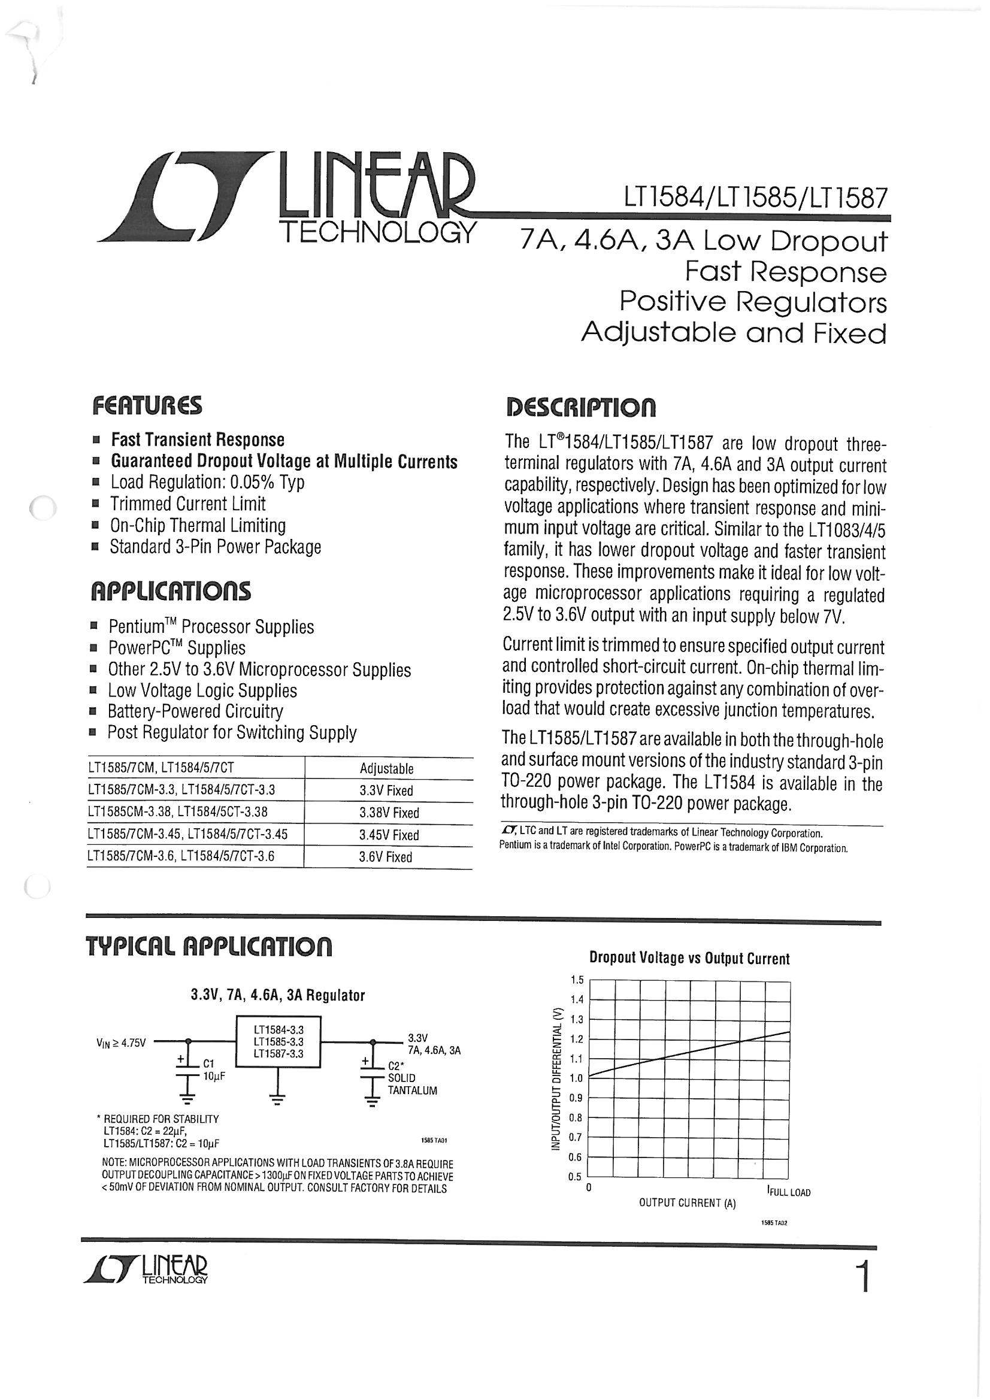
[picture p106: page 1]
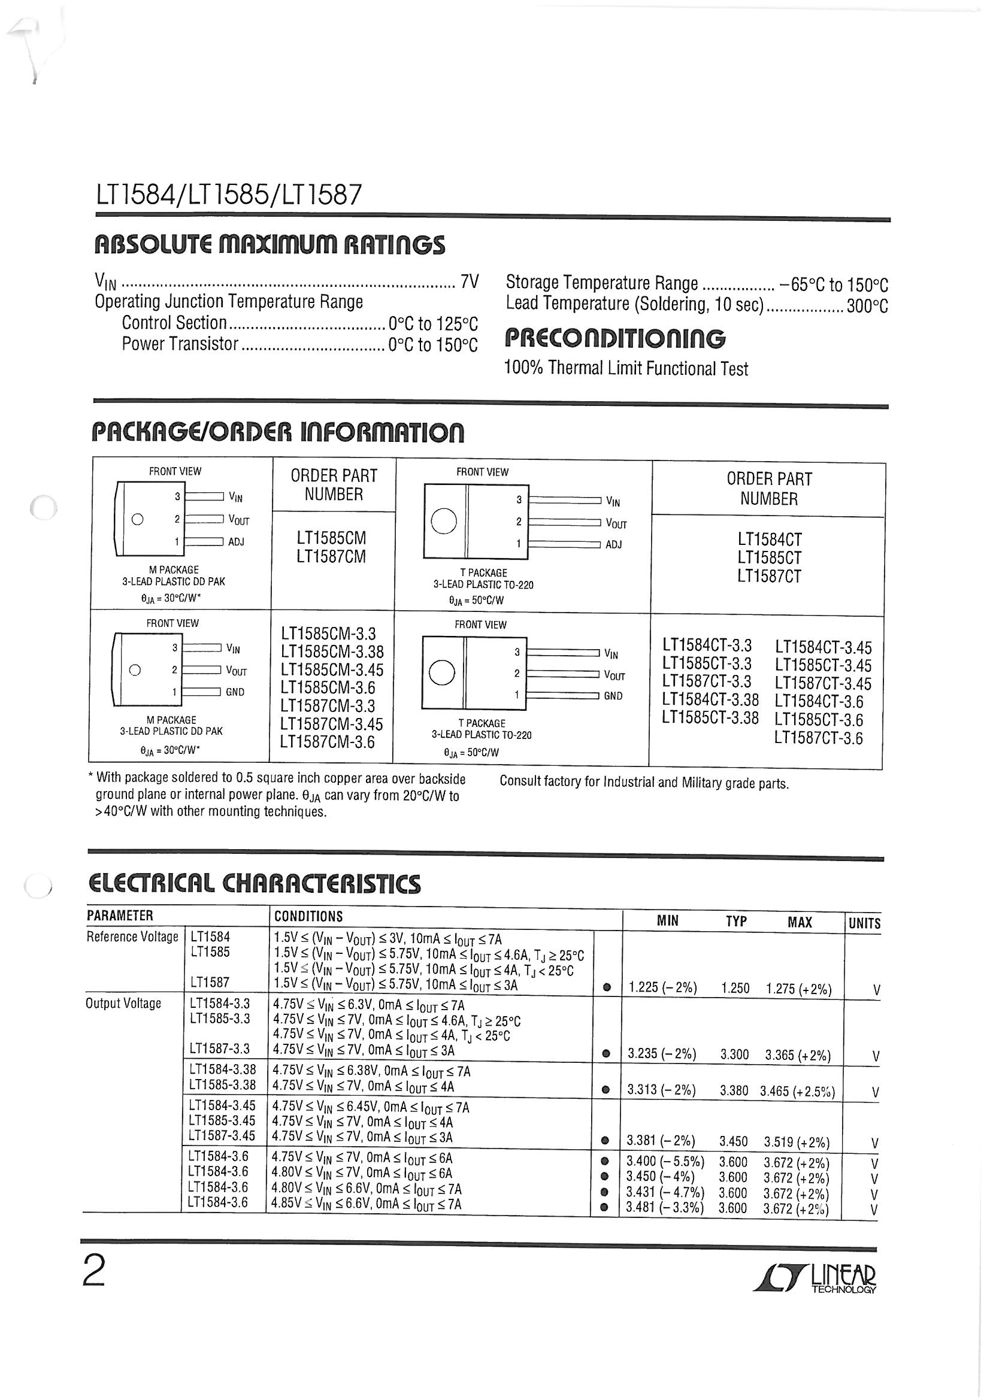
[picture p107: page 2]
