ProjectKitchen/RoboFriend/pcb/plot/robofriend-bw.pdf

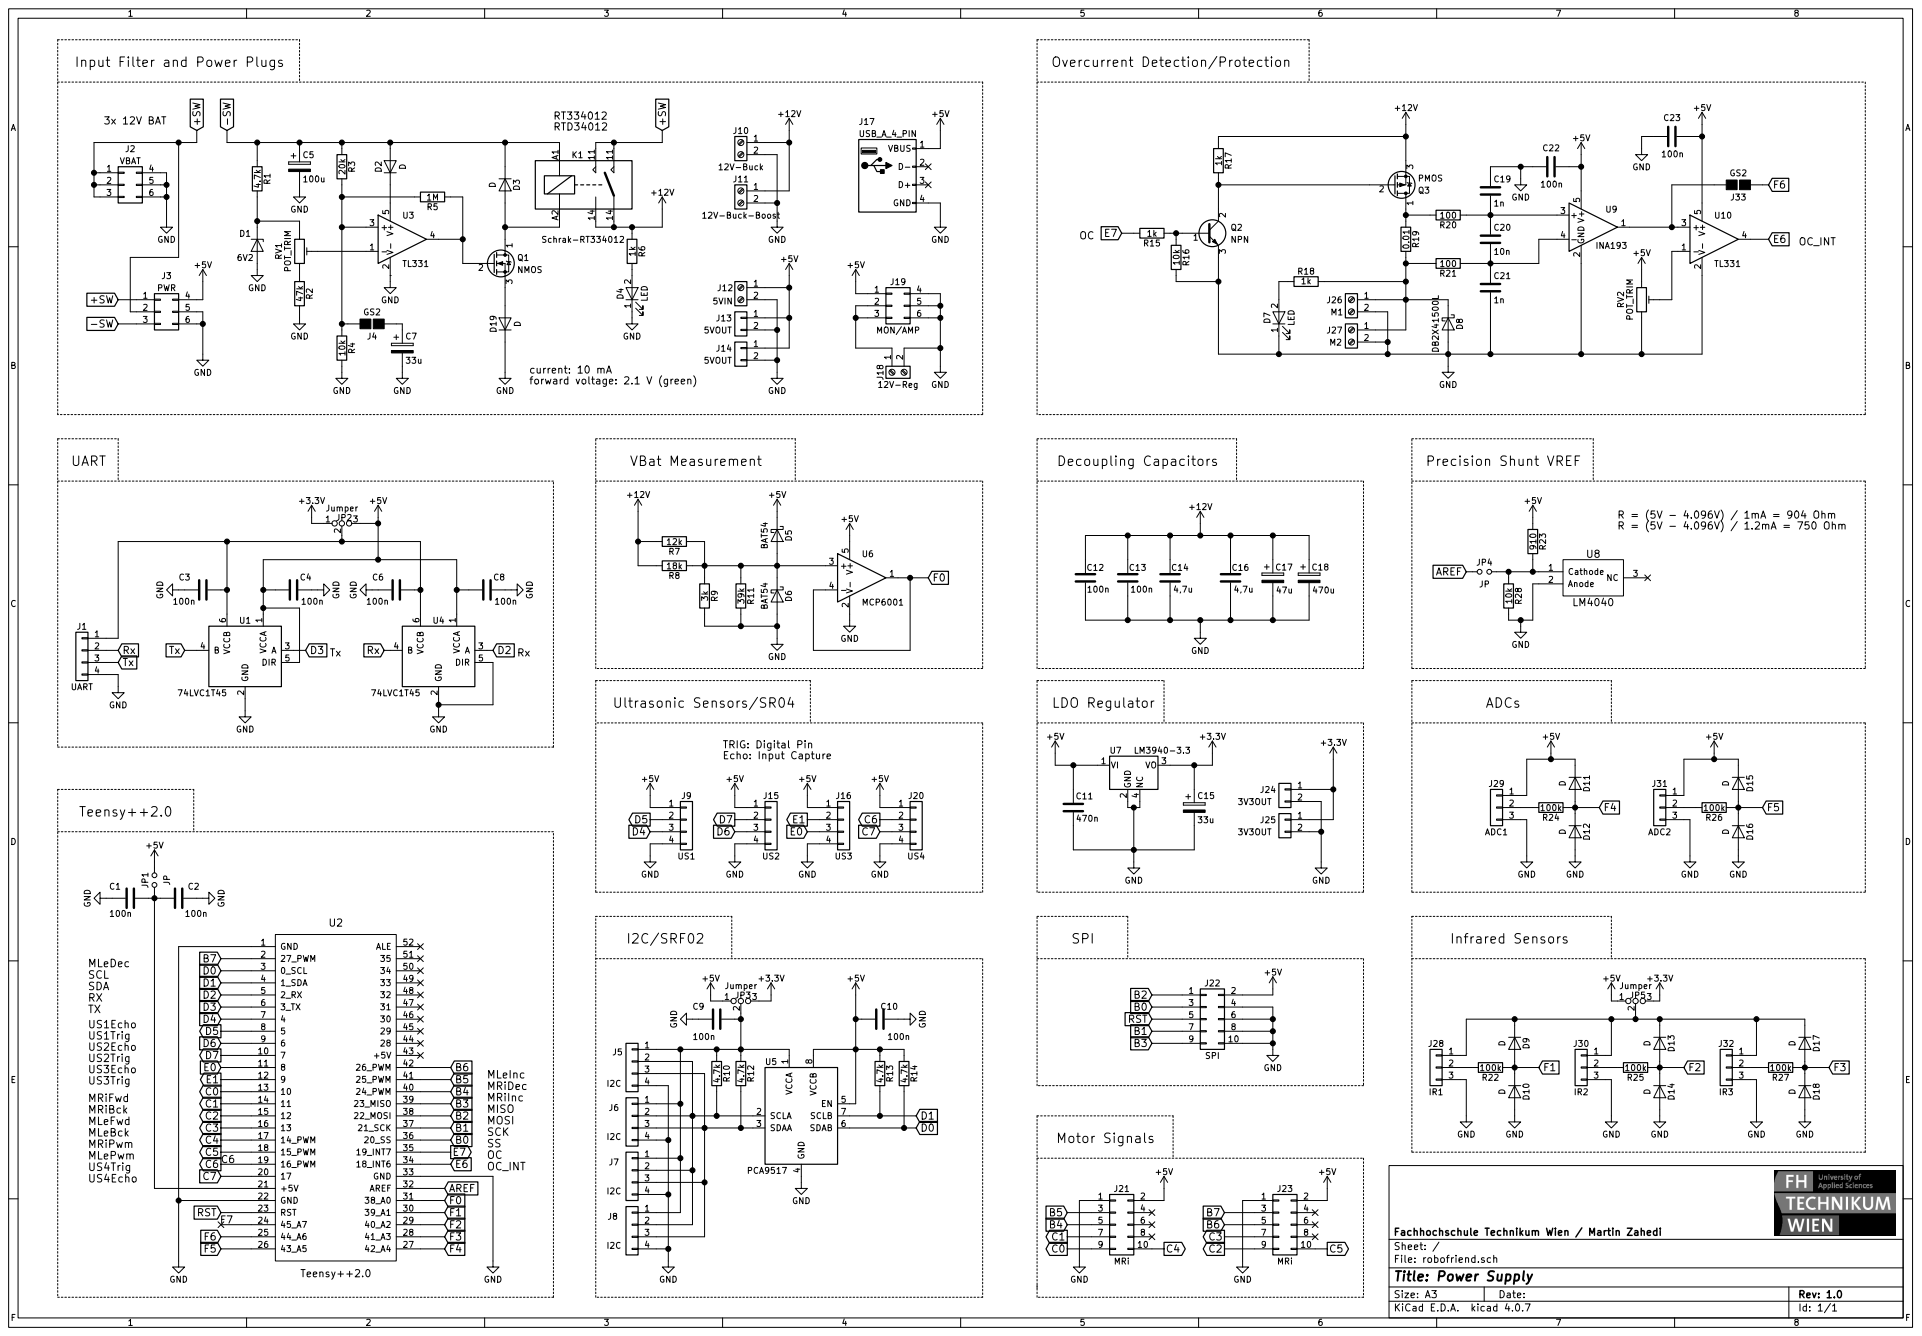
[picture p108: page 1]
