ProjectKitchen/RoboFriend/pcb/plot/robofriend-color.pdf

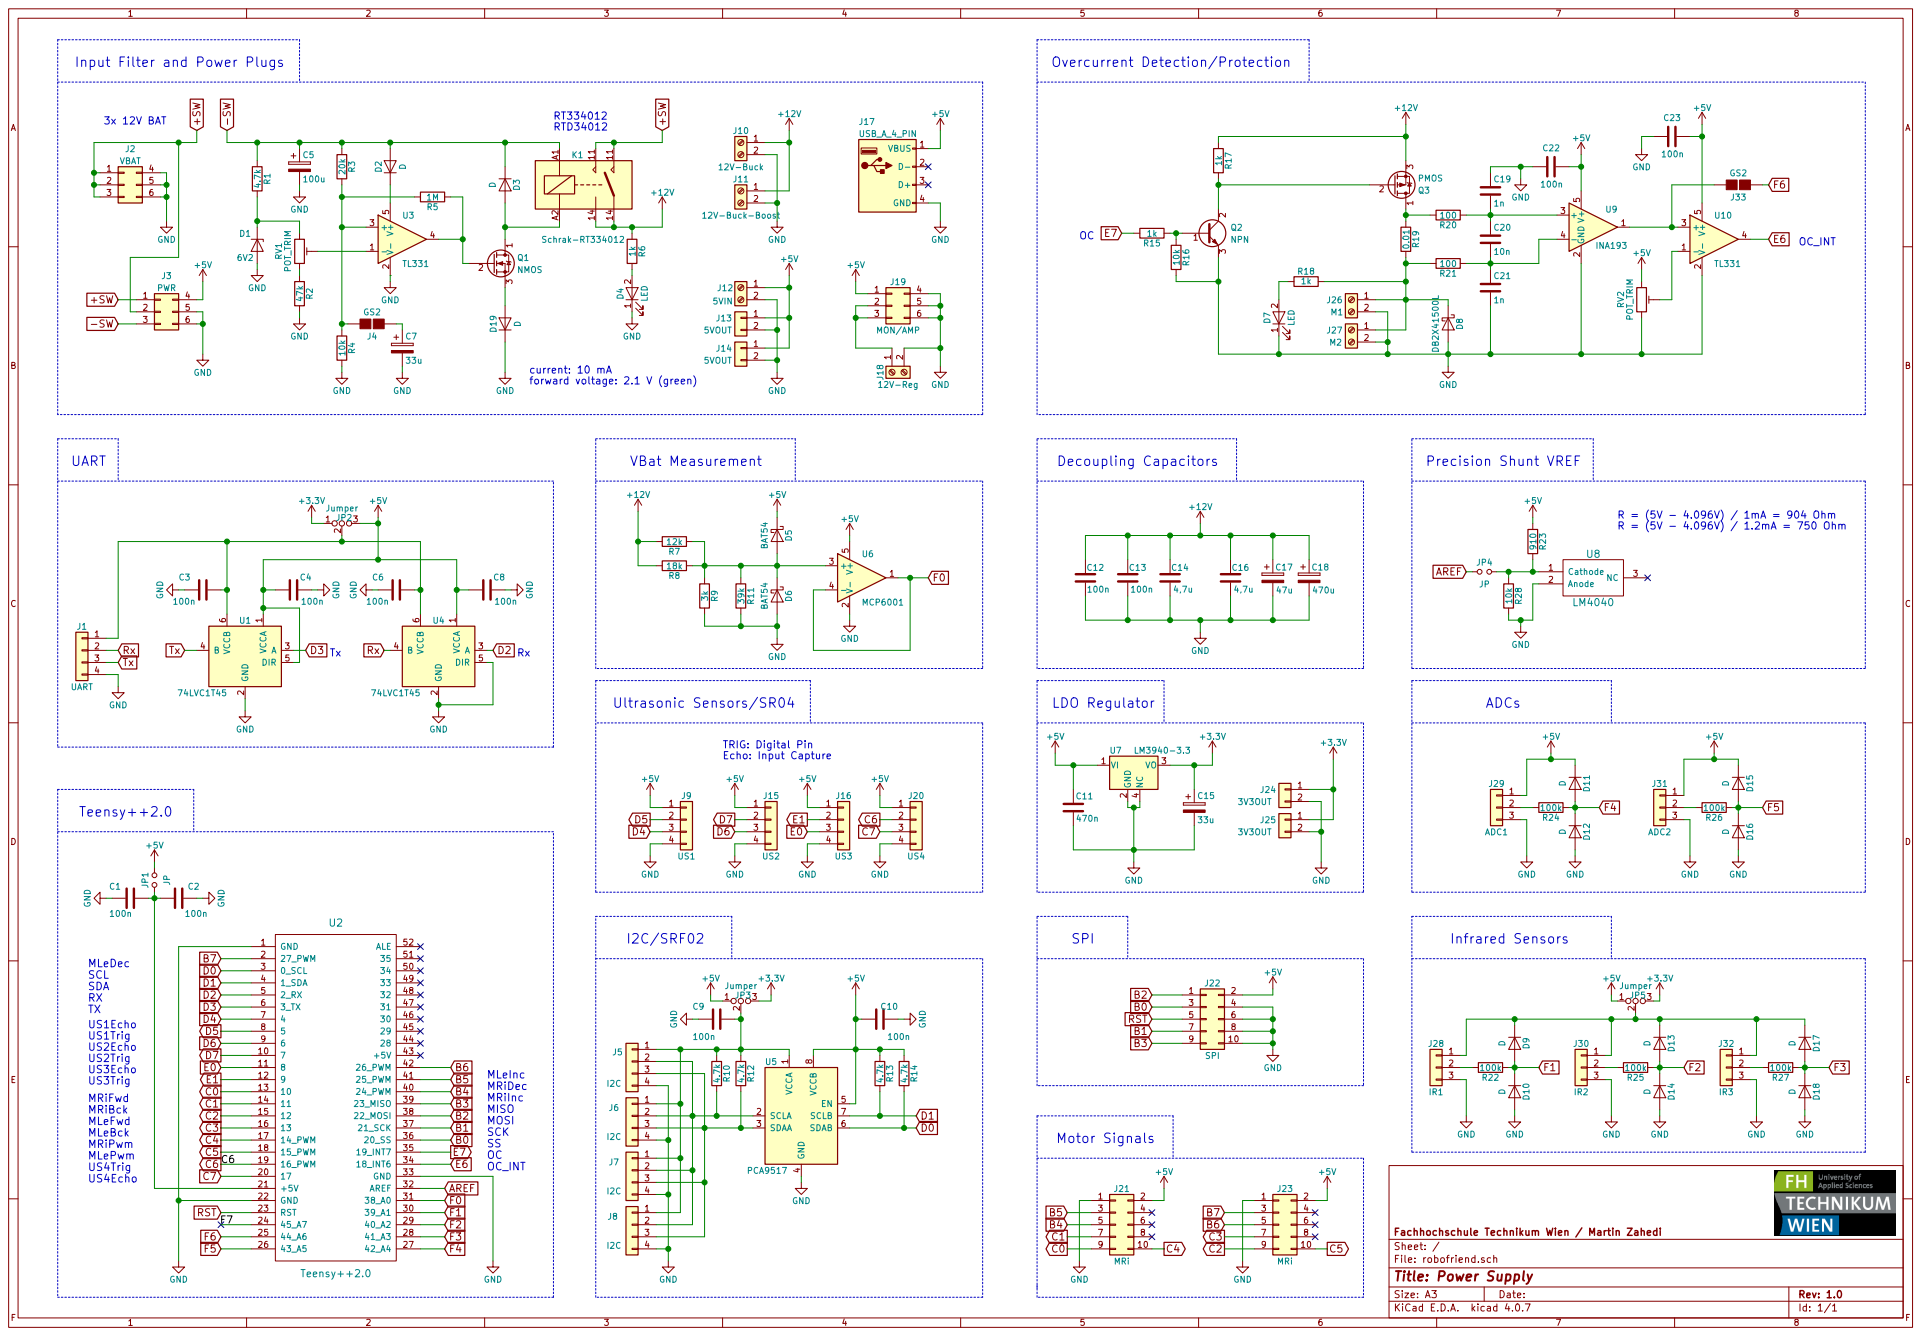
[picture p109: page 1]
