ProjectKitchen/RoboFriend/simulation/supply/supply.asc

C2: polcap; 33µ; V=16V
D2: zener; BZX84B6V2L
D3: diode; 1N4148
D4: diode; 1N4148
D6: diode; 1N4148
D7: diode; 1N4148
D9: schottky; BAT54
D10: schottky; BAT54
M1: nmos; 2N7002
M3: pmos; FDS6576
Q1: npn; 2N4124
R1: EuropeanResistor; 4.7k
R2: EuropeanResistor; 47k
R3: EuropeanResistor; 20k
R4: EuropeanResistor; 12k
R5: EuropeanResistor; 18k
R6: EuropeanResistor; 10k
R8: EuropeanResistor; 3k
R9: EuropeanResistor; 1k
R10: EuropeanResistor; 0.01
R11: EuropeanResistor; 1k
R12: EuropeanResistor; 1k
R13: EuropeanResistor; 33k
R14: EuropeanResistor; 33k
R16: EuropeanResistor; 10k
R17: EuropeanResistor; 1k
R18: EuropeanResistor; 39k
R19: EuropeanResistor; 1.2
R20: EuropeanResistor; 12
R23: EuropeanResistor; 24
R24: EuropeanResistor; 24
R25: EuropeanResistor; 1Meg
U1: UniversalOpamp2
U2: UniversalOpamp2
U3: UniversalOpamp2
U5: UniversalOpamp2
V1: voltage; PULSE(10.5V 14.7V 0 2s 2s 0 4s)
V3: voltage; 5V
V7: voltage; PULSE(5V 0 0 1u 1u 600ms 2s)
X1: pot; R=10k Val=34
X2: pot; R=100k Val=62.5
X4: relais; ION=7m IOFF=2m LL=63m RR=360
Named nets: Vbat, 0, OC, 5V, OC_INT, AP1, AP2, AP3
.tran 8s
Overcurrent Protection
Shunt: 0,1 V / 10 A = 0,01 Ohm
Shunt: P = 10² A * 0,01 Ohm = 1 W
Differential Amp: 
Ua = (U+ - U-) * R14 / R12 = 3.3 V
Poti: Ua = 3.25 V
Reverse
Polarity
Protection
Deep Discharge Protection
Monitor
Audio
Amp
Motor
Vbat
Measurement
Buck
Module
TL331
INA193
MCP6001
TL331
