ProjectKitchen/RoboFriend/simulation/vbat/vbat.asc

D6: schottky; BAT54
D7: schottky; BAT54
R8: EuropeanResistor; 7.2k
R9: EuropeanResistor; 2.78k
U1: UniversalOpamp2
V1: voltage; 5V
V2: voltage; PULSE(10.5V 14.7V 0 25m 25m 0 50m)
Named nets: 0, AP, 5V
.tran 0 200m 0 100m startup
