ProjectKitchen/RoboFriend/simulation/supply/relais.asc

L1: ind; {LL}; Ipk=20m Rser=0 Rpar=100Meg Cpar=0
R1: res; {RR}
S1: sw
Named nets: 1, 2, 3, 4
.param LL=63mH
.param RR=360
.param ION=7mA
.param IOFF=2mA
.param VTH=RR*(ION+IOFF)/2
.param VHY=RR*(ION-IOFF)/2
old val:
.model SW SW(vt={VTH} vh={VHY})
.model SW SW(Ron=.1 Roff=1Meg Vt=8.4 Vh={VHY})
