ProjectKitchen/RoboFriend/simulation/supply/pot.asc

R1: res; {Ra}
R2: res; {Rb}
Named nets: 1, 2, 3
.param Ra = R * (Val / 100)
.param Rb = R * (1 - (Val / 100))
