ProjectKitchen/RoboFriend/(list of files, drawings)

Other design files:
pcb/kicad/robofriend.dsn
