ProjectKitchen/RoboFriend/pcb/kicad/robofriend.kicad_pcb

## KiCad design pcb/kicad/robofriend.kicad_pcb (2018-10-22)

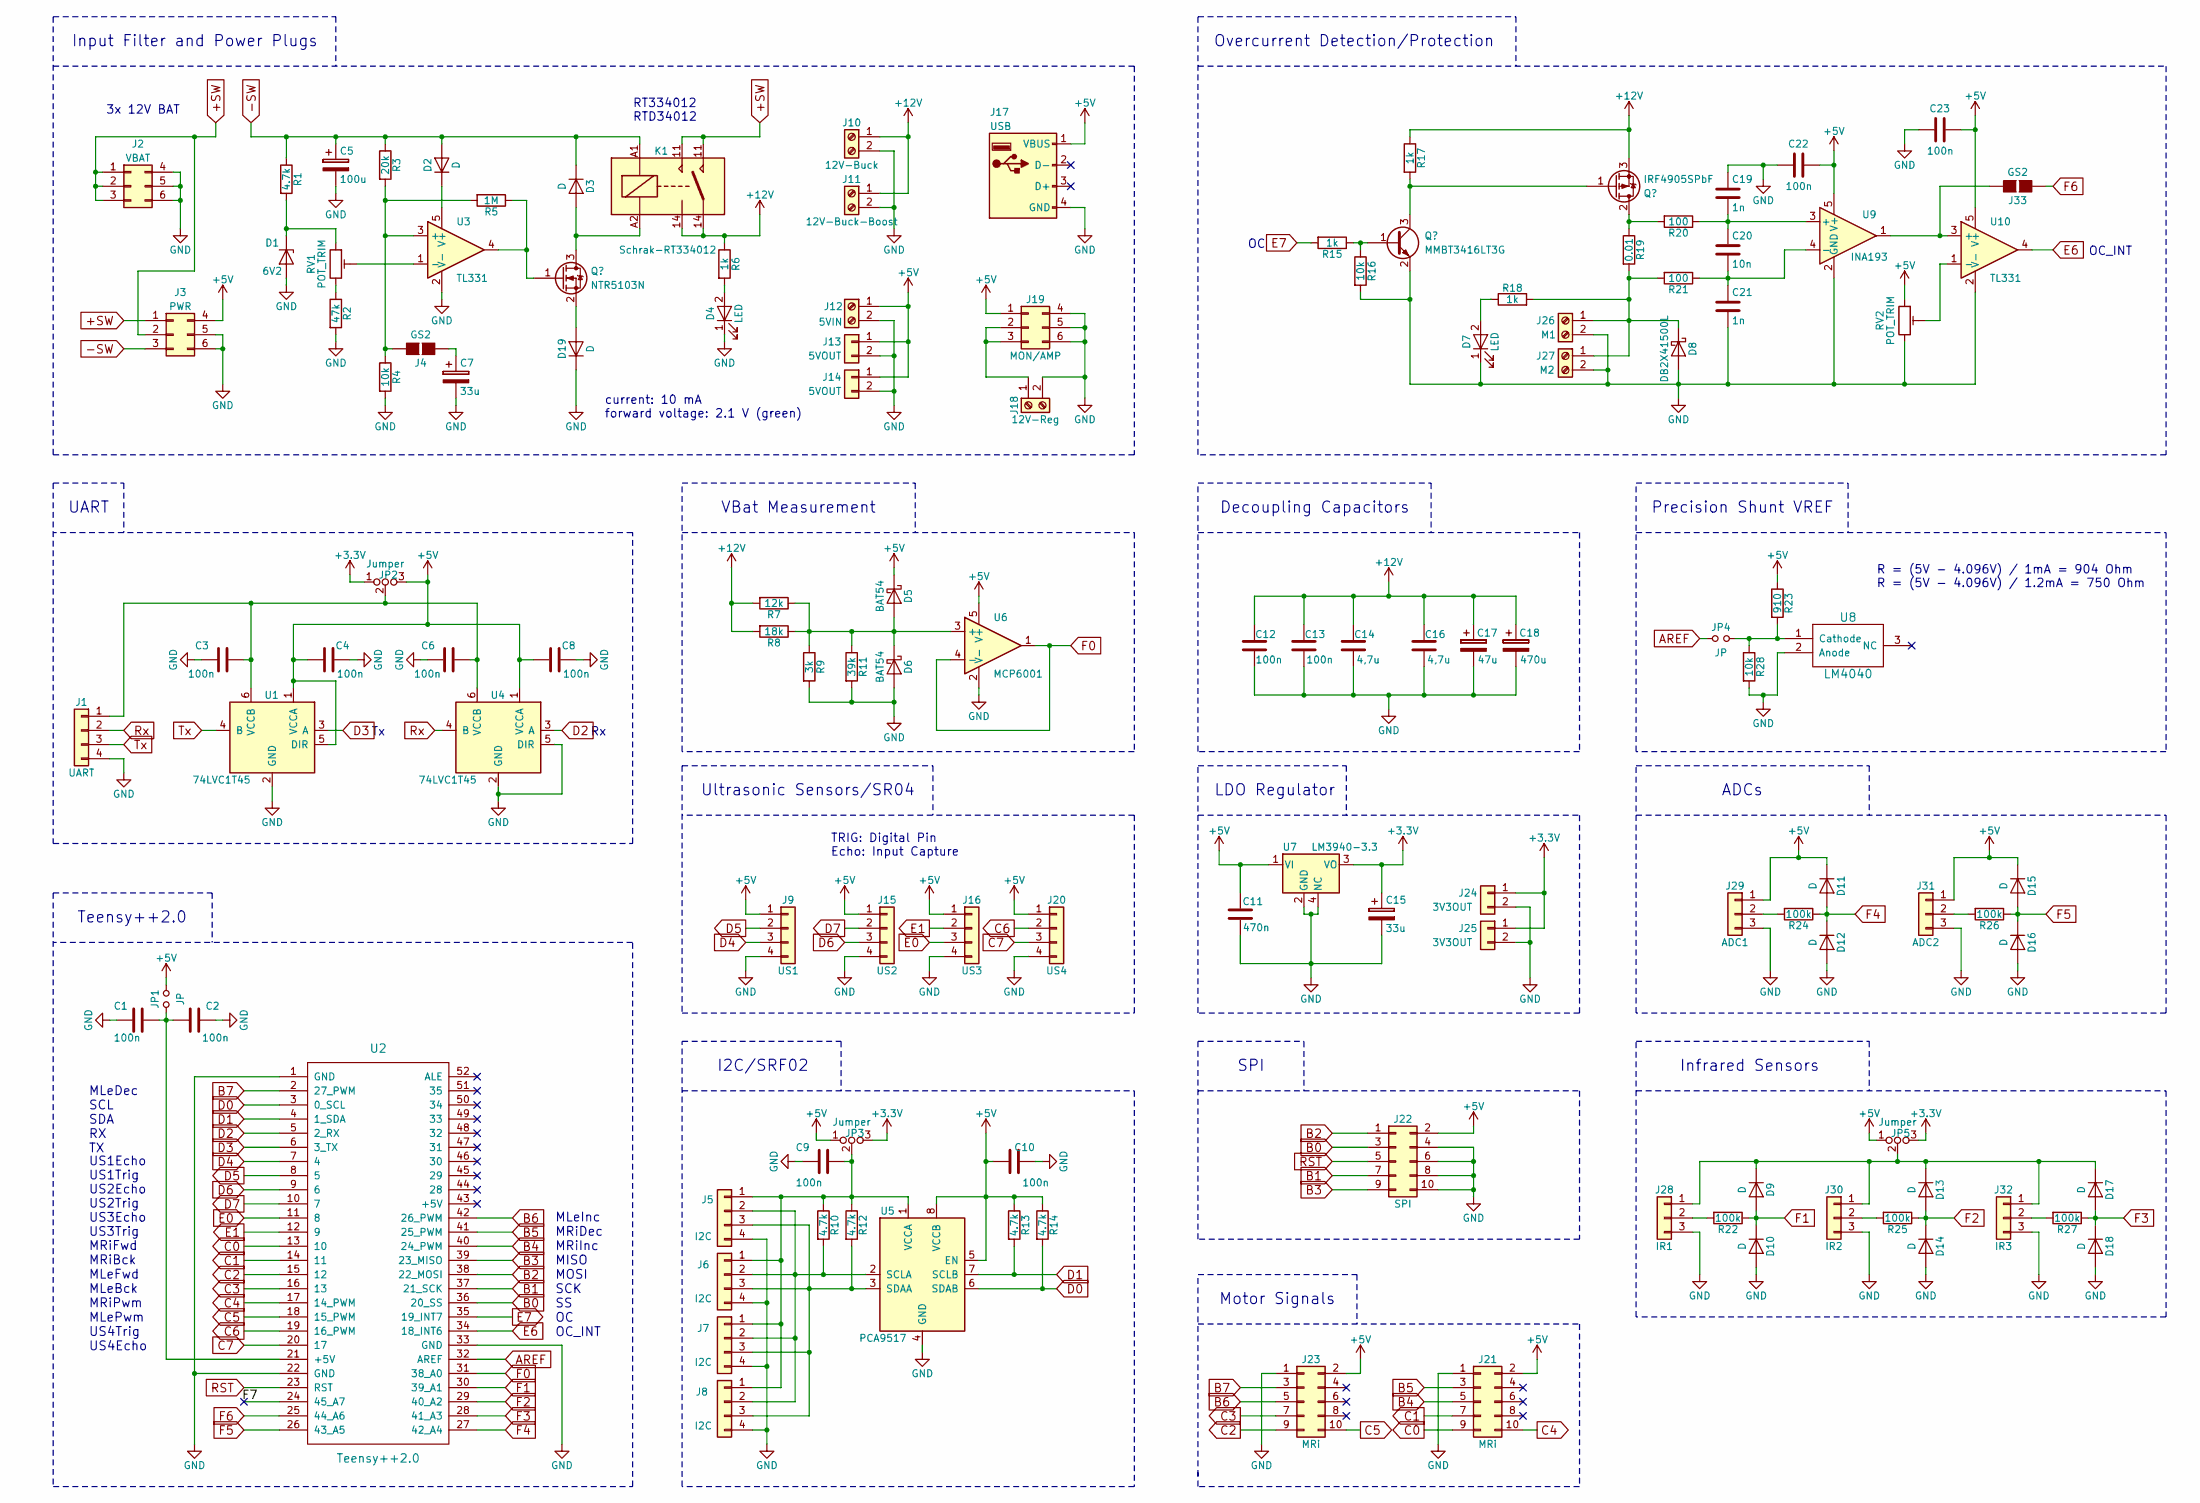
[picture p110: schematic robofriend.sch, Power Supply]

Parts:
C1, C2, C3, C4, C6, C8, C9, C10: 100n; C_0603
C5: 100u; CP_Elec_6.3x5.7; Part No EEE1CA101WAP
C7: 33u; CP_Elec_5x5.7; Part No EEE1CA330WR
C11: 470n; C_0805
C12, C13, C22, C23: 100n; C_0805
C14, C16: 4,7u; C_0805
C15: 33u; CP_Elec_4x5.7; Part No EEE0JA330WR
C17: 47u; CP_Elec_6.3x5.8; Part No EEEFK1C470P
C18: 470u; CP_Elec_8x10.5; Part No EEEFK1C471P
C19, C21: 1n; C_0805
C20: 10n; C_0805
D1: 6V2; D_SOD-123
D2, D19: D; D_SOD-323
D3: D; D_SOD-123
D4, D7: LED; LED_0805
D5, D6: BAT54; D_SOD-323; Part No BAT54WS-7-F
D8: DB2X41500L; D_SOD-123; Part No DB2X41500L
D9, D10, D11, D12, D13, D14, D15, D16, D17, D18: D; D_SOD-523
J1: UART; Pin_Header_Straight_1x04_Pitch2.54mm
J2: VBAT; Molex_MiniFit-JR-5556-06A_2x03x4.20mm_Straight
J3: PWR; Molex_MiniFit-JR-5556-06A_2x03x4.20mm_Straight
J4, J33: GS2
J5, J6, J7, J8: I2C; Pin_Header_Straight_1x04_Pitch2.54mm
J9: US1; Pin_Header_Straight_1x04_Pitch2.54mm
J10: 12V-Buck; Molex_MiniFit-JR-5556-02B_2x01x4.20mm_Straight
J11: 12V-Buck-Boost; Molex_MiniFit-JR-5556-02B_2x01x4.20mm_Straight
J12: 5VIN; Molex_MiniFit-JR-5556-02B_2x01x4.20mm_Straight
J13, J14: 5VOUT; Pin_Header_Straight_2x01_Pitch2.54mm
J15: US2; Pin_Header_Straight_1x04_Pitch2.54mm
J16: US3; Pin_Header_Straight_1x04_Pitch2.54mm
J17: USB; WURTH_61400416021; Part No 48258-0001
J18: 12V-Reg; Molex_MiniFit-JR-5556-02B_2x01x4.20mm_Straight
J19: MON/AMP; Molex_MiniFit-JR-5556-06A_2x03x4.20mm_Straight
J20: US4; Pin_Header_Straight_1x04_Pitch2.54mm
J21, J23: MRi; Pin_Header_Straight_2x05_Pitch2.54mm
J22: SPI; Pin_Header_Straight_2x05_Pitch2.54mm
J24, J25: 3V3OUT; Pin_Header_Straight_2x01_Pitch2.54mm
J26: M1; Molex_MiniFit-JR-5556-02B_2x01x4.20mm_Straight
J27: M2; Molex_MiniFit-JR-5556-02B_2x01x4.20mm_Straight
J28: IR1; Pin_Header_Straight_1x03_Pitch2.54mm
J29: ADC1; Pin_Header_Straight_1x03_Pitch2.54mm
J30: IR2; Pin_Header_Straight_1x03_Pitch2.54mm
J31: ADC2; Pin_Header_Straight_1x03_Pitch2.54mm
J32: IR3; Pin_Header_Straight_1x03_Pitch2.54mm
JP1, JP4: JP; Pin_Header_Straight_1x02_Pitch2.54mm
JP2, JP3, JP5: Jumper; Pin_Header_Straight_1x03_Pitch2.54mm
K1: Schrak-RT334012; SPST_Schrack-RT33_RM5mm
R1: 4.7k; R_0805
R2: 47k; R_0805
R3: 20k; R_0805
R4, R16: 10k; R_0805
R5: 1M; R_0805
R6, R15, R17, R18: 1k; R_0805
R7: 12k; R_0805
R8: 18k; R_0805
R9: 3k; R_0805
R10, R12, R13, R14: 4.7k; R_0603
R11: 39k; R_0805
R19: 0.01; R_2512; Part No WSL2512R0100FEK
R20, R21: 100; R_0805
R22, R24, R25, R26, R27: 100k; R_0603
R23: 910; R_0603
R28: 10k; R_0603
RV1, RV2: POT_TRIM; Potentiometer_Trimmer_Bourns_3296W; Part No 3296W-1-104LF
U1, U4: 74LVC1T45; SOT-363_SC-70-6
U2: Teensy++2.0; Teensy2.0++
U3, U10: TL331; SOT-23-5
U5: PCA9517; SOIC-8_3.9x4.9mm_Pitch1.27mm
U6: MCP6001; SOT-23-5
U7: LM3940-3.3; SOT-223
U8: LM4040; SOT-23
U9: INA193; SOT-23-5

Connections:
+3V3: C15.1, J24.1, J25.1, JP2.1, JP3.3, JP5.3, U7.3 (VO)
+5V: C4.1, C8.1, C10.1, C11.2, C22.2, C23.2, D5.1 (K), D11.1 (K), D15.1 (K), J3.4, J9.1, J12.1, J13.1, J14.1, J15.1, J16.1, J17.1 (VBUS), J19.1, J20.1, J21.2, J22.2, J23.2, J29.1, J31.1, JP1.2, JP2.3, JP3.1, JP5.1, R13.1, R14.1, R23.1, RV2.1, U1.1 (VCCA), U1.5 (DIR), U4.1 (VCCA), U5.5 (EN), U5.8 (VCCB), U6.5 (V+), U7.1 (VI), U9.5 (V+), U10.5 (V+)
+12V: C12.2, C13.2, C14.2, C16.2, C17.1, C18.1, J10.1, J11.1, K1.14, R6.1, R7.2, R8.2, R17.1; also elsewhere on the board
+SW: J2.1, J2.2, J2.3, J3.1, J3.2, K1.11
-SW: C5.1, D2.2 (A), D3.1 (K), J3.3, K1.A1, R1.1, R3.1
AREF: JP4.1, U2.32 (AREF)
B0: J22.3, U2.36 (20_SS)
B1: J22.7, U2.37 (21_SCK)
B2: J22.1, U2.38 (22_MOSI)
B3: J22.9, U2.39 (23_MISO)
B4: J21.5, U2.40 (24_PWM)
B5: J21.3, U2.41 (25_PWM)
B6: J23.5, U2.42 (26_PWM)
B7: J23.3, U2.2 (27_PWM)
C0: J21.9, U2.13 (10)
C1: J21.7, U2.14 (11)
C2: J23.9, U2.15 (12)
C3: J23.7, U2.16 (13)
C4: J21.10, U2.17 (14_PWM)
C5: J23.10, U2.18 (15_PWM)
C6: J20.2, U2.19 (16_PWM)
C7: J20.3, U2.20 (17)
D0: R14.2, U2.3 (0_SCL), U5.6 (SDAB)
D1: R13.2, U2.4 (1_SDA), U5.7 (SCLB)
D2: U2.5 (2_RX), U4.3 (A)
D3: U1.3 (A), U2.6 (3_TX)
D4: J9.3, U2.7 (4)
D5: J9.2, U2.8 (5)
D6: J15.3, U2.9 (6)
D7: J15.2, U2.10 (7)
E0: J16.3, U2.11 (8)
E1: J16.2, U2.12 (9)
E6: U2.34 (18_INT6), U10.4
E7: R15.2, U2.35 (19_INT7)
F0: U2.31 (38_A0), U6.1, U6.4 (-)
F1: D9.2 (A), D10.1 (K), R22.1, U2.30 (39_A1)
F2: D13.2 (A), D14.1 (K), R25.1, U2.29 (40_A2)
F3: D17.2 (A), D18.1 (K), R27.1, U2.28 (41_A3)
F4: D11.2 (A), D12.1 (K), R24.1, U2.27 (42_A4)
F5: D15.2 (A), D16.1 (K), R26.1, U2.26 (43_A5)
F6: J33.1 (G1), U2.25 (44_A6)
GND: C1.2, C2.1, C3.2, C4.2, C5.2, C6.2, C7.2, C8.2, C9.2, C10.2, C11.1, C12.1, C13.1, C14.1, C15.2, C16.1, C17.2, C18.2, C19.1, C21.2, C22.1, C23.1, D1.2 (A), D4.1 (K), D6.2 (A), D7.1 (K), D8.2 (A), D10.2 (A), D12.2 (A), D14.2 (A), D16.2 (A), D18.2 (A), D19.1 (K), J1.4, J2.4, J2.5, J2.6, J3.5, J3.6, J5.4, J6.4, J7.4, J8.4, J9.4, J10.2, J11.2, J12.2, J13.2, J14.2, J15.4, J16.4, J17.4 (GND), J18.2, J19.4, J19.5, J19.6, J20.4, J21.1, J22.4, J22.6, J22.8, J22.10, J23.1, J24.2, J25.2, J26.2, J27.2, J28.3, J29.3, J30.3, J31.3, J32.3, R2.2, R4.2, R9.2, R11.2, R16.2, R28.2, RV2.3, U1.2 (GND), U2.1 (GND), U2.22 (GND), U2.33 (GND), U3.2 (V-), U4.2 (GND), U4.5 (DIR), U5.4 (GND), U6.2 (V-), U7.2 (GND), U7.4 (NC), U8.2 (Anode), U9.2 (GND), U10.2 (V-); also elsewhere on the board
unnamed: C1.1, C2.2, JP1.1, U2.21 (+5V)
unnamed: C3.1, C6.1, J1.1, JP2.2, U1.6 (VCCB), U4.6 (VCCB)
unnamed: C7.1, J4.1 (G1)
unnamed: C9.1, J5.1, J6.1, J7.1, J8.1, JP3.2, R10.1, R12.1, U5.1 (VCCA)
unnamed: C19.2, C20.1, R20.1, U9.3 (+)
unnamed: C20.2, C21.1, R21.1, U9.4 (-)
unnamed: D1.1 (K), R1.2, RV1.1
unnamed: D2.1 (K), U3.5 (V+)
unnamed 50: D3.2 (A), K1.A2; also elsewhere on the board
unnamed: D4.2 (A), R6.2
unnamed: D5.2 (A), D6.1 (K), R7.1, R8.1, R9.1, R11.1, U6.3 (+)
unnamed: D7.2 (A), R18.1
unnamed: D8.1 (K), J26.1, J27.1, R18.2, R19.2, R21.2
unnamed: D9.1 (K), D13.1 (K), D17.1 (K), J28.1, J30.1, J32.1, JP5.2
unnamed 56: D19.2 (A); also elsewhere on the board
unnamed: J4.2 (G2), R3.2, R4.1, R5.2, U3.3 (+)
unnamed: J5.2, J6.2, J7.2, J8.2, R10.2, U5.2 (SCLA)
unnamed: J5.3, J6.3, J7.3, J8.3, R12.2, U5.3 (SDAA)
unnamed: J18.1, J19.2, J19.3
unnamed: J28.2, R22.2
unnamed: J29.2, R24.2
unnamed: J30.2, R25.2
unnamed: J31.2, R26.2
unnamed: J32.2, R27.2
unnamed: J33.2 (G2), U9.1, U10.3 (+)
unnamed: JP4.2, R23.2, R28.1, U8.1 (Cathode)
unnamed 68: R5.1, U3.4; also elsewhere on the board
unnamed 69: R15.1, R16.1; also elsewhere on the board
unnamed 70: R17.2; also elsewhere on the board
unnamed 71: R19.1, R20.2; also elsewhere on the board
unnamed: R2.1, RV1.3
unnamed: RV1.2, U3.1 (-)
unnamed: RV2.2, U10.1 (-)
RST: J22.5, U2.23 (RST)
Rx: J1.2, U4.4 (B)
Tx: J1.3, U1.4 (B)

Notes on the sheet:
current: 10 mA forward voltage: 2.1 V (green)
R = (5V - 4.096V) / 1mA = 904 Ohm R = (5V - 4.096V) / 1.2mA = 750 Ohm
RT334012 RTD34012
TRIG: Digital Pin Echo: Input Capture
MLeDec SCL SDA RX TX
MRiFwd MRiBck MLeFwd MLeBck MRiPwm MLePwm US4Trig US4Echo
Infrared Sensors
ADCs
Overcurrent Detection/Protection
SPI
Ultrasonic Sensors/SR04
Motor Signals
UART
I2C/SRF02
Precision Shunt VREF
Teensy++2.0
MLeInc MRiDec MRiInc MISO MOSI SCK SS OC OC_INT
US1Echo US1Trig US2Echo US2Trig US3Echo US3Trig
VBat Measurement
Decoupling Capacitors
LDO Regulator
Input Filter and Power Plugs
OC_INT
3x 12V BAT

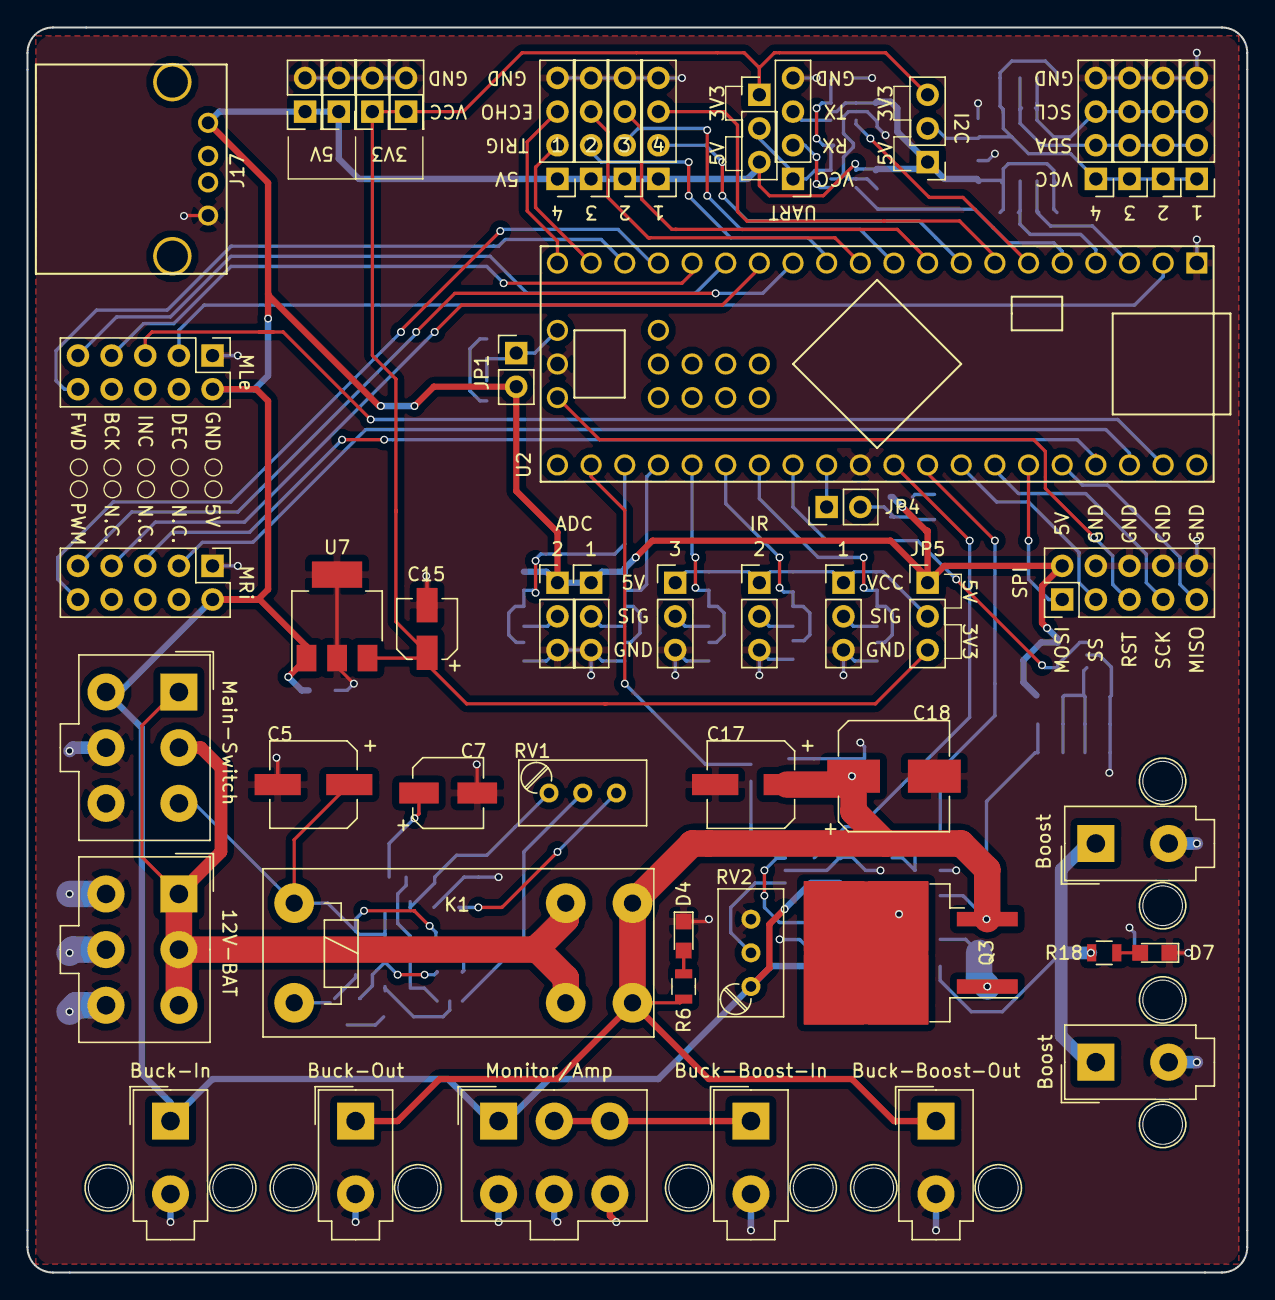
[picture p111: board robofriend.kicad_pcb from above]

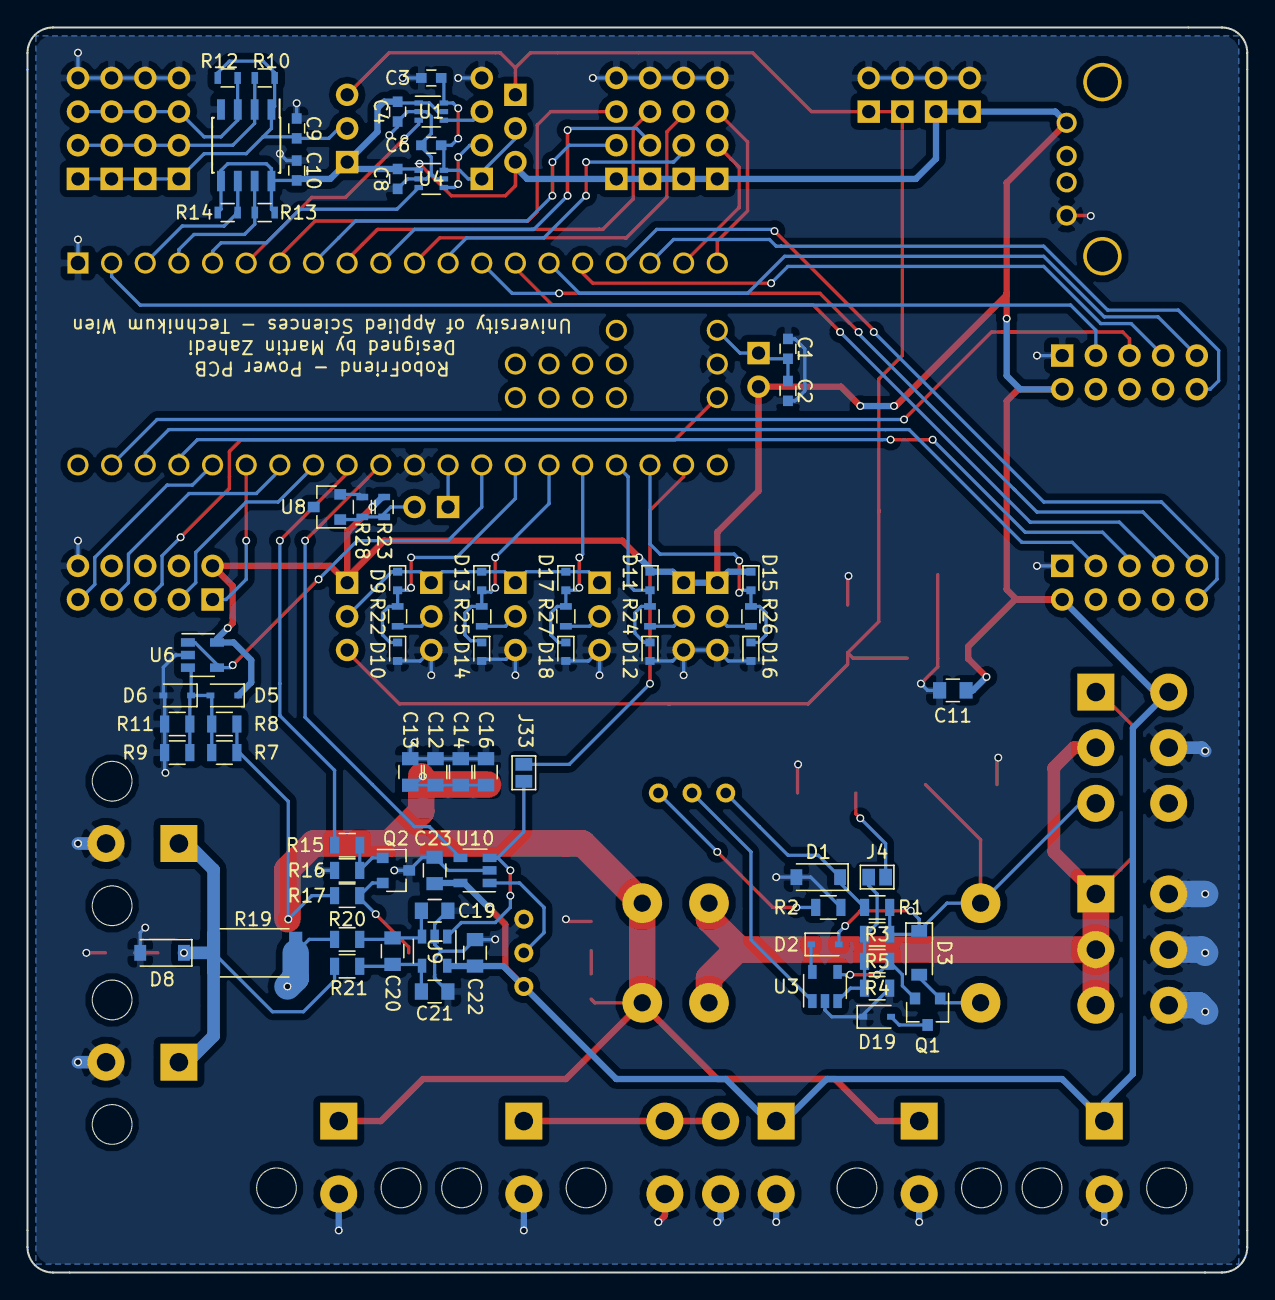
[picture p112: board robofriend.kicad_pcb from below]

Board: 2 copper layers, 92.1 x 94.0 mm, 124 parts (73 on the bottom side), 78 nets.

Other parts of the board:
Q1: NMOS; SOT-23
Q2: NPN; SOT-23
Q3: PMOS; TO-263-2

Their connections:
+12V: Q3.3; also elsewhere on the board
GND: Q2.3; also elsewhere on the board
unnamed 50: Q1.1; also elsewhere on the board
unnamed 56: Q1.3; also elsewhere on the board
unnamed 68: Q1.2; also elsewhere on the board
unnamed 69: Q2.1; also elsewhere on the board
unnamed 70: Q2.2, Q3.2; also elsewhere on the board
unnamed 71: Q3.1; also elsewhere on the board
