ProjectKitchen/RoboFriend/src/Teensy/support.h

/*
 * @file    support.h
 * @version v1.0
 * @date    15.11.2018
 * @author  mzahedi
 * @brief   DESCRIPTION
 */

#ifndef SUPPORT_H_
#define SUPPORT_H_

/******************************************************************* DEFINES */

#define DEBUG 0

#endif /* SUPPORT_H_ */
