ProjectKitchen/RoboFriend/src/Pi/python/constants.py

def getBatPercentMapping():
    return [[12.77,100], [12.76,99], [12.75,99], [12.74,99], [12.73,98], [12.72,98], [12.71,96], [12.7,95], [12.69,93],
            [12.68,91], [12.67,89], [12.66,86], [12.65,84], [12.64,83], [12.63,82], [12.62,81], [12.61,80], [12.6,78],
            [12.59,77], [12.58,75], [12.57,74], [12.56,73], [12.55,71], [12.54,70], [12.53,68], [12.52,67], [12.51,66],
            [12.5,65], [12.49,64], [12.48,63], [12.47,62], [12.46,61], [12.45,60], [12.44,59], [12.43,58], [12.42,57],
            [12.41,56], [12.4,54], [12.39,53], [12.38,51], [12.37,49], [12.36,48], [12.35,47], [12.34,46], [12.33,45],
            [12.32,44], [12.31,43], [12.3,41], [12.29,40], [12.28,39], [12.27,39], [12.26,38], [12.25,37], [12.24,36],
            [12.23,35], [12.22,35], [12.21,34], [12.2,34], [12.19,33], [12.18,32], [12.17,31], [12.16,30], [12.15,29],
            [12.14,28], [12.13,27], [12.12,25], [12.11,25], [12.1,24], [12.09,23], [12.08,22], [12.07,22], [12.06,21],
            [12.05,20], [12.04,20], [12.03,19], [12.02,18], [12.01,18], [12,17], [11.99,16], [11.98,15], [11.97,15],
            [11.96,14], [11.95,13], [11.94,12], [11.93,11], [11.92,10], [11.91,9], [11.9,9], [11.89,8], [11.88,7],
            [11.87,6], [11.86,6], [11.85,5], [11.84,4], [11.83,3], [11.82,2], [11.81,2], [11.8,1], [11.79,1], [11.78,0]]
