ProjectKitchen/RoboFriend/(commit log)

2017-06-22 Added Teensy files
2017-06-23 Changed SensorUpdate
2017-06-24 Hauptdatei und Sounds ( mjpg streamer und webserver fehlen noch)
2017-11-06 Add files via upload
    some corrections and added comments
    [webrobot.py]
2017-11-06 just correction in comment section no code changes
    [Teensy.ino]
2018-04-16 adding some ideas for finding a concept based on the state of the art. adding the first kicad pcb project. adding the first blinky teensy project
    [power-supply.kicad_pcb, power-supply.sch]
2018-05-20 starting pcb design and added teensy pinout table
    [pinout.xlsx, power-supply.sch]
2018-05-22 adding ltspice simulation for the reverse polarity protection circuit including the relay and the equivalent potentiometer to adjust the threshold voltage for the deep discharge protection circuit
2018-05-22 added simulation for adc measurement protection circuit, extended the input circuit with the vbat measurement
2018-05-23 added an overcurrent protection circuit to the ltspice simulation and starting the pcb design with the adc pins
    [power-supply.sch]
2018-05-23 overcurrent protection circuit adapted and added some beautification to the ltspice model
2018-05-24 changed the power switch for the boost converters to a high side switch and minor changes
2018-05-24 starting the pcb circuit design and the layout design. implementing a RJ45 plug, spi pin-header, adc inputs etc
    [pinout.xlsx, power-supply.kicad_pcb, power-supply.sch]
2018-05-24 removed RJ45 (should have been a RJ11) with a simple 03x01 pinheader for uart
    [power-supply.kicad_pcb, power-supply.sch]
2018-05-24 added the teensy schematic and footprint lib to the project, added the project from mr veigl to git, added teensy++2.0 to the schematic, added molex connectors, 02x05 pinheaders for motor control sig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
    [power-supply.kicad_pcb, power-supply.sch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]
2018-05-24 changed the 02x03 spi connector to a 02x05 connector with \CS
    [power-supply.kicad_pcb, power-supply.sch]
2018-05-25 added i2c pin-header, changed adc pinheader to 01x03 with vcc pin added
    [pinout.xlsx, power-supply.sch, robofriend.kicad_pcb, robofriend.sch]
2018-05-25 added LM4040 for AREF (Precision Micropower Shunt Voltage Reference)
    [robofriend.sch]
2018-05-25 added vin-ver-2 simulation, solved voltage divider complexity
    [robofriend.kicad_pcb, robofriend.sch]
2018-05-25 added sla-12vdc lib and footprint to the project
    [robofriend.kicad_pcb, robofriend.sch]
2018-06-18 adding simulations moduls for the paper and new pinout table
    [pinout.xlsx]
2018-06-18 minor changes to ideas
    [pinout.xlsx]
2018-06-21 adopting the ltspice circuit into kicad project - added reverse polarity protection, vbat measurement, overcurrent protection circuit. adapting connectors
    [robofriend.sch]
2018-06-26 adding interfaces for sensors, changing relay footprint, adapting power plugs, adapting further circuits, adapting parts and packages
    [pinout.xlsx, robofriend.kicad_pcb, robofriend.sch]
2018-06-27 applied v_charge molex plug and some beautifications
    [robofriend.sch]
2018-06-27 minor changes, pinout complete and beautifications
    [pinout.xlsx, robofriend.sch]
2018-06-28 beautification and minor corrections
    [robofriend.sch]
2018-07-02 added pegel shifter for uart and i2c, added pegel shifter simuluation file
    [pinout.xlsx, robofriend.sch]
2018-07-02 added usb a connector footprint to the kicad project
    [robofriend.sch]
2018-07-02 reviewing the schematic, missing the battery charge circuit still
    [robofriend.kicad_pcb, robofriend.sch]
2018-07-09 adapting overcurrent protection circuit, considering input common-mode voltage range, adding lm358 and minor improvements
    [robofriend.sch]
2018-07-10 commit before major change on the overcurrent protection circuit using INA193
    [robofriend.sch]
2018-07-10 new vbat measurement logic, adding an impedance converter
    [robofriend.sch]
2018-07-10 added a jumper for the external aref voltage since the internal vref may not be used if an external vref is being applied to the AREF pin
    [robofriend.sch]
2018-07-10 completed the new overcurrent protection circuit using INA193, added a free-wheeling diode for the consumer
    [robofriend.sch]
2018-07-12 minor corrections and beautification before implementing the battery charge logic
    [robofriend.sch]
2018-08-03 added new spice simulation for battery discharge and overcharge protection circuit
    [robofriend.sch]
2018-08-03 kicad circuit adopted to the new simulation circuit
    [robofriend.sch]
2018-08-07 completed first major version, waiting for feedback to start with the layout
    [pinout.xlsx, robofriend.sch]
2018-08-07 completed CvPcb to assosiate components and footprints
    [_saved_robofriend.sch, robofriend.sch]
2018-08-07 first steps of layouting done
    [_saved_robofriend.sch, robofriend.kicad_pcb, robofriend.sch]
2018-08-08 adopted pin headers in layout
    [leiterbahnbreite.xlsx, robofriend.kicad_pcb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]
2018-08-10 added plugs for buck-boost converter module
    [robofriend.kicad_pcb, robofriend.sch]
2018-08-10 removed extra jumpers and 100n capacitors for infrared sensors
    [robofriend.sch]
2018-08-10 removed 100n capacitors for i2c interface
    [robofriend.sch]
2018-08-10 A3 size in schematic editor
    [robofriend.sch]
2018-08-10 layout almost done. the decision about the level shifters needs to be made
    [robofriend.kicad_pcb, robofriend.sch]
2018-08-10 added PCA9517 for i2c level shifting
    [robofriend.kicad_pcb, robofriend.sch]
2018-08-10 schematic almost finished
    [robofriend.sch]
2018-08-10 layout complete, starting to route
    [robofriend.kicad_pcb]
2018-08-11 added 74lvc1t45 to schmatic (uart lvl shift), completed the schmeatic by doing last beautification
    [robofriend.kicad_pcb, robofriend.sch]
2018-08-11 completed CvPcb and generated netlist
    [robofriend.sch]
2018-08-11 added 74lvc1t45 to layout (uart lvl shift), completed the layout, now starting to route
    [robofriend.kicad_pcb]
2018-08-11 defined board edge cuts
    [robofriend.kicad_pcb]
2018-08-11 starting bom
    [bom.xls, robofriend.dsn, robofriend.kicad_pcb, robofriend.sch]
2018-08-12 correction on 74LVC1T45 circuit, DIR ref to VCCA, updated netlist in layout
    [bom.xls, robofriend.kicad_pcb, robofriend.sch]
2018-08-12 completed first version of bom, minor correction in schematic and layout adoptation, new plots available
    [bom.xls, robofriend.kicad_pcb, robofriend.sch, track-width.xlsx]
2018-08-12 bom completed after being checked
    [bom.xls]
2018-08-12 ready to route
    [robofriend.kicad_pcb]
2018-08-13 solved simulation problem with sw-module
    [robofriend.kicad_pcb]
2018-08-13 completed routing, generated gerber files .. ready to order :)
    [robofriend.kicad_pcb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]
2018-08-21 adapted bom (0603 parts), adapted relay symbol and footprint, ready to adapt the layout
    [bom-v1.xls, bom-v2.xls, bom.xls, robofriend.kicad_pcb, robofriend.sch]
2018-08-21 adapted the new relay layout, added more clearance to the parts, found a major bug regarding lm3940 and fixed it
    [bom-v2.xls, robofriend.kicad_pcb, robofriend.sch]
2018-08-21 added new usb connector footprint to layout, minor adaptations, generated gerber and drill files, new plot available
    [bom-v2.xls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]
2018-08-21 updated gerber to be sure
    [robofriend.kicad_pcb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]
2018-09-05 adapting paths to work in linux
    [robofriend.sch]
2018-09-05 generated netlist to see if something has changed
    [robofriend.kicad_pcb]
2018-09-05 adpated paths in linux, rescued some libs, minor clean-up
    [robofriend.sch]
2018-10-22 corrected npn, nmos and pmos orientation
    [robofriend.kicad_pcb, robofriend.sch]
2018-11-07 merged master into dev
    [accu_time_voltage.xlsx, left.xlsx, right.xlsx]
2018-11-17 pin adpation and more for teensy
2018-11-19 adding voltage divider simulation for vbat measurement and minor kicad project adaptations
    [robofriend.sch]
2024-05-08 changes for RP4 and X threading
2024-05-08 added composite/hdmi scripts, adapted proximity sensor thresholds
